benurapriyanidirisinghe/VOLT/src/volt_description/urdf/stl/mainbody.stl

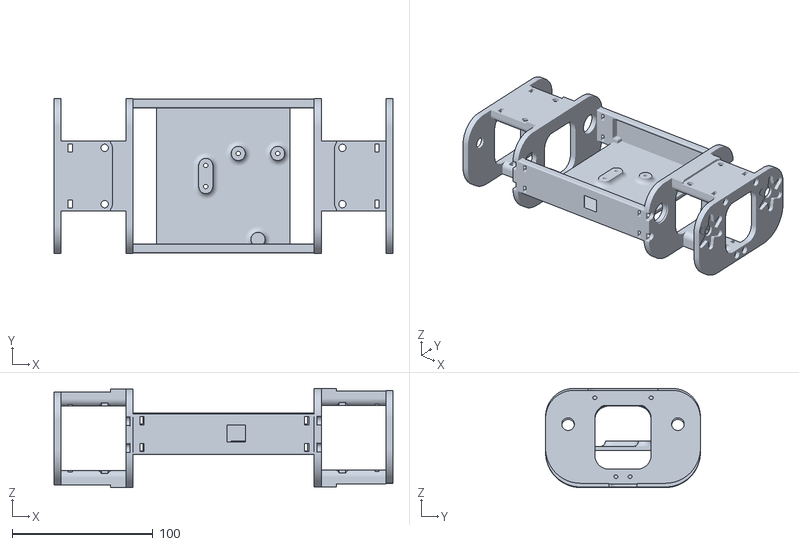
[picture p1: CAD file, 2026-07-06]
src/volt_description/urdf/stl/mainbody.stl
240.7 x 110.0 x 70.4
