benurapriyanidirisinghe/VOLT/src/volt_description/urdf/stl/rplidar_main.stl

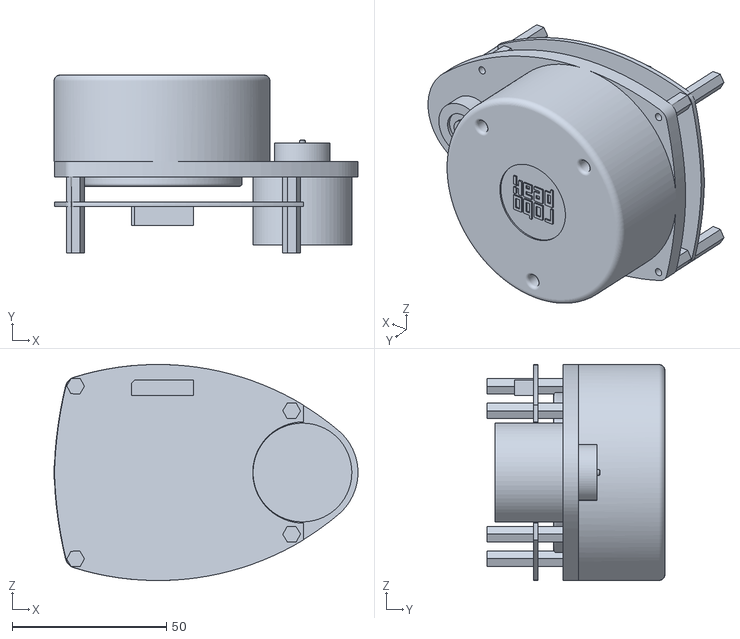
[picture p2: CAD file, 2026-07-06]
src/volt_description/urdf/stl/rplidar_main.stl
98.5 x 57.7 x 70.0
