benurapriyanidirisinghe/VOLT/src/volt_description/urdf/stl/rarm.stl

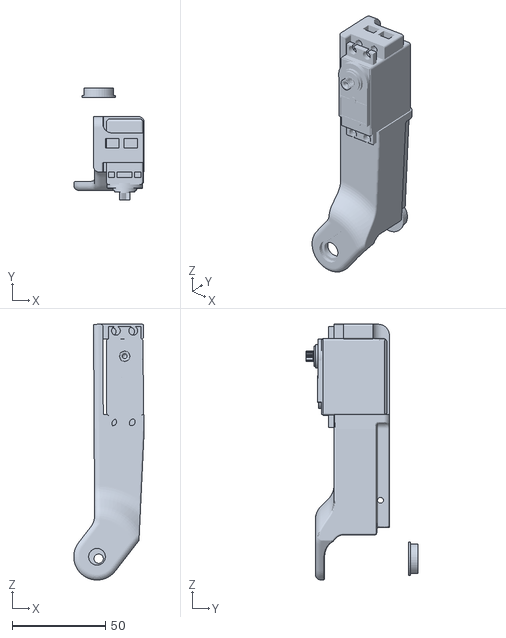
[picture p3: CAD file, 2026-07-06]
src/volt_description/urdf/stl/rarm.stl
37.9 x 60.2 x 137.5
