benurapriyanidirisinghe/VOLT/src/volt_description/urdf/stl/rarm_cover.stl

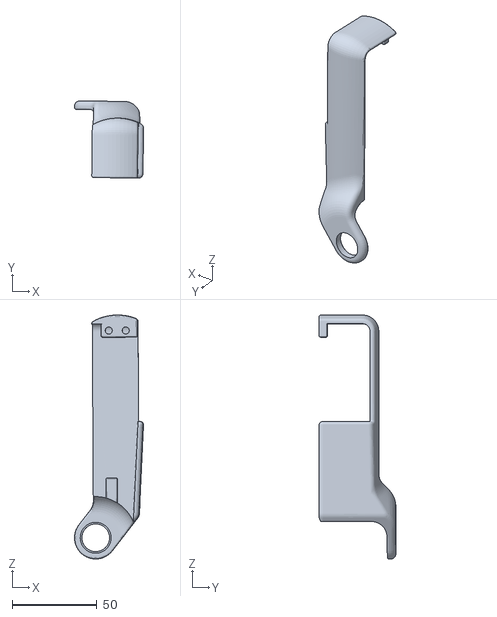
[picture p4: CAD file, 2026-07-06]
src/volt_description/urdf/stl/rarm_cover.stl
40.7 x 45.4 x 143.6
