benurapriyanidirisinghe/VOLT/src/volt_description/urdf/stl/foot.stl

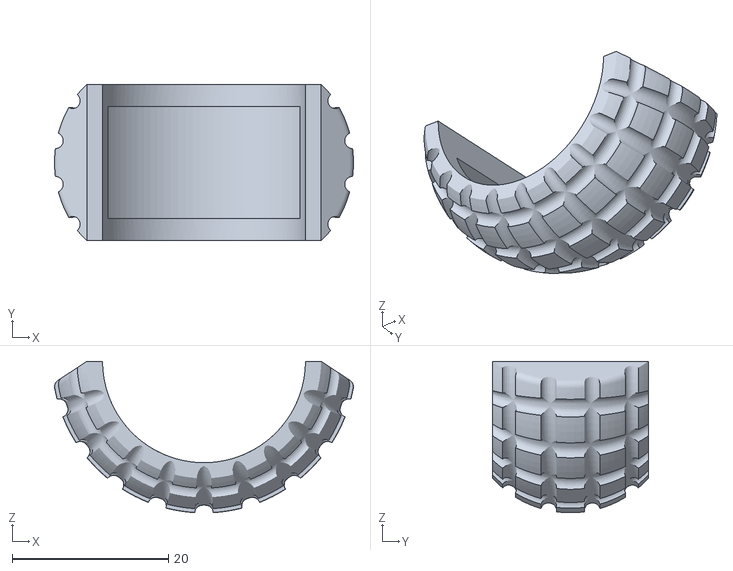
[picture p5: CAD file, 2026-07-06]
src/volt_description/urdf/stl/foot.stl
38.3 x 20.0 x 19.4
