benurapriyanidirisinghe/VOLT/src/volt_description/urdf/stl/backpart.stl

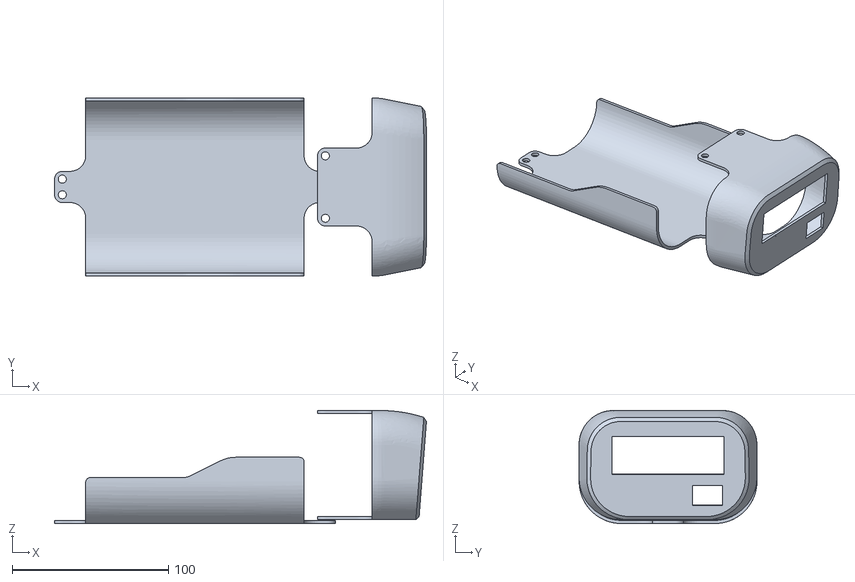
[picture p6: CAD file, 2026-07-06]
src/volt_description/urdf/stl/backpart.stl
238.4 x 114.1 x 72.5
