benurapriyanidirisinghe/VOLT/src/volt_description/urdf/stl/rshoulder.stl

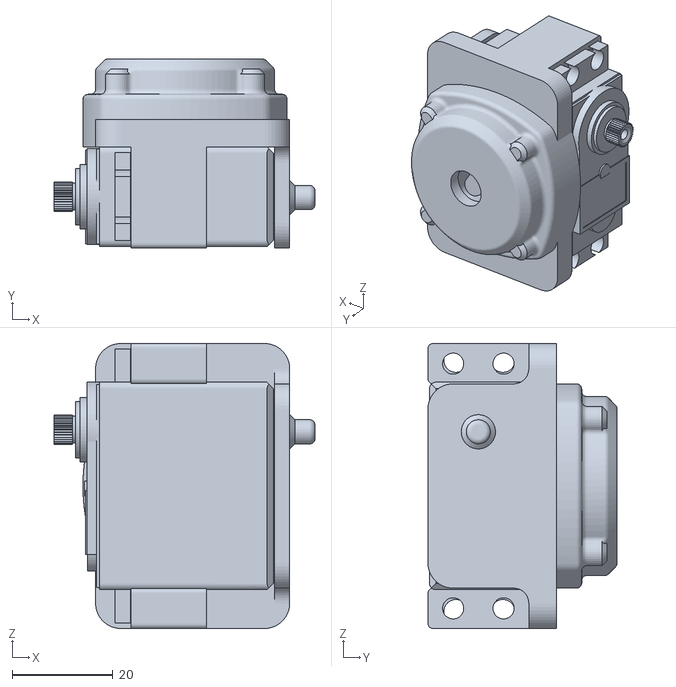
[picture p7: CAD file, 2026-07-06]
src/volt_description/urdf/stl/rshoulder.stl
51.7 x 37.5 x 56.5
