benurapriyanidirisinghe/VOLT/src/volt_description/urdf/stl/lfoot.stl

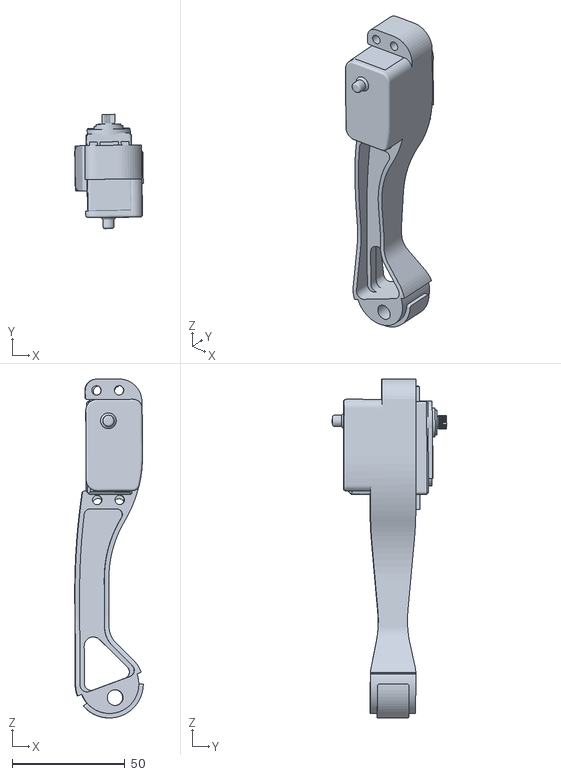
[picture p8: CAD file, 2026-07-06]
src/volt_description/urdf/stl/lfoot.stl
30.4 x 50.7 x 150.0
