benurapriyanidirisinghe/VOLT/src/volt_description/urdf/stl/frontpart.stl

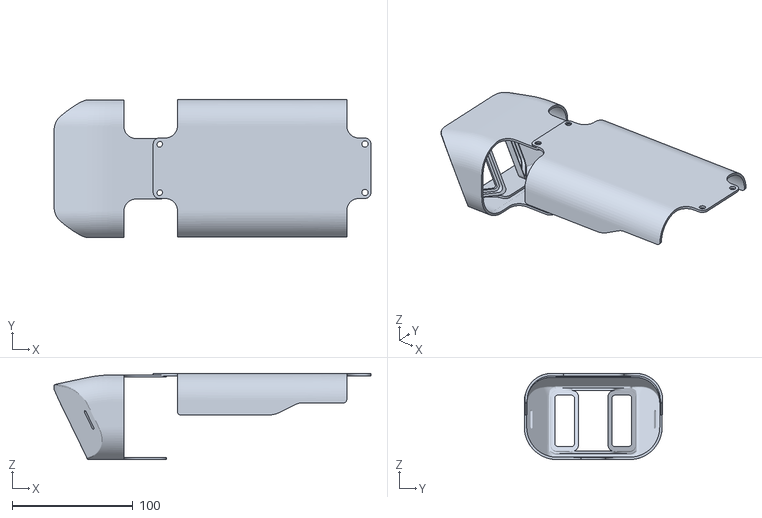
[picture p9: CAD file, 2026-07-06]
src/volt_description/urdf/stl/frontpart.stl
262.0 x 114.5 x 71.2
