benurapriyanidirisinghe/VOLT/(list of files, cad)

Other CAD files:
src/volt_description/urdf/stl/larm_cover.stl
src/volt_description/urdf/stl/rfoot.stl
src/volt_description/urdf/stl/larm.stl
src/volt_description/urdf/stl/lshoulder.stl
