benurapriyanidirisinghe/VOLT/src/volt_description/urdf/volt.urdf.xacro

<?xml version="1.0"?>
<robot xmlns:xacro="http://www.ros.org/wiki/xacro" name="spot_micro_rviz">

<xacro:include filename="$(find volt_description)/urdf/ros2_control.xacro"/>
<xacro:include filename="$(find volt_description)/urdf/gazebo.xacro"/>

<xacro:arg name="sim_backend" default="gz"/>
<xacro:arg name="actuator_profile" default="simulation"/>

  <material name="yellow">
    <color rgba="0.92 0.83 0.0 1"/>
  </material>
  <material name="black">
    <color rgba="0.1 0.1 0.1 1"/>
  </material>
  <material name="grey">
    <color rgba="0.6 0.6 0.6 1"/>
  </material>

  <!-- Params -->

  <!-- Keep the proven simulation profile as default.  The opt-in td8130mg
       profile models the physical servo under load: velocity capped at the
       firmware's 240 deg/s slew ceiling (4.1888 rad/s; the servo free speed
       is ~375 deg/s so firmware is the binding limit), effort capped at a
       derated 2.8 N.m stall torque (TD-8130MG ~30 kg.cm at 6 V).  With the
       stiffer tracking gain in ros2_control.xacro the effort clamp - not an
       artificially soft gain - becomes what slows a loaded joint, so Gazebo
       reproduces load-dependent tracking lag.  ROS/IK joint limits and
       physical calibration are unchanged. -->
  <xacro:property name="hardware_actuators" value="${'$(arg actuator_profile)' == 'td8130mg'}"/>
  <xacro:property name="shoulder_velocity" value="${4.1888 if hardware_actuators else 2.0}"/>
  <xacro:property name="leg_velocity" value="${4.1888 if hardware_actuators else 3.0}"/>
  <xacro:property name="foot_velocity" value="${4.1888 if hardware_actuators else 4.5}"/>
  <xacro:property name="joint_effort" value="${2.8 if hardware_actuators else 20.0}"/>
  <xacro:property name="joint_damping" value="${0.35 if hardware_actuators else 0.6}"/>
  <xacro:property name="joint_friction" value="${0.10 if hardware_actuators else 0.1}"/>

  <xacro:property name="body_length" value="0.140" />
  <xacro:property name="body_width" value="0.110" />
  <xacro:property name="body_height" value="0.070" />

  <xacro:property name="lidar_length" value="0.0985" />
  <xacro:property name="lidar_width" value="0.0577" />
  <xacro:property name="lidar_height" value="0.070" />


  <xacro:property name="front_length" value="0.058" />
  <xacro:property name="rear_length" value="0.040" />

  <xacro:property name="shoulder_length" value="0.044" />
  <xacro:property name="shoulder_width" value="0.038" />

  <xacro:property name="leg_length" value="0.1075" />
  <xacro:property name="foot_length" value="0.130" />

  <xacro:property name="toe_radius" value="0.020" />
  <!--  <xacro:property name="toe_radius" value="0.014" /> -->
  <xacro:property name="toe_width" value="0.020" />
  <xacro:property name="shift" value="0.055" />
  <xacro:property name="shiftx" value="0.093" />
  <xacro:property name="shifty" value="0.039" />

  <!-- Macros -->

  <xacro:macro name="gen_shoulder" params="name left">
    <link name="${name}">
      <visual>
        <xacro:if value="${left}">
        <geometry>
          <mesh filename="package://volt_description/urdf/stl/lshoulder.stl" scale="0.001 0.001 0.001"/>
        </geometry>
        <origin rpy="0 0 3.14159" xyz="0.135 0.015 -0.01"/>
        </xacro:if>
        <xacro:unless value="${left}">
        <geometry>
          <mesh filename="package://volt_description/urdf/stl/rshoulder.stl" scale="0.001 0.001 0.001"/>
        </geometry>
        <origin rpy="0 0 3.14159" xyz="0.135 0.095 -0.01"/>
        </xacro:unless>
        <material name="black"/>
      </visual>
      <collision>
        <geometry>
          <box size="${shoulder_length} ${shoulder_width} ${body_height}"/>
        </geometry>
        <origin rpy="0 0 0" xyz="0 0 0"/>
      </collision>
      <inertial>
        <mass value="0.10"/>
        <inertia ixx="0.0002" ixy="0" ixz="0" iyy="0.0002" iyz="0" izz="0.0002" />
      </inertial>
    </link>
  </xacro:macro>

  <xacro:macro name="gen_shoulder_joint" params="pos shiftx shifty">
    <joint name="${pos}_shoulder" type="revolute">
      <parent link="base_link"/>
      <child link="${pos}_shoulder_link"/>
      <axis xyz="1 0 0"/>
      <origin rpy="0 0 0" xyz="${shiftx} ${shifty} 0"/>
      <limit effort="${joint_effort}" lower="-0.548" upper="0.548" velocity="${shoulder_velocity}"/>
      <dynamics damping="${joint_damping}" friction="${joint_friction}"/>
    </joint>
  </xacro:macro>

  <xacro:macro name="gen_leg" params="name left">
    <link name="${name}_cover">
      <visual>
        <xacro:if value="${left}">
        <geometry>
          <mesh filename="package://volt_description/urdf/stl/larm_cover.stl" scale="0.001 0.001 0.001"/>
        </geometry>
        <origin rpy="0 -0.139 3.14159" xyz="0.130 -0.040 -0.025"/>
        </xacro:if>
        <xacro:unless value="${left}">
        <geometry>
          <mesh filename="package://volt_description/urdf/stl/rarm_cover.stl" scale="0.001 0.001 0.001"/>
        </geometry>
        <origin rpy="0 -0.139 3.14159" xyz="0.130 0.15 -0.025"/>
        </xacro:unless>
        <material name="grey"/>
      </visual>
    </link>
    <link name="${name}">
      <visual>
        <xacro:if value="${left}">
        <geometry>
          <mesh filename="package://volt_description/urdf/stl/larm.stl" scale="0.001 0.001 0.001"/>
        </geometry>
        <origin rpy="0 -0.139 3.14159" xyz="0.130 -0.040 -0.025"/>
        </xacro:if>
        <xacro:unless value="${left}">
        <geometry>
          <mesh filename="package://volt_description/urdf/stl/rarm.stl" scale="0.001 0.001 0.001"/>
        </geometry>
        <origin rpy="0 -0.139 3.14159" xyz="0.130 0.15 -0.025"/>
        </xacro:unless>
        <material name="black"/>
<!--        <geometry>
          <box size="0.028 0.036 ${leg_length}"/>
        </geometry>
        <origin rpy="0.0 0.0 0.0" xyz="0.0 0.0 -0.050"/>
        <material name="yellow"/>-->
      </visual>
      <collision>
        <origin rpy="0.0 0.0 0.0" xyz="0.0 0.0 -0.050"/>
        <geometry>
          <box size="0.028 0.036 ${leg_length}"/>
        </geometry>
      </collision>
      <inertial>
        <mass value="0.15"/>
        <inertia ixx="0.0003" ixy="0" ixz="0" iyy="0.0003" iyz="0" izz="0.0003" />
      </inertial>
    </link>
  </xacro:macro>

  <xacro:macro name="gen_leg_joint" params="pos shift">
    <joint name="${pos}_leg" type="revolute">
      <parent link="${pos}_shoulder_link"/>
      <child link="${pos}_leg_link"/>
      <axis xyz="0 1 0"/>
      <origin rpy="0 0 0" xyz="0 ${shift} 0"/>
      <limit effort="${joint_effort}" lower="-2.666" upper="1.548" velocity="${leg_velocity}"/>
      <dynamics damping="${joint_damping}" friction="${joint_friction}"/>
    </joint>

    <joint name="${pos}_leg_cover_joint" type="fixed">
    <parent link="${pos}_leg_link"/>
    <child link="${pos}_leg_link_cover"/>
        <origin xyz="0 0 0"/>
  </joint>  
  </xacro:macro>

  <xacro:macro name="gen_foot" params="name left">
    <link name="${name}">
      <visual>
        <xacro:if value="${left}">
        <geometry>
          <mesh filename="package://volt_description/urdf/stl/lfoot.stl" scale="0.001 0.001 0.001"/>
        </geometry>
        <origin rpy="0 0 3.14159" xyz="0.120 -0.04 0.1"/>
        </xacro:if>
        <xacro:unless value="${left}">
        <geometry>
          <mesh filename="package://volt_description/urdf/stl/rfoot.stl" scale="0.001 0.001 0.001"/>
        </geometry>
        <origin rpy="0 0 3.14159" xyz="0.120 0.15 0.1"/>
        </xacro:unless>
        <material name="black"/>
      </visual>
      <collision>
        <geometry>
          <box size="0.026 0.020 ${foot_length}"/>
        </geometry>
        <origin rpy="0.0 0.0 0.0" xyz="0.0 0.0 -0.050"/>
      </collision>
      <inertial>
        <mass value="0.1"/>
        <inertia ixx="0.0003" ixy="0" ixz="0" iyy="0.0003" iyz="0" izz="0.0003" />
      </inertial>
    </link>
  </xacro:macro>

  <xacro:macro name="gen_foot_joint" params="pos">
    <joint name="${pos}_foot" type="revolute">
      <parent link="${pos}_leg_link"/>
      <child link="${pos}_foot_link"/>
      <axis xyz="0 1 0"/>
      <origin rpy="0 0 0" xyz="0 0 -${leg_length}"/>
      <limit effort="${joint_effort}" lower="-2.6" upper="0.1" velocity="${foot_velocity}"/>
      <dynamics damping="${joint_damping}" friction="${joint_friction}"/>
    </joint>
  </xacro:macro>

  <xacro:macro name="gen_toe" params="name">
    <link name="${name}">
      <visual>
        <geometry>
        <mesh filename="package://volt_description/urdf/stl/foot.stl" scale="0.001 0.001 0.001"/>
        </geometry>
        <origin rpy="0 -0.40010 3.14159" xyz="0.00 0.01 0.015"/>
        <material name="grey"/>
      </visual>
      <collision>
        <geometry>
          <sphere radius="${toe_radius}" />
        </geometry>
        <origin rpy="0 0 0" xyz="0 0 ${toe_radius}"/>
        <contact_coefficients mu="1.1" />
      </collision>
      <inertial>
        <mass value="0.05"/>
        <inertia ixx="0.00003" ixy="0" ixz="0" iyy="0.00003" iyz="0" izz="0.00003" />
      </inertial>
    </link>
  </xacro:macro>

 <xacro:macro name="gen_toe_joint" params="pos">
    <joint name="${pos}_toe" type="fixed">
      <parent link="${pos}_foot_link"/>
      <child link="${pos}_toe_link"/>
      <origin xyz="0 0 -${foot_length}"/>
    </joint>
  </xacro:macro>

  <xacro:macro name="gen_full_leg_joint" params="pos shiftx shifty shift left">
    <xacro:gen_shoulder name="${pos}_shoulder_link" left="${left}"/>
    <xacro:gen_leg name="${pos}_leg_link" left="${left}"/>
    <xacro:gen_foot name="${pos}_foot_link" left="${left}"/>
    <xacro:gen_toe name="${pos}_toe_link"/>

    <xacro:gen_shoulder_joint pos="${pos}" shiftx="${shiftx}" shifty="${shifty}"/>
    <xacro:gen_leg_joint pos="${pos}" shift="${shift}"/>
    <xacro:gen_foot_joint pos="${pos}"/>
    <xacro:gen_toe_joint pos="${pos}"/>
  </xacro:macro>

  <!-- Robot Body -->

  <link name="base_link">
    <visual>
      <geometry>
        <mesh filename="package://volt_description/urdf/stl/mainbody.stl" scale="0.001 0.001 0.001"/>
      </geometry>
      <material name="black"/> 
      <origin rpy="0 0 0" xyz="-0.042 -0.055 -0.010"/>
    </visual>
    <collision>
      <geometry>
        <box size="${body_length} ${body_width} ${body_height}"/>
      </geometry>
      <origin rpy="0 0 0" xyz="0 0 0"/>
    </collision>
    <inertial>
      <mass value="2.80"/>
      <inertia ixx="0.03" ixy="0" ixz="0" iyy="0.04" iyz="0" izz="0.05" />
    </inertial>
  </link>

  <!-- Lidar Backpack -->

   <link name="lidar_link">
    <visual>
      <geometry>
        <mesh filename="package://volt_description/urdf/stl/rplidar_main.stl" scale="0.001 0.001 0.001"/>
      </geometry>
      <material name="black"/> 
      <origin rpy="1.57075 0 0" xyz="${-lidar_length/2+0.015} ${lidar_width/2+0.007} 0"/>
    </visual>
    <collision>
      <geometry>
        <box size="${lidar_length} ${lidar_width} ${lidar_height}"/>
      </geometry>
      <origin rpy="0 0 0" xyz="0 0 0"/>
    </collision>
    <inertial>
      <mass value="0.50"/>
      <inertia ixx="0.001" ixy="0" ixz="0" iyy="0.001" iyz="0" izz="0.001" />
    </inertial>
  </link>
  <joint name="base_lidar" type="fixed">
    <parent link="base_link"/>
    <child link="lidar_link"/>
        <origin xyz="0 0 ${body_height/2}"/>
  </joint>  

  <link name="rear_link">
    <visual>
      <geometry>
        <mesh filename="package://volt_description/urdf/stl/backpart.stl" scale="0.001 0.001 0.001"/>
      </geometry>
      <origin rpy="0 0 3.14159" xyz="-0.032 -0 -0.035"/>
      <material name="grey"/>
    </visual>
    <collision>
      <geometry>
        <box size="${rear_length} ${body_width} ${body_height}"/>
      </geometry>
      <origin rpy="0 0 0" xyz="0.135 0 0"/>
    </collision>
    <inertial>
      <mass value="0.20"/>
      <inertia ixx="0.002" ixy="0" ixz="0" iyy="0.002" iyz="0" izz="0.002" />
    </inertial>
  </link>
  <joint name="base_rear" type="fixed">
    <parent link="base_link"/>
    <child link="rear_link"/>
  </joint>

  <link name="front_link">
    <visual>
      <geometry>
        <mesh filename="package://volt_description/urdf/stl/frontpart.stl" scale="0.001 0.001 0.001"/>
      </geometry>
      <origin rpy="0 0 3.14159" xyz="0.040 0.055 -0.010"/>
      <material name="grey"/>
    </visual>
    <collision>
      <geometry>
        <box size="${front_length} ${body_width} ${body_height}"/>
      </geometry>
      <origin rpy="0 0 0" xyz="-0.145 0 0"/>
    </collision>
    <inertial>
      <mass value="0.20"/>
      <inertia ixx="0.002" ixy="0" ixz="0" iyy="0.002" iyz="0" izz="0.002" />
    </inertial>
  </link>
  <joint name="base_front" type="fixed">
    <parent link="base_link"/>
    <child link="front_link"/>
  </joint>

  <!-- create Legs -->

  <xacro:gen_full_leg_joint pos="front_left" shiftx="${shiftx}" shifty="${shifty}" shift="${shift}" left="true"/>
  <xacro:gen_full_leg_joint pos="front_right" shiftx="${shiftx}" shifty="-${shifty}" shift="-${shift}" left="false"/>
  <xacro:gen_full_leg_joint pos="rear_left" shiftx="-${shiftx}" shifty="${shifty}" shift="${shift}" left="true"/>
  <xacro:gen_full_leg_joint pos="rear_right" shiftx="-${shiftx}" shifty="-${shifty}" shift="-${shift}" left="false"/>
  <xacro:volt_ros2_control sim_backend="$(arg sim_backend)"/>
</robot>
