benurapriyanidirisinghe/VOLT/src/volt_description/config/real_robot_profiles.yaml

version: 1

# Canonical SI units except fields explicitly suffixed with _deg.  These are
# trajectory/conditioning values only; servo calibration remains in
# servo_calibration.yaml.  Every profile's gait overlay must re-pass the
# gait engine's servo-budget sweep when applied, so a profile cannot demand
# joint speeds the TD-8130MG cannot deliver under load.
profiles:
  SIMULATION:
    gait: trot
    cycle_duration: 1.10
    stride_length: 0.070
    lateral_stride_width: 0.020
    step_height: 0.024
    duty_factor: 0.58
    body_height: 0.200
    body_x: 0.0
    body_y: 0.0
    body_roll_deg: 0.0
    body_pitch_deg: 0.0
    body_yaw_deg: 0.0
    max_joint_velocity_deg_s: 190.0
    max_joint_acceleration_deg_s2: 6000.0
    smoothing_amount: 0.0
    touchdown_softness: 0.18
    stance_width: 0.104
    command_acceleration: 0.08
    velocity_filter_alpha: 0.30

  # First loaded-floor profile: lateral-sequence amble, one leg at a time,
  # three feet always planted, small stride, bounded servo dynamics.
  REAL_DIAGNOSTIC:
    gait: amble
    cycle_duration: 2.40
    stride_length: 0.030
    lateral_stride_width: 0.010
    step_height: 0.022
    duty_factor: 0.80
    # DO NOT raise this without checking the resulting SERVO angles against the
    # leg's mechanical range, not just the software limits.
    #
    # 0.210 was tried here because a straighter leg has a shorter knee moment
    # arm, dropping the front-knee load from 1.855 N.m (105% of usable stall)
    # to 1.317 N.m (75%). The IK accepted it and every software limit passed --
    # but it drove the knee servos about 30 deg past any angle the robot had
    # ever run at: ch5 went from 92.8..112.8 to 116.2..143.2 against a stand
    # pose of 118.05. The front-right foot hit its mechanical stop and jammed.
    #
    # servo_calibration.yaml's [30,180] for ch5/ch8 is the servo's nominal
    # travel, NOT the linkage's usable range, so it did not catch this. At
    # 0.200 the knees command 99.9..120.0, which is the band the robot has
    # demonstrably operated in.
    body_height: 0.200
    body_x: 0.0
    body_y: 0.0
    body_roll_deg: 0.0
    body_pitch_deg: 0.0
    body_yaw_deg: 0.0
    # Raised from 100 / 2400, which silently truncated the commanded gait:
    # the amble peaks at 139 deg/s and the trot at 176 deg/s, so the old
    # clamps discarded motion on 4.7% and 10.7% of joint-samples per cycle.
    # 190 / 6000 matches the SIMULATION profile and stays under the firmware
    # slew ceiling of 240 deg/s, so nothing is asked to exceed its tuning.
    max_joint_velocity_deg_s: 190.0
    max_joint_acceleration_deg_s2: 6000.0
    smoothing_amount: 0.15
    touchdown_softness: 0.30
    stance_width: 0.104
    command_acceleration: 0.06
    velocity_filter_alpha: 0.25

  REAL_SAFE:
    gait: trot
    cycle_duration: 1.20
    stride_length: 0.045
    lateral_stride_width: 0.008
    step_height: 0.024
    duty_factor: 0.62
    body_height: 0.195
    body_x: -0.004
    body_y: 0.0
    body_roll_deg: 0.0
    body_pitch_deg: 1.0
    body_yaw_deg: 0.0
    max_joint_velocity_deg_s: 150.0
    max_joint_acceleration_deg_s2: 3600.0
    smoothing_amount: 0.12
    touchdown_softness: 0.28
    stance_width: 0.104
    command_acceleration: 0.08
    velocity_filter_alpha: 0.30

  REAL_NORMAL:
    gait: trot
    cycle_duration: 1.05
    stride_length: 0.055
    lateral_stride_width: 0.012
    step_height: 0.024
    duty_factor: 0.58
    body_height: 0.195
    body_x: -0.003
    body_y: 0.0
    body_roll_deg: 0.0
    body_pitch_deg: 1.0
    body_yaw_deg: 0.0
    max_joint_velocity_deg_s: 175.0
    max_joint_acceleration_deg_s2: 4800.0
    smoothing_amount: 0.10
    touchdown_softness: 0.24
    stance_width: 0.104
    command_acceleration: 0.08
    velocity_filter_alpha: 0.30
