benurapriyanidirisinghe/VOLT/src/volt_description/scripts/volt_gait_controller.py

#!/usr/bin/env python3

"""VOLT gait engine: two servo-budgeted gaits with world-locked stance.

Ground-up rebuild.  The previous engine carried nine gaits across four code
paths; walking quality on the real robot was limited not by the trajectory
shapes but by physics that none of those paths modeled: a TD-8130MG under
load does not track an arbitrary command.  This engine keeps exactly two
gaits and builds the servo's speed-torque reality into the *configuration
contract* instead of hoping the firmware slew limiter cleans up after an
infeasible plan.

Gaits
-----
``trot``   Two-beat diagonal gait (FL+RR / FR+RL half a cycle apart) with a
           duty factor above 0.5, so short four-foot support windows exist
           for load transfer between diagonal pairs.
``amble``  Four-beat lateral-sequence walk (RL, FL, RR, FR each a quarter
           cycle apart) with a high duty factor -- three feet are always
           planted -- plus a lateral body sway that leans the body away
           from whichever side is swinging.

Servo budget
------------
The physical insight the old engine missed: the *swing* leg is unloaded (it
carries only its own inertia, so the servo runs near its ~375 deg/s free
speed), while the *stance* legs carry the body but rotate slowly.  The
budgets therefore differ per phase:

  stance joints (loaded):    <= 80 deg/s commanded
  swing joints (unloaded):   <= 190 deg/s commanded (firmware ceiling 240)

``validate_servo_budget`` numerically sweeps one full cycle at the gait's
maximum command through the real IK and rejects any configuration whose
commanded joint speeds break those budgets.  A gait config that loads is a
gait config the servos can execute; nothing downstream needs to clip.

World locking
-------------
During stance a foot holds a fixed *world* point while the integrated body
pose moves over it, so planted feet cannot skate.  Swing targets are frozen
world-frame touchdown points computed from the commanded twist when the
foot lifts; command changes never jerk an airborne foot.
"""

import math
from pathlib import Path

import yaml

from volt_kinematics import (
    LEG_ORDER,
    JOINT_NAMES,
    NOMINAL_FEET,
    clamp,
    feet_to_joint_positions_diagnostic,
    smootherstep,
)


# --------------------------------------------------------------------------
# Public constants
# --------------------------------------------------------------------------

TROT_PHASE_OFFSETS = {
    "front_left": 0.0,
    "rear_right": 0.0,
    "front_right": 0.5,
    "rear_left": 0.5,
}

# Lateral-sequence amble: each hind foot is followed by the fore foot on the
# SAME side.  Listed below in swing order, because the leg with the largest
# offset reaches the duty boundary first:  RR -> FR -> RL -> FL.
#
# The previous table had the offsets reversed within each side pair, so the
# fore foot led the hind and the robot walked a diagonal-sequence gait
# (hind followed by the OPPOSITE fore) despite the comment claiming lateral.
# validate_phase_structure() now fails at import if that recurs.
#
# The half-cycle grouping matters for the body sway in _body_motion(): both
# right feet swing during the first half cycle and both left feet during the
# second, which is what lets a plain sine of the cycle phase lean the body
# away from whichever side is currently swinging.
AMBLE_PHASE_OFFSETS = {
    "rear_right": 0.75,
    "front_right": 0.5,
    "rear_left": 0.25,
    "front_left": 0.0,
}

# Every historical gait name maps onto one of the two surviving gaits so
# saved profiles, old GUI messages, and muscle memory keep working.
GAIT_ALIASES = {
    "walk": "amble",
    "slow_crawl": "amble",
    "diagnostic_crawl": "amble",
    "spot_walk": "amble",
    "spotmicro_video_walk": "amble",
    "legacy_walk": "amble",
    "real_trot": "trot",
    "load_safe_trot": "trot",
    "real_safe_trot": "trot",
    "slow_trot": "trot",
    "normal_trot": "trot",
    "fast_trot": "trot",
}

# RUN is a trot pattern, not a new coordination: the same diagonal pairs, run
# faster and with a shorter stance.  A true run needs duty < 0.5 and a flight
# phase; on open-loop hobby servos with a documented saturation history that
# is approached in steps, not declared.  It ships at the fastest cadence the
# servo budget will accept.
RUN_PHASE_OFFSETS = dict(TROT_PHASE_OFFSETS)

GAIT_PHASE_OFFSETS = {
    "trot": TROT_PHASE_OFFSETS,
    "amble": AMBLE_PHASE_OFFSETS,
    "run": RUN_PHASE_OFFSETS,
}

# Config keys: every gait section must provide exactly these numeric fields.
GAIT_PARAMETER_NAMES = (
    "cycle_period",
    "duty_factor",
    "step_height",
    "max_x",
    "max_y",
    "max_yaw",
    "settle_time",
    "body_sway_y",
    "body_height_offset",
    "velocity_filter_alpha",
    "command_acceleration",
    "hardware_speed_scale",
    "joint_velocity_limit_deg_s",
    "joint_acceleration_limit_deg_s2",
    "stance_velocity_budget_deg_s",
    "swing_velocity_budget_deg_s",
    # Speed-scaled cadence. See resolved_cadence().
    "speed_scaled_cadence",
    "stride_target_m",
    "cadence_min_hz",
    "stride_floor_m",
    # Additive heading bias; see the yaw-trim note in validate_servo_budget.
    "yaw_trim_limit_rad_s",
    # Push the supporting diagonal up while the other pair swings.
    "stance_push_m",
)

def _phase_separation(first, second):
    """Circular distance between two phase offsets, in cycles (0 .. 0.5)."""
    diff = abs(float(first) - float(second)) % 1.0
    return min(diff, 1.0 - diff)


def _swing_order(offsets):
    """Legs in the order their swings begin.

    A leg's local phase is (global phase + its offset) and swing starts once
    that crosses the duty boundary, so the leg with the LARGEST offset
    reaches the boundary first.
    """
    return sorted(offsets, key=lambda leg: -offsets[leg])


def validate_phase_structure(name, offsets):
    """Assert a gait's phase table really encodes the coordination it claims.

    A permuted phase table is not malformed -- it is four valid numbers in
    the wrong places -- so nothing downstream can catch it, and the failure
    mode is silent: the robot walks, just in the wrong gait. (Measured on
    hardware: a trot whose legs are exchanged at one end becomes a pace, and
    every length and finiteness check on the command path still passes.)
    These checks make that specific class of regression fail at import.
    """
    if set(offsets) != set(LEG_ORDER):
        raise ValueError(
            "%s phase table must cover exactly %s" % (name, list(LEG_ORDER))
        )

    if name in ("trot", "run"):
        # Two-beat: diagonal partners strike together, and the two diagonal
        # pairs are half a cycle apart (which also makes each ipsilateral
        # pair half a cycle apart -- the property that distinguishes a trot
        # from a pace).
        for a, b in (("front_left", "rear_right"), ("front_right", "rear_left")):
            gap = _phase_separation(offsets[a], offsets[b])
            if gap > 0.02:
                raise ValueError(
                    "%s: diagonal pair %s/%s is %.3f cycles apart, expected 0 "
                    "(a trot strikes diagonal feet together)"
                    % (name, a, b, gap)
                )
        for a, b in (("front_left", "rear_left"), ("front_right", "rear_right")):
            gap = _phase_separation(offsets[a], offsets[b])
            if abs(gap - 0.5) > 0.02:
                raise ValueError(
                    "%s: ipsilateral pair %s/%s is %.3f cycles apart, expected "
                    "0.5 -- same-side legs moving together is a PACE, not a "
                    "two-beat diagonal gait"
                    % (name, a, b, gap)
                )
        return True

    if name == "amble":
        # Four-beat: one foot at a time, evenly spaced, and in lateral
        # sequence -- each hind foot followed by the fore foot on the SAME
        # side. The alternative (hind followed by the opposite fore) is a
        # diagonal-sequence walk, which is a different gait with different
        # support polygons, so it must not be reachable by accident.
        order = _swing_order(offsets)
        spacing = sorted(offsets.values())
        for index in range(1, len(spacing)):
            step = spacing[index] - spacing[index - 1]
            if abs(step - 0.25) > 0.02:
                raise ValueError(
                    "%s: offsets %s are not evenly spaced a quarter cycle "
                    "apart, so the four beats are not equally timed"
                    % (name, spacing)
                )
        for index, leg in enumerate(order):
            following = order[(index + 1) % len(order)]
            if leg.startswith("rear_"):
                expected = "front_" + leg.split("_", 1)[1]
                if following != expected:
                    raise ValueError(
                        "%s: swing order %s is not a lateral sequence -- %s is "
                        "followed by %s, but a lateral-sequence walk follows a "
                        "hind foot with the fore foot on the same side (%s)"
                        % (name, order, leg, following, expected)
                    )
        return True

    raise ValueError("no phase-structure contract defined for gait %r" % name)


_MOTION_LINEAR_DEADBAND = 0.002   # m/s
_MOTION_YAW_DEADBAND = 0.010      # rad/s

NOMINAL_FEET_Z = next(iter(NOMINAL_FEET.values()))[2]

# The servo-budget sweep validates against the lowest standing height any
# shipped real profile uses; a lower body means more knee flexion and higher
# joint speeds for the same foot motion, so this is the conservative case.
_BUDGET_SWEEP_HEIGHT = 0.195
# The sweep samples at the controller's real command period.  Acceleration
# at the C1 stance/swing boundaries is a per-tick velocity step, so its
# magnitude depends on the sampling rate; validating at a finer dt than the
# controller uses would reject boundary impulses the 100 Hz command stream
# never actually contains.
_BUDGET_SWEEP_DT = 0.010


def smoothstep(value):
    """Cubic ease with zero end velocity.

    Chosen over smootherstep for swing transfer deliberately: its peak
    slope is 1.5 versus 1.875, which lowers the commanded peak joint speed
    of the unloaded swing leg by ~20% for the same step and swing time.
    The acceleration discontinuity at the ends is absorbed by the firmware's
    50 Hz interpolation and the servo's own lag.
    """
    value = clamp(value, 0.0, 1.0)
    return value * value * (3.0 - 2.0 * value)


def resolved_cadence(config, velocity):
    """Cadence in Hz for a commanded twist: FREQUENCY carries the speed.

    The old engine ran a fixed cadence and expressed the whole speed command
    as stride length, so a half-speed command took the same number of steps
    at half the size.  On this open-loop robot that is the difference
    between walking and not: a 29.6 mm stride is recorded in
    gait_controller.yaml as having "run on the spot" because stance slip and
    ~18 mm of servo droop consume a step that small, and the default 20%
    slider resolved to a 20.8 mm trot stride -- below that floor.  The
    motors load up, the legs cycle, and the robot does not travel.

    So hold the stride and move the cadence:

        f = clamp(|v| * duty / stride_target, cadence_min_hz, 1/cycle_period)

    At the gait's own maximum command this returns exactly 1/cycle_period,
    which is the operating point validate_servo_budget sweeps -- so the
    servo budget still bounds the fastest case.  Below it the cadence drops
    and the stride stays at stride_target until cadence_min_hz is reached;
    under that the stride shrinks again, which is what stride_floor_m and
    the GUI's slider floor exist to keep the operator out of.

    Slower is also safer here: stance joint rate depends on |v| alone, and
    swing rate scales with cadence, so every point below the maximum sits
    strictly inside the budget the maximum already passed.
    """
    if not config.get("speed_scaled_cadence", False):
        return 1.0 / config["cycle_period"]
    speed = fastest_foot_speed(velocity)
    cadence_max = 1.0 / config["cycle_period"]
    target = config.get("stride_target_m", 0.0)
    if target <= 0.0:
        return cadence_max
    return clamp(
        speed * config["duty_factor"] / target,
        config["cadence_min_hz"],
        cadence_max,
    )


def fastest_foot_speed(velocity):
    """Stance speed of the fastest foot for a twist (m/s).

    NOT the body's linear speed.  A stance foot moves at
    ``(vx - wz*y, vy + wz*x)`` in the body frame, so under yaw the outer
    feet travel considerably faster than the body: at the mixed command the
    budget sweep uses, a front foot runs 0.044 m/s against a body speed of
    0.032.  The cadence law has to size the cycle by whichever foot has the
    furthest to go, or that foot overruns stride_target and walks itself out
    of the reachable workspace -- which is exactly what the full-cycle IK
    test caught when this used hypot(vx, vy).
    """
    vx, vy, wz = (float(value) for value in velocity)
    return max(
        math.hypot(vx - wz * NOMINAL_FEET[leg][1], vy + wz * NOMINAL_FEET[leg][0])
        for leg in LEG_ORDER
    )


def resolved_stride(config, velocity):
    """Stance excursion (m) of the fastest foot under the cadence law."""
    return fastest_foot_speed(velocity) * config["duty_factor"] / max(
        resolved_cadence(config, velocity), 1e-6
    )


def minimum_speed_for_stride(config, stride):
    """Lowest |v| whose resolved stride still reaches ``stride`` (m/s).

    Below cadence_min_hz the cadence cannot drop any further, so the stride
    falls with the command; this is the speed where that starts to bite.
    """
    if stride <= 0.0 or not config.get("speed_scaled_cadence", False):
        return 0.0
    return stride * config["cadence_min_hz"] / max(config["duty_factor"], 1e-6)


def peak_stance_excursion(config, velocity):
    """Worst-case stance excursion including the cadence_min_hz floor."""
    return fastest_foot_speed(velocity) * config["duty_factor"] / max(
        config["cadence_min_hz"], 1e-6
    )


def swing_phase_progress(config, phase):
    """Progress through the current swing, 0..1, or None if all feet planted."""
    duty = config["duty_factor"]
    offsets = GAIT_PHASE_OFFSETS[config["type"]]
    best = None
    for leg in LEG_ORDER:
        local = (phase + offsets[leg]) % 1.0
        if local < duty:
            continue
        progress = (local - duty) / max(1.0 - duty, 1e-6)
        if best is None or progress > best:
            best = progress
    return best


def stance_push_offset(config, phase):
    """Body-height rise (m) while a diagonal is airborne.

    The supporting pair carries the whole 52 N alone during a trot and
    visibly sags -- the operator's description was that the robot "stands on
    2 feet and bends", and the swinging feet then drag because the body has
    dropped out from under them by about as much as they were told to lift.

    Raising step_height steps OVER that; this pushes BACK against it. The
    supporting legs are commanded to extend exactly while the other pair is
    airborne, so the body is held up when it would otherwise be sinking, and
    the feet clear by the push as well as the lift. It returns to zero at
    the four-foot overlap, where the load is shared and the sag is smallest,
    so there is no step at the handoff.

    sin^2 for the same reason swing_lift uses it: zero slope at both ends,
    so the body is never asked to change height discontinuously.
    """
    push = config.get("stance_push_m", 0.0)
    if push <= 0.0:
        return 0.0
    progress = swing_phase_progress(config, phase)
    if progress is None:
        return 0.0
    return push * math.sin(math.pi * clamp(progress, 0.0, 1.0)) ** 2


def swing_lift(progress, height):
    """Vertical swing profile: zero velocity at liftoff and touchdown."""
    return height * math.sin(math.pi * clamp(progress, 0.0, 1.0)) ** 2


def swing_transfer(progress, duty):
    """Body-frame horizontal swing profile, as the live engine flies it.

    VoltGaitController.step interpolates the swing foot in the WORLD frame
    with smoothstep, while the body advances underneath it.  Expressed
    body-relative that is NOT smoothstep.  With s = (1 - duty) / duty:

        offset(p) / excursion = (1 + s) * smoothstep(p) - s * p - 0.5

    a cubic whose end slopes are -s rather than zero -- i.e. the swing foot
    leaves and arrives moving backwards at exactly the stance foot's speed.
    That is the right shape (it is why the foot lands without scuffing), but
    it is faster in the middle than smoothstep: peak slope 1.5 + 0.5 * s
    against smoothstep's 1.5.

    This is derived here because validate_servo_budget is the servo guard,
    and a guard that sweeps a trajectory the robot never runs is not a
    guard.  Sweeping plain smoothstep understated RUN's peak commanded
    swing rate as 173 deg/s when the live engine commands 190 -- the whole
    budget, reported as 17 deg/s of headroom.
    """
    s = (1.0 - duty) / max(duty, 1e-6)
    p = clamp(progress, 0.0, 1.0)
    return (1.0 + s) * smoothstep(p) - s * p - 0.5


# --------------------------------------------------------------------------
# Velocity helpers (public: consumed by the motion controller)
# --------------------------------------------------------------------------

def limit_velocity_command(velocity, limits):
    """Clamp a twist to per-axis limits, then cap the combined magnitude.

    The combined (L1 in normalized axes) cap matters for the servo budget:
    the budget sweep validates single-axis maxima plus a mixed case, and
    this cap guarantees a joystick pushing every axis at once cannot demand
    more total foot motion than the validated mixed case.
    """
    max_x, max_y, max_yaw = limits
    vx = clamp(float(velocity[0]), -max_x, max_x) if max_x > 0.0 else 0.0
    vy = clamp(float(velocity[1]), -max_y, max_y) if max_y > 0.0 else 0.0
    wz = clamp(float(velocity[2]), -max_yaw, max_yaw) if max_yaw > 0.0 else 0.0
    total = 0.0
    if max_x > 0.0:
        total += abs(vx) / max_x
    if max_y > 0.0:
        total += abs(vy) / max_y
    if max_yaw > 0.0:
        total += abs(wz) / max_yaw
    if total > 1.0:
        vx /= total
        vy /= total
        wz /= total
    return (vx, vy, wz)


def normalized_velocity_activity(velocity, limits):
    """Return 0..1: how much of the gait's command envelope is in use."""
    max_x, max_y, max_yaw = limits
    activity = 0.0
    if max_x > 0.0:
        activity = max(activity, abs(float(velocity[0])) / max_x)
    if max_y > 0.0:
        activity = max(activity, abs(float(velocity[1])) / max_y)
    if max_yaw > 0.0:
        activity = max(activity, abs(float(velocity[2])) / max_yaw)
    return clamp(activity, 0.0, 1.0)


def velocity_is_active(velocity):
    return (
        math.hypot(float(velocity[0]), float(velocity[1]))
        > _MOTION_LINEAR_DEADBAND
        or abs(float(velocity[2])) > _MOTION_YAW_DEADBAND
    )


# --------------------------------------------------------------------------
# Configuration loading and validation
# --------------------------------------------------------------------------

def canonical_gait_name(name):
    """Resolve aliases; raise for names that resolve to nothing."""
    text = str(name or "").strip().lower()
    text = GAIT_ALIASES.get(text, text)
    if text not in GAIT_PHASE_OFFSETS:
        raise ValueError("Unknown gait: %s" % name)
    return text


def default_gait_config_path():
    return str(Path(__file__).resolve().parent.parent / "config" / "gait_controller.yaml")


def _require_number(section, key, value):
    if isinstance(value, bool) or not isinstance(value, (int, float)):
        raise ValueError("%s.%s must be a number" % (section, key))
    value = float(value)
    if not math.isfinite(value):
        raise ValueError("%s.%s must be finite" % (section, key))
    return value


def _validate_gait_config(name, raw):
    """Structural validation of one gait section; returns a clean dict."""
    if not isinstance(raw, dict):
        raise ValueError("gait %s must be a mapping" % name)
    config = {"type": name}
    declared_type = str(raw.get("type", name)).strip().lower()
    if declared_type != name:
        raise ValueError("gait %s declares type %s" % (name, declared_type))
    missing = [key for key in GAIT_PARAMETER_NAMES if key not in raw]
    if missing:
        raise ValueError("gait %s is missing: %s" % (name, ", ".join(missing)))
    unknown = [
        key for key in raw
        if key not in GAIT_PARAMETER_NAMES and key != "type"
    ]
    if unknown:
        raise ValueError("gait %s has unknown keys: %s" % (name, ", ".join(unknown)))
    for key in GAIT_PARAMETER_NAMES:
        if key == "speed_scaled_cadence":
            if not isinstance(raw[key], bool):
                raise ValueError("%s.%s must be true or false" % (name, key))
            config[key] = raw[key]
            continue
        config[key] = _require_number(name, key, raw[key])

    if not 0.4 <= config["cycle_period"] <= 4.0:
        raise ValueError("%s cycle_period must be in [0.4, 4.0] s" % name)
    # RUN reaches below a trot's floor on purpose: duty under 0.5 is what
    # distinguishes a run from a trot, and the ladder is meant to walk down
    # toward it. It is bounded above by the trot's floor so a "run" cannot be
    # configured into an ordinary trot by accident, and floored at 0.42
    # because a flight phase on open-loop servos is not a stable place to
    # arrive at blind.
    duty_bounds = {
        "trot": (0.52, 0.68),
        "run": (0.42, 0.56),
        "amble": (0.70, 0.86),
    }
    duty_low, duty_high = duty_bounds.get(name, (0.70, 0.86))
    if not duty_low <= config["duty_factor"] <= duty_high:
        raise ValueError(
            "%s duty_factor must be in [%.2f, %.2f]" % (name, duty_low, duty_high)
        )
    if not 0.012 <= config["step_height"] <= 0.040:
        raise ValueError("%s step_height must be in [0.012, 0.040] m" % name)
    for key in ("max_x", "max_y", "max_yaw"):
        if config[key] <= 0.0:
            raise ValueError("%s %s must be positive" % (name, key))
    if config["max_x"] > 0.25 or config["max_y"] > 0.12 or config["max_yaw"] > 1.2:
        raise ValueError("%s command limits exceed sane bounds" % name)
    if not 0.2 <= config["settle_time"] <= 2.0:
        raise ValueError("%s settle_time must be in [0.2, 2.0] s" % name)
    if not 0.0 <= config["body_sway_y"] <= 0.03:
        raise ValueError("%s body_sway_y must be in [0, 0.03] m" % name)
    if not -0.03 <= config["body_height_offset"] <= 0.0:
        raise ValueError("%s body_height_offset must be in [-0.03, 0] m" % name)
    if not 0.05 <= config["velocity_filter_alpha"] <= 1.0:
        raise ValueError("%s velocity_filter_alpha must be in (0.05, 1]" % name)
    if not 0.02 <= config["command_acceleration"] <= 2.0:
        raise ValueError("%s command_acceleration must be in [0.02, 2.0]" % name)
    if not 0.2 <= config["hardware_speed_scale"] <= 1.0:
        raise ValueError("%s hardware_speed_scale must be in [0.2, 1]" % name)
    if not 30.0 <= config["joint_velocity_limit_deg_s"] <= 240.0:
        raise ValueError("%s joint_velocity_limit_deg_s must be in [30, 240]" % name)
    # An unloaded TD-8130MG reverses direction in ~40 ms, an effective
    # acceleration capability well above 15000 deg/s^2; the ceiling here is
    # a commanded-trajectory sanity bound, not a servo spec.
    if not 600.0 <= config["joint_acceleration_limit_deg_s2"] <= 12000.0:
        raise ValueError(
            "%s joint_acceleration_limit_deg_s2 must be in [600, 12000]" % name
        )
    if not 20.0 <= config["stance_velocity_budget_deg_s"] <= 120.0:
        raise ValueError("%s stance budget must be in [20, 120] deg/s" % name)
    if not 60.0 <= config["swing_velocity_budget_deg_s"] <= 240.0:
        raise ValueError("%s swing budget must be in [60, 240] deg/s" % name)
    if config["swing_velocity_budget_deg_s"] > config["joint_velocity_limit_deg_s"]:
        raise ValueError(
            "%s swing budget exceeds its own joint_velocity_limit_deg_s" % name
        )
    config["speed_scaled_cadence"] = bool(config["speed_scaled_cadence"])
    cadence_max = 1.0 / config["cycle_period"]
    if not 0.05 <= config["cadence_min_hz"] <= cadence_max + 1e-9:
        raise ValueError(
            "%s cadence_min_hz must be in [0.05, %.3f] (1/cycle_period)"
            % (name, cadence_max)
        )
    shipped_stride = (
        config["max_x"] * config["hardware_speed_scale"]
        * config["duty_factor"] * config["cycle_period"]
    )
    if not 0.010 <= config["stride_target_m"] <= 0.200:
        raise ValueError("%s stride_target_m must be in [0.010, 0.200] m" % name)
    if abs(config["stride_target_m"] - shipped_stride) > 1e-4:
        # The cadence law is f = v*duty/stride_target, so at the gait's own
        # maximum command it must resolve to exactly 1/cycle_period -- the
        # point validate_servo_budget sweeps.  A stride_target that does not
        # match would let the top of the slider run a cadence the budget
        # never checked.
        raise ValueError(
            "%s stride_target_m %.4f must equal max_x*hardware_speed_scale*"
            "duty_factor*cycle_period = %.4f"
            % (name, config["stride_target_m"], shipped_stride)
        )
    if not 0.0 <= config["stride_floor_m"] <= config["stride_target_m"]:
        raise ValueError(
            "%s stride_floor_m must be in [0, stride_target_m]" % name
        )
    if not 0.0 <= config["yaw_trim_limit_rad_s"] <= 0.30:
        raise ValueError(
            "%s yaw_trim_limit_rad_s must be in [0, 0.30] rad/s" % name
        )
    # 0.010 is a hard ceiling because past ~0.012 the front knees leave the
    # firmware travel guards: ch5 reaches 130.4 against a 130.0 limit and
    # ch2 falls to 42.7 against 50.0. That is the direction that jammed a
    # leg once already.
    if not 0.0 <= config["stance_push_m"] <= 0.010:
        raise ValueError("%s stance_push_m must be in [0, 0.010] m" % name)

    # The stance excursion the maximum command produces must stay inside the
    # foot workspace with margin (the IK sweep re-checks this exactly).
    stance_time = config["duty_factor"] * config["cycle_period"]
    if 0.5 * config["max_x"] * stance_time > 0.085:
        raise ValueError("%s max_x stride exceeds the foot workspace" % name)
    return config


def _sweep_offsets(config, phase, velocity, leg):
    """Idealized planar foot offset used only by the budget sweep.

    The runtime engine world-locks stance feet; for validation the
    equivalent body-frame motion is a linear stance sweep plus the exact
    swing profile, evaluated at constant commanded twist.
    """
    duty = config["duty_factor"]
    period = config["cycle_period"]
    vx, vy, wz = velocity
    nominal = NOMINAL_FEET[leg]
    stance_vx = vx - wz * nominal[1]
    stance_vy = vy + wz * nominal[0]
    excursion_x = stance_vx * duty * period
    excursion_y = stance_vy * duty * period
    local = (phase + GAIT_PHASE_OFFSETS[config["type"]][leg]) % 1.0
    if local < duty:
        fraction = 0.5 - local / duty
        return excursion_x * fraction, excursion_y * fraction, 0.0, True
    progress = (local - duty) / (1.0 - duty)
    fraction = swing_transfer(progress, duty)
    return (
        excursion_x * fraction,
        excursion_y * fraction,
        swing_lift(progress, config["step_height"]),
        False,
    )


def validate_servo_budget(config, speed_scale=1.0):
    """Reject a gait whose maximum command breaks the servo budgets.

    Sweeps a full cycle through the real IK at the gait's maximum forward,
    maximum lateral, maximum yaw, and the L1-capped mixed command, at the
    lowest shipped standing height.  Raises ValueError with the offending
    command and joint if any sample exceeds the stance or swing budget, or
    leaves the foot workspace.
    """
    stance_budget = config["stance_velocity_budget_deg_s"]
    swing_budget = config["swing_velocity_budget_deg_s"]
    limits = (
        config["max_x"] * speed_scale,
        config["max_y"] * speed_scale,
        config["max_yaw"] * speed_scale,
    )
    mixed = limit_velocity_command(
        (limits[0], limits[1], limits[2]), limits
    )
    # Yaw trim is added AFTER the combined-axis cap (so it never steals
    # forward speed), which means the worst case for the servos is the
    # gait's maximum forward command with the full trim on top -- a case
    # the L1 cap would otherwise have rescaled away.  Sweep it explicitly.
    trim = float(config.get("yaw_trim_limit_rad_s", 0.0))
    commands = (
        (limits[0], 0.0, 0.0),
        (0.0, limits[1], 0.0),
        (0.0, 0.0, limits[2]),
        mixed,
        (limits[0], 0.0, trim),
        (limits[0], 0.0, -trim),
    )
    period = config["cycle_period"]
    dt = _BUDGET_SWEEP_DT
    samples = max(int(period / dt), 40)
    acceleration_budget = config["joint_acceleration_limit_deg_s2"]
    for command in commands:
        previous = None
        previous_stance = None
        previous_speeds = None
        for index in range(samples + 1):
            phase = (index * dt) / period
            feet = {}
            stance_flags = {}
            for leg in LEG_ORDER:
                dx, dy, dz, stance = _sweep_offsets(config, phase, command, leg)
                nominal = NOMINAL_FEET[leg]
                feet[leg] = (nominal[0] + dx, nominal[1] + dy, nominal[2] + dz)
                stance_flags[leg] = stance
            positions, diagnostics = feet_to_joint_positions_diagnostic(
                feet,
                height=_BUDGET_SWEEP_HEIGHT + stance_push_offset(config, phase),
            )
            if diagnostics["projected_targets"]:
                raise ValueError(
                    "%s command %s leaves the workspace: %s"
                    % (config["type"], command, diagnostics["projected_targets"])
                )
            if previous is not None:
                speeds = [
                    (positions[j] - previous[j]) / dt * 180.0 / math.pi
                    for j in range(12)
                ]
                for joint_index in range(12):
                    speed = abs(speeds[joint_index])
                    leg = "_".join(JOINT_NAMES[joint_index].split("_")[:2])
                    in_stance = stance_flags[leg] and previous_stance[leg]
                    budget = stance_budget if in_stance else swing_budget
                    if speed > budget:
                        raise ValueError(
                            "%s command %s demands %.0f deg/s on %s during "
                            "%s (budget %.0f); slow the gait or shrink the "
                            "command limits"
                            % (
                                config["type"], command, speed,
                                JOINT_NAMES[joint_index],
                                "stance" if in_stance else "swing",
                                budget,
                            )
                        )
                if previous_speeds is not None:
                    for joint_index in range(12):
                        acceleration = abs(
                            speeds[joint_index]
                            - previous_speeds[joint_index]
                        ) / dt
                        if acceleration > acceleration_budget:
                            raise ValueError(
                                "%s command %s demands %.0f deg/s^2 on %s "
                                "(budget %.0f); the acceleration limiter "
                                "would distort the trajectory"
                                % (
                                    config["type"], command, acceleration,
                                    JOINT_NAMES[joint_index],
                                    acceleration_budget,
                                )
                            )
                previous_speeds = speeds
            previous = positions
            previous_stance = stance_flags
    return True


def load_gait_configs(path=None):
    """Load and validate every gait section from the controller YAML."""
    config_path = Path(path or default_gait_config_path())
    with open(config_path, "r", encoding="utf-8") as handle:
        document = yaml.safe_load(handle) or {}
    try:
        parameters = document["volt_motion_controller"]["ros__parameters"]
    except (KeyError, TypeError):
        raise ValueError("gait config missing volt_motion_controller section")
    gaits = parameters.get("gaits")
    if not isinstance(gaits, dict):
        raise ValueError("gait config missing a gaits mapping")
    configs = {}
    # Every gait the engine knows a phase table for must be present: a config
    # that silently omits one would leave the GUI offering a gait the engine
    # cannot select.
    for name in sorted(GAIT_PHASE_OFFSETS):
        if name not in gaits:
            raise ValueError("gait config missing the %s gait" % name)
        config = _validate_gait_config(name, gaits[name])
        validate_servo_budget(config)
        # The hardware envelope is a scaled-down subset of the validated
        # simulation envelope, so it cannot fail if the full one passed;
        # validating it anyway keeps the contract explicit.
        validate_servo_budget(config, speed_scale=config["hardware_speed_scale"])
        configs[name] = config
    return configs


def apply_real_tuning_to_configs(configs, tuning):
    """Overlay a validated real-robot profile onto its target gait.

    The profile names its gait; its cadence/stride fields replace that
    gait's parameters and the result must re-pass the servo budget, so a
    profile cannot smuggle in an infeasible gait.
    """
    if not isinstance(tuning, dict):
        raise ValueError("real tuning must be a mapping")
    updated = {name: dict(config) for name, config in configs.items()}
    name = canonical_gait_name(tuning.get("gait", "trot"))
    config = updated[name]
    cycle = float(tuning.get("cycle_duration", config["cycle_period"]))
    duty = float(tuning.get("duty_factor", config["duty_factor"]))
    stride = float(tuning.get("stride_length", 0.0))
    lateral = float(tuning.get("lateral_stride_width", 0.0))
    config["cycle_period"] = cycle
    config["duty_factor"] = duty
    config["step_height"] = float(tuning.get("step_height", config["step_height"]))
    stance_time = duty * cycle
    if stride > 0.0 and stance_time > 0.0:
        config["max_x"] = stride / stance_time
    if lateral > 0.0 and stance_time > 0.0:
        config["max_y"] = lateral / stance_time
    # The profile just rewrote cadence/duty/max_x, so the cadence law's
    # derived values must follow or the loader will reject the result:
    # stride_target_m has to stay equal to the full-command stride, and
    # cadence_min_hz cannot exceed the new 1/cycle_period.
    config["stride_target_m"] = (
        config["max_x"] * config["hardware_speed_scale"]
        * config["duty_factor"] * config["cycle_period"]
    )
    config["cadence_min_hz"] = min(
        config["cadence_min_hz"], 1.0 / config["cycle_period"]
    )
    config["stride_floor_m"] = min(
        config["stride_floor_m"], config["stride_target_m"]
    )
    if "command_acceleration" in tuning:
        config["command_acceleration"] = float(tuning["command_acceleration"])
    if "velocity_filter_alpha" in tuning:
        config["velocity_filter_alpha"] = float(tuning["velocity_filter_alpha"])
    config = _validate_gait_config(name, {
        key: config[key] for key in GAIT_PARAMETER_NAMES
    } | {"type": name})
    validate_servo_budget(config)
    updated[name] = config
    return updated


def _builtin_gaits():
    """The shipped defaults; the YAML holds the same values.

    Numbers come from the numeric design sweep against the TD-8130MG
    budgets (stance 80 / swing 190 deg/s at 0.195 m standing height):
    trot T=1.1 duty=0.58 tops out at 182 deg/s swing when turning at full
    command; amble T=2.0 duty=0.76 tops out at 187 deg/s.
    """
    return {
        "trot": _validate_gait_config("trot", {
            "type": "trot",
            # T=0.9/duty=0.62 was tuned in the loaded-servo Ignition model:
            # the shorter cycle leaves less time to fall onto each diagonal
            # and the higher duty doubles the four-foot load-transfer window.
            # With the slow command ramp below, three consecutive runs gave
            # 1.12-1.21 m per 15 s at 0.10 m/s with roll p95 <= 2.6 deg.
            "cycle_period": 0.9,
            "duty_factor": 0.62,
            "step_height": 0.020,
            "max_x": 0.10,
            "max_y": 0.05,
            "max_yaw": 0.50,
            "settle_time": 0.6,
            "body_sway_y": 0.0,
            "body_height_offset": 0.0,
            "velocity_filter_alpha": 0.30,
            # The dynamic trot is bistable on marginal servo torque: ramping
            # to full stride over ~2 cycles reliably enters the clean limit
            # cycle, where a fast ramp sometimes locked in a 10-deg rocking
            # mode with most of the stride lost to slip.
            "command_acceleration": 0.08,
            "hardware_speed_scale": 0.80,
            "joint_velocity_limit_deg_s": 190.0,
            "joint_acceleration_limit_deg_s2": 6500.0,
            "stance_velocity_budget_deg_s": 80.0,
            "swing_velocity_budget_deg_s": 190.0,
            "speed_scaled_cadence": False,
            "stride_target_m": 0.04464,
            "cadence_min_hz": 0.30,
            "stride_floor_m": 0.0,
            "yaw_trim_limit_rad_s": 0.15,
            "stance_push_m": 0.008,
        }),
        # RUN: 0.80 Hz, the peak of the stride/cadence frontier. Faster
        # cadence shrinks the stride (the foot must cover it inside a shorter
        # stance), so 1.30 Hz would give 52 mm steps against the trot's 83.
        "run": _validate_gait_config("run", {
            "type": "run",
            "cycle_period": 1.25,
            "duty_factor": 0.48,
            "step_height": 0.030,
            "max_x": 0.172,
            "max_y": 0.05,
            "max_yaw": 0.50,
            "settle_time": 0.6,
            "body_sway_y": 0.0,
            "body_height_offset": 0.0,
            "velocity_filter_alpha": 0.22,
            "command_acceleration": 0.07,
            "hardware_speed_scale": 0.80,
            "joint_velocity_limit_deg_s": 190.0,
            "joint_acceleration_limit_deg_s2": 6500.0,
            "stance_velocity_budget_deg_s": 80.0,
            "swing_velocity_budget_deg_s": 190.0,
            "speed_scaled_cadence": True,
            "stride_target_m": 0.08256,
            "cadence_min_hz": 0.40,
            "stride_floor_m": 0.050,
            "yaw_trim_limit_rad_s": 0.0,
            "stance_push_m": 0.0,
        }),
        "amble": _validate_gait_config("amble", {
            "type": "amble",
            "cycle_period": 2.0,
            "duty_factor": 0.76,
            "step_height": 0.020,
            "max_x": 0.05,
            "max_y": 0.03,
            "max_yaw": 0.30,
            "settle_time": 0.8,
            # 0.012 m of sway produced a consistent ~1 deg/s heading drift
            # in simulation (sway/swing-order asymmetry); 0.009 keeps the
            # stability lean while centering the drift around zero.
            "body_sway_y": 0.009,
            "body_height_offset": 0.0,
            "velocity_filter_alpha": 0.25,
            "command_acceleration": 0.06,
            "hardware_speed_scale": 0.85,
            "joint_velocity_limit_deg_s": 190.0,
            "joint_acceleration_limit_deg_s2": 6500.0,
            "stance_velocity_budget_deg_s": 80.0,
            "swing_velocity_budget_deg_s": 190.0,
            "speed_scaled_cadence": False,
            "stride_target_m": 0.0646,
            "cadence_min_hz": 0.30,
            "stride_floor_m": 0.0,
            "yaw_trim_limit_rad_s": 0.15,
            "stance_push_m": 0.0,
        }),
    }


# Enforce each gait's coordination contract at import: a permuted phase table
# is four valid numbers in the wrong places, so nothing downstream can catch
# it and the robot simply walks the wrong gait.
for _gait_name, _gait_offsets in GAIT_PHASE_OFFSETS.items():
    validate_phase_structure(_gait_name, _gait_offsets)


try:
    GAITS = load_gait_configs()
except (OSError, ValueError):
    # Source checkouts without an installed config still need the module
    # importable (GUI unit tests, tooling); the builtin values are the
    # same numbers the shipped YAML carries.
    GAITS = _builtin_gaits()


# --------------------------------------------------------------------------
# The engine
# --------------------------------------------------------------------------

def copy_feet(feet):
    return {leg: tuple(float(v) for v in feet[leg]) for leg in LEG_ORDER}


class VoltGaitController:
    """World-locked two-gait engine.

    The public surface is intentionally the same one the motion controller,
    emote/pose keep-code, and tests already speak: ``step``, ``set_gait``,
    ``reset``, ``set_current_feet``, ``hold_current_feet``, ``request_stop``,
    ``nominal_feet``, ``set_support_feedback``, ``set_real_tuning``,
    ``debug_snapshot``, ``cycle_phase``, ``velocity_activity``, ``active``.
    """

    def __init__(self, gait_configs=None, hardware_mode=False):
        self.gaits = {
            name: dict(config)
            for name, config in (gait_configs or GAITS).items()
        }
        self.hardware_mode = bool(hardware_mode)
        self.gait_name = "amble"
        self.real_tuning = {}
        self.support_feedback = {}
        self.warning = ""
        self.reset(0.0)

    # -- configuration ----------------------------------------------------

    @property
    def config(self):
        return self.gaits[self.gait_name]

    def speed_scale(self):
        if self.hardware_mode:
            return float(self.config["hardware_speed_scale"])
        return 1.0

    def command_limits(self):
        scale = self.speed_scale()
        config = self.config
        return (
            config["max_x"] * scale,
            config["max_y"] * scale,
            config["max_yaw"] * scale,
        )

    def nominal_foot(self, leg_name):
        return tuple(NOMINAL_FEET[leg_name])

    def nominal_feet(self):
        return {leg: self.nominal_foot(leg) for leg in LEG_ORDER}

    def set_gait(self, gait_name, now):
        name = canonical_gait_name(gait_name)
        if name == self.gait_name:
            return
        if self.active:
            raise ValueError("cannot switch gaits while the gait is active")
        self.gait_name = name
        self.reset(now)

    def set_real_tuning(self, tuning):
        self.gaits = apply_real_tuning_to_configs(self.gaits, tuning)
        self.real_tuning = dict(tuning)
        return dict(self.real_tuning)

    def set_support_feedback(self, feedback=None):
        if feedback is None:
            self.support_feedback = {}
            return
        if not isinstance(feedback, dict):
            raise ValueError("support feedback must be a mapping")
        self.support_feedback = dict(feedback)

    # -- state ------------------------------------------------------------

    def reset(self, now=None):
        self.active = False
        self.settling = False
        self.stop_requested = False
        self.forced_stop = False
        self.phase = 0.0
        self.cadence_hz = 1.0 / self.config["cycle_period"]
        self.feet = copy_feet(NOMINAL_FEET)
        self.world_feet = copy_feet(NOMINAL_FEET)
        self.body_x_world = 0.0
        self.body_y_world = 0.0
        self.body_yaw_world = 0.0
        self.swing_origins = {}
        self.swing_targets = {}
        self.was_swinging = {leg: False for leg in LEG_ORDER}
        self.settle_started = 0.0
        self.settle_origin = None
        self.last_velocity = (0.0, 0.0, 0.0)
        self.warning = ""
        self.debug_state = {
            "phase": 0.0,
            "phase_name": "stopped",
            "phase_progress": 0.0,
            "step_state": "STOPPED",
            "swing_legs": [],
            "stance_legs": list(LEG_ORDER),
            "per_leg_phase": {leg: 0.0 for leg in LEG_ORDER},
            "cycle_period": self.config["cycle_period"],
            "warning": "",
            "body_world": {"x": 0.0, "y": 0.0, "yaw": 0.0},
            "planned_velocity": [0.0, 0.0, 0.0],
            "cadence_hz": 1.0 / self.config["cycle_period"],
            "configured_cycle_period": self.config["cycle_period"],
            "resolved_stride_m": 0.0,
            "duty_factor": self.config["duty_factor"],
            "step_height": self.config["step_height"],
        }

    def set_current_feet(self, feet):
        cleaned = {}
        for leg in LEG_ORDER:
            if leg not in feet:
                raise ValueError("feet mapping is missing %s" % leg)
            point = feet[leg]
            values = tuple(float(v) for v in point)
            if len(values) != 3 or not all(math.isfinite(v) for v in values):
                raise ValueError("foot %s must be three finite floats" % leg)
            cleaned[leg] = values
        self.feet = cleaned
        self.sync_world_feet_from_body()

    def hold_current_feet(self, feet, now=None):
        """Ownership-loss hold: adopt the pose, drop every request."""
        self.set_current_feet(feet)
        self.active = False
        self.settling = False
        self.stop_requested = False
        self.forced_stop = False
        self.swing_origins = {}
        self.swing_targets = {}
        self.was_swinging = {leg: False for leg in LEG_ORDER}
        self.debug_state["phase_name"] = "ownership_hold"
        self.debug_state["step_state"] = "OWNERSHIP_HOLD"

    def request_stop(self):
        if self.active:
            self.stop_requested = True
            self.forced_stop = True

    def release_forced_stop(self):
        """Release the safety latch once a true neutral command was seen.

        The latch itself is cleared inside step() when an idle engine
        receives a neutral command, but the motion controller only calls
        step() while motion is requested -- an idle engine never sees the
        neutral.  The controller therefore reports the observed neutral
        through this method; a held joystick still cannot restart a stop
        because the controller only calls this when the command stream is
        genuinely neutral.
        """
        # Clearing the latch does NOT depend on the engine already being
        # idle.  It used to, and that was a trap: the engine stays active
        # for the rest of the swing plus settle_time after a release (up to
        # ~2.5 s on RUN), so an operator who let go and pushed again inside
        # that window left forced_stop latched forever -- the readout sat at
        # "Phase 0 - STOPPED 0%" against a held stick until they released a
        # second time and waited.  Measured trap windows before this fix:
        # trot 0.05..0.95 s, run 0.05..2.45 s after release.
        #
        # The safety property is unchanged, because it never lived here: the
        # caller only invokes this when the RAW command stream is genuinely
        # neutral, so a held joystick still cannot clear a stop.  STOP keeps
        # its separate AWAIT_NEUTRAL -> AWAIT_MOTION handshake in the motion
        # controller, which this does not touch.
        self.forced_stop = False
        if not self.active:
            self.stop_requested = False

    # -- world frame ------------------------------------------------------

    def predict_body_pose(self, velocity, dt):
        """Exact constant-twist arc from the current world pose."""
        vx, vy, wz = (float(v) for v in velocity)
        yaw = self.body_yaw_world
        if abs(wz) < 1e-9:
            dx = (vx * math.cos(yaw) - vy * math.sin(yaw)) * dt
            dy = (vx * math.sin(yaw) + vy * math.cos(yaw)) * dt
            return self.body_x_world + dx, self.body_y_world + dy, yaw
        theta = wz * dt
        local_x = (vx * math.sin(theta) + vy * (math.cos(theta) - 1.0)) / wz
        local_y = (vx * (1.0 - math.cos(theta)) + vy * math.sin(theta)) / wz
        dx = local_x * math.cos(yaw) - local_y * math.sin(yaw)
        dy = local_x * math.sin(yaw) + local_y * math.cos(yaw)
        return self.body_x_world + dx, self.body_y_world + dy, yaw + theta

    def integrate_body_pose(self, velocity, dt):
        self.body_x_world, self.body_y_world, self.body_yaw_world = (
            self.predict_body_pose(velocity, dt)
        )

    def body_to_world(self, point, body_x=None, body_y=None, body_yaw=None):
        x = self.body_x_world if body_x is None else body_x
        y = self.body_y_world if body_y is None else body_y
        yaw = self.body_yaw_world if body_yaw is None else body_yaw
        px, py, pz = point
        return (
            x + px * math.cos(yaw) - py * math.sin(yaw),
            y + px * math.sin(yaw) + py * math.cos(yaw),
            pz,
        )

    def world_to_body(self, point):
        px = point[0] - self.body_x_world
        py = point[1] - self.body_y_world
        yaw = self.body_yaw_world
        return (
            px * math.cos(yaw) + py * math.sin(yaw),
            -px * math.sin(yaw) + py * math.cos(yaw),
            point[2],
        )

    def sync_world_feet_from_body(self):
        self.world_feet = {
            leg: self.body_to_world(self.feet[leg]) for leg in LEG_ORDER
        }

    # -- introspection ----------------------------------------------------

    def cycle_phase(self, now):
        return self.phase % 1.0

    def velocity_activity(self, velocity, step_in_place=False):
        if step_in_place:
            return max(
                0.35,
                normalized_velocity_activity(velocity, self.command_limits()),
            )
        return normalized_velocity_activity(velocity, self.command_limits())

    def debug_snapshot(self):
        return dict(self.debug_state)

    # -- per-leg phase helpers ---------------------------------------------

    def _leg_local_phase(self, leg):
        offsets = GAIT_PHASE_OFFSETS[self.gait_name]
        return (self.phase + offsets[leg]) % 1.0

    def _leg_in_stance(self, leg):
        return self._leg_local_phase(leg) < self.config["duty_factor"]

    def _swing_progress(self, leg):
        duty = self.config["duty_factor"]
        local = self._leg_local_phase(leg)
        if local < duty:
            return None
        return (local - duty) / (1.0 - duty)

    # -- touchdown planning -------------------------------------------------

    def _touchdown_world(self, leg, velocity):
        """Frozen world-frame touchdown for the swing that starts now."""
        config = self.config
        # The live cadence, not the configured one: with speed-scaled cadence
        # the cycle stretches at low command, and a touchdown planned from
        # the configured period would land short by the same ratio.
        period = 1.0 / max(
            getattr(self, "cadence_hz", 0.0) or resolved_cadence(config, velocity),
            1e-6,
        )
        stance_time = config["duty_factor"] * period
        swing_time = (1.0 - config["duty_factor"]) * period
        vx, vy, wz = velocity
        nominal = NOMINAL_FEET[leg]
        # Foot velocity relative to the body during stance for this twist.
        stance_vx = vx - wz * nominal[1]
        stance_vy = vy + wz * nominal[0]
        lead_x = clamp(0.5 * stance_vx * stance_time, -0.085, 0.085)
        lead_y = clamp(0.5 * stance_vy * stance_time, -0.060, 0.060)
        target_body = (nominal[0] + lead_x, nominal[1] + lead_y, nominal[2])
        body_x, body_y, body_yaw = self.predict_body_pose(velocity, swing_time)
        return self.body_to_world(target_body, body_x, body_y, body_yaw)

    # -- the tick -----------------------------------------------------------

    def step(self, now, dt, velocity, step_in_place=False, body_offset=(0.0, 0.0)):
        """Advance one control tick.

        Returns ``(feet, body_motion, active)`` where ``feet`` is a fresh
        body-frame mapping over ``LEG_ORDER``, ``body_motion`` is a dict
        with ``x``/``y`` (gait body sway), ``height``/``roll``/``pitch``
        offsets, and ``body_x_override``/``body_y_override`` (the operator
        offset passed straight through), and ``active`` reports whether
        the engine still owns the feet.
        """
        dt = clamp(float(dt), 0.0, 0.2)
        velocity = tuple(float(v) for v in velocity)
        commanded = velocity_is_active(velocity) or bool(step_in_place)

        if not self.active:
            if not commanded:
                # A neutral command releases a forced stop; only then may a
                # fresh command re-activate the gait.
                self.forced_stop = False
                self._update_debug(velocity, stopped=True)
                return copy_feet(self.feet), self._body_motion(), False
            if self.forced_stop:
                # request_stop() latches: a command that was never released
                # to neutral cannot restart motion (safety stops stay stopped
                # against a held joystick).
                self._update_debug(velocity, stopped=True)
                return copy_feet(self.feet), self._body_motion(), False
            # Activate: adopt the current pose as the world frame origin.
            self.active = True
            self.settling = False
            self.stop_requested = False
            self.forced_stop = False
            self.phase = 0.0
            self.body_x_world = 0.0
            self.body_y_world = 0.0
            self.body_yaw_world = 0.0
            self.sync_world_feet_from_body()
            self.was_swinging = {leg: False for leg in LEG_ORDER}
            self.swing_origins = {}
            self.swing_targets = {}

        if self.settling:
            return self._settle_step(now, dt)

        if not commanded and not self.stop_requested:
            self.stop_requested = True
        elif commanded and self.stop_requested and not self.forced_stop:
            self.stop_requested = False

        self.last_velocity = velocity
        self.integrate_body_pose(velocity, dt)
        # FREQUENCY carries the speed command; stride length is held near
        # stride_target_m. See resolved_cadence().
        self.cadence_hz = resolved_cadence(self.config, velocity)
        self.phase += dt * self.cadence_hz

        feet = {}
        any_airborne = False
        for leg in LEG_ORDER:
            progress = self._swing_progress(leg)
            if progress is None:
                # Stance: the world foothold does not move.
                self.was_swinging[leg] = False
                feet[leg] = self.world_to_body(self.world_feet[leg])
                continue
            if self.stop_requested and not self.was_swinging[leg]:
                # A stop never begins a new swing; keep the foot planted.
                feet[leg] = self.world_to_body(self.world_feet[leg])
                continue
            if not self.was_swinging[leg]:
                # Liftoff edge: freeze origin and touchdown in world frame.
                self.was_swinging[leg] = True
                self.swing_origins[leg] = self.world_feet[leg]
                self.swing_targets[leg] = self._touchdown_world(leg, velocity)
            origin = self.swing_origins[leg]
            target = self.swing_targets[leg]
            blend = smoothstep(progress)
            world = (
                origin[0] + (target[0] - origin[0]) * blend,
                origin[1] + (target[1] - origin[1]) * blend,
                NOMINAL_FEET_Z + swing_lift(
                    progress, self.config["step_height"]
                ),
            )
            if progress >= 1.0 - 1e-9:
                world = (target[0], target[1], NOMINAL_FEET_Z)
            self.world_feet[leg] = (world[0], world[1], NOMINAL_FEET_Z)
            body_point = self.world_to_body(
                (world[0], world[1], NOMINAL_FEET_Z)
            )
            feet[leg] = (body_point[0], body_point[1], world[2])
            any_airborne = True

        self.feet = {
            leg: (feet[leg][0], feet[leg][1], min(feet[leg][2], 0.0))
            for leg in LEG_ORDER
        }

        if self.stop_requested and not any_airborne:
            self.settling = True
            self.settle_started = now
            self.settle_origin = copy_feet(self.feet)

        self._update_debug(velocity)
        return copy_feet(self.feet), self._body_motion(), True

    def _settle_step(self, now, dt):
        """Blend every planted foot back to nominal, then go idle."""
        settle_time = max(self.config["settle_time"], 1e-3)
        progress = clamp((now - self.settle_started) / settle_time, 0.0, 1.0)
        blend = smootherstep(progress)
        feet = {}
        for leg in LEG_ORDER:
            origin = self.settle_origin[leg]
            nominal = NOMINAL_FEET[leg]
            feet[leg] = (
                origin[0] + (nominal[0] - origin[0]) * blend,
                origin[1] + (nominal[1] - origin[1]) * blend,
                origin[2] + (nominal[2] - origin[2]) * blend,
            )
        self.feet = feet
        self.debug_state["phase_name"] = "settle_to_nominal"
        self.debug_state["step_state"] = "SETTLING"
        self.debug_state["phase_progress"] = progress
        if progress >= 1.0:
            self.feet = copy_feet(NOMINAL_FEET)
            self.active = False
            self.settling = False
            self.stop_requested = False
            # forced_stop deliberately survives until a neutral command is
            # observed, so a held joystick cannot restart a safety stop.
            self.sync_world_feet_from_body()
            self._update_debug((0.0, 0.0, 0.0), stopped=True)
            return copy_feet(self.feet), self._body_motion(), False
        return copy_feet(self.feet), self._body_motion(), True

    # -- body motion ---------------------------------------------------------

    def _body_motion(self):
        config = self.config
        sway_y = 0.0
        if self.active and not self.settling and config["body_sway_y"] > 0.0:
            # Lean away from the swinging side.  With the lateral-sequence
            # amble offsets, right legs swing during the first half cycle
            # and left legs during the second, so a plain sine of the cycle
            # phase leans left first, then right.
            sway_y = config["body_sway_y"] * math.sin(
                2.0 * math.pi * (self.phase % 1.0)
            )
        # No body_x/y_override keys: the operator offset passes through
        # unchanged (the consumer's .get default), the gait only adds sway.
        height = config["body_height_offset"] if self.active else 0.0
        if self.active and not self.settling:
            # Positive = push the supporting pair taller. Only while a
            # diagonal is airborne; zero again at the four-foot overlap.
            height += stance_push_offset(config, self.phase % 1.0)
        return {
            "x": 0.0,
            "y": sway_y,
            "height": height,
            "roll": 0.0,
            "pitch": 0.0,
        }

    # -- debug ----------------------------------------------------------------

    def _update_debug(self, velocity, stopped=False):
        if stopped:
            swing_legs = []
            per_leg = {leg: 0.0 for leg in LEG_ORDER}
            phase_name = "stopped"
            step_state = "STOPPED"
            progress = 0.0
        else:
            swing_legs = [
                leg for leg in LEG_ORDER
                if self.was_swinging.get(leg)
                and self._swing_progress(leg) is not None
            ]
            per_leg = {leg: self._leg_local_phase(leg) for leg in LEG_ORDER}
            phase_name = "cycle"
            step_state = "CYCLE"
            progress = self.phase % 1.0
        self.debug_state = {
            "phase": self.phase % 1.0,
            "phase_name": phase_name,
            "phase_progress": progress,
            "step_state": step_state,
            "swing_legs": swing_legs,
            "stance_legs": [leg for leg in LEG_ORDER if leg not in swing_legs],
            "per_leg_phase": per_leg,
            # The LIVE values, not the configured ones: with speed-scaled
            # cadence these are what the robot is actually doing.
            "cycle_period": 1.0 / max(
                getattr(self, "cadence_hz", 0.0)
                or 1.0 / self.config["cycle_period"],
                1e-6,
            ),
            "configured_cycle_period": self.config["cycle_period"],
            "cadence_hz": getattr(
                self, "cadence_hz", 1.0 / self.config["cycle_period"]
            ),
            "resolved_stride_m": resolved_stride(self.config, velocity),
            "duty_factor": self.config["duty_factor"],
            "step_height": self.config["step_height"],
            "warning": self.warning,
            "body_world": {
                "x": self.body_x_world,
                "y": self.body_y_world,
                "yaw": self.body_yaw_world,
            },
            "planned_velocity": list(velocity),
        }
