benurapriyanidirisinghe/VOLT/src/volt_description/scripts/volt_control_gui.py

#!/usr/bin/env python3

import fcntl
import json
import math
import os
import signal
import socket
import sys
import time
import uuid

os.environ.setdefault("PYGAME_HIDE_SUPPORT_PROMPT", "1")

import rclpy
from geometry_msgs.msg import Twist
from PyQt5.QtCore import QEvent, QPointF, QRectF, Qt, QTimer, pyqtSignal
from PyQt5.QtGui import QBrush, QColor, QFont, QPainter, QPainterPath, QPen
from PyQt5.QtWidgets import (
    QApplication,
    QButtonGroup,
    QCheckBox,
    QColorDialog,
    QComboBox,
    QDoubleSpinBox,
    QFormLayout,
    QFrame,
    QGridLayout,
    QGroupBox,
    QHBoxLayout,
    QLabel,
    QMainWindow,
    QMessageBox,
    QInputDialog,
    QPushButton,
    QScrollArea,
    QSizePolicy,
    QSlider,
    QSpinBox,
    QTabWidget,
    QVBoxLayout,
    QWidget,
)
from rclpy.node import Node
from std_msgs.msg import ColorRGBA, Float64, String, UInt8, UInt32

from volt_gait_controller import GAITS, clamp
from volt_gamepad_bindings import (
    ACTION_CAPTIONS,
    MAX_AXES,
    BINDABLE_ACTIONS,
    BindingError,
    DEFAULT_BINDINGS,
    HAT_INPUTS,
    all_input_names,
    bindings_path,
    button_input,
    AXIS_FUNCTIONS,
    AXIS_FUNCTION_CAPTIONS,
    DEFAULT_AXIS_BINDINGS,
    all_axis_names,
    axis_caption,
    axis_input,
    input_caption,
    load_axis_bindings,
    load_bindings,
    reachable_stop_inputs,
    resolve_axis,
    validate_axis_bindings,
    resolve,
    save_bindings,
)
from volt_kinematics import JOINT_NAMES, LEG_ORDER
from volt_real_profiles import (
    NUMERIC_BOUNDS,
    RealProfileError,
    load_profiles,
    save_user_profile,
    validate_tuning,
)
from volt_arm_workflow import (
    ArmSnapshot,
    EFFECT_OWNER_HOLD,
    EFFECT_OWNER_MOTION,
    EFFECT_SERIAL_ARM,
    EFFECT_SERIAL_HOLD,
    EFFECT_SERIAL_STATUS,
    EFFECT_ZERO_STOP,
    GuidedArmWorkflow,
    STATE_ARMED,
)
from volt_serial_protocol import (
    CRITICAL_STACK_TOPICS,
    duplicate_stack_topics,
    motion_status_allows_arm,
)
from volt_face import (
    FaceAutomation,
    FaceConfigError,
    SUPPORTED_EFFECTS,
    default_face_settings,
    load_face_catalog,
    load_face_settings,
    save_face_settings,
    settings_for_preset,
    validate_face_settings,
)

try:
    import pygame
except ImportError:
    pygame = None


GAIT_LIMITS = {
    name: (config["max_x"], config["max_y"], config["max_yaw"])
    for name, config in GAITS.items()
}

# Ordered slowest to fastest: STOP walks DOWN this list rather than halting a
# fast gait mid-cycle.
GAIT_SEQUENCE = (
    "amble",
    "trot",
    "run",
)
GAIT_DISPLAY_NAMES = {
    "amble": "AMBLE",
    "trot": "TROT",
    "run": "RUN",
}
DEFAULT_GAIT = "amble"
DEFAULT_SPEED_PERCENT = 20
MOTION_STATUS_TIMEOUT = 3.0
ROUTER_STATUS_TIMEOUT = 1.0
SERIAL_STATUS_TIMEOUT = 1.0
NEUTRAL_RELEASE_TIME = 0.25
STEP_KEEPALIVE_PERIOD = 0.25
EMOTE_REQUEST_ACK_TIMEOUT = 2.0
EMOTE_ERROR_DISPLAY_TIME = 5.0
PUSHUP_TRAVEL_MIN_MM = 10.0
PUSHUP_TRAVEL_MAX_MM = 60.0
PUSHUP_TRAVEL_DEFAULT_MM = 60.0
PUSHUP_TRAVEL_BASE_MM = 20.0

DISPLAYED_CARTESIAN_EMOTES = (
    ("PUSH-UPS", "push_ups"),
    ("BODY ROLL", "body_roll"),
    ("NOD / YES", "nod"),
    ("WAVE LEFT", "wave_left"),
    ("WAVE RIGHT", "wave_right"),
    ("HEART ❤️", "heart"),
    ("BOW", "bow"),
    ("STRETCH", "stretch"),
    ("HAPPY DANCE", "happy_dance"),
    ("SHAKE / NO", "shake_no"),
)
EMOTE_POSE_ACTIONS = (
    ("SIT", "sit"),
    ("STAND UP", "stand"),
)


def gui_emote_request_options(
    name,
    repetitions,
    speed,
    amplitude,
    depth,
    pushup_travel_mm,
):
    """Build GUI emote options, keeping push-up travel independent."""
    requested_depth = float(depth)
    if str(name).strip().lower() == "push_ups":
        travel_mm = max(
            PUSHUP_TRAVEL_MIN_MM,
            min(PUSHUP_TRAVEL_MAX_MM, float(pushup_travel_mm)),
        )
        requested_depth = travel_mm / PUSHUP_TRAVEL_BASE_MM
    return {
        "repetitions": int(round(float(repetitions))),
        "speed": float(speed),
        "amplitude": float(amplitude),
        "depth": requested_depth,
    }


def emote_start_blocker(
    name,
    advertised,
    command_owner,
    status_fresh,
    controller_connected,
    motion_state,
    physical_busy=False,
    emote_busy=False,
    controls_locked=False,
    duplicate_stack=False,
    pose_action=False,
):
    """Return the operator-facing reason an emote button must be disabled."""
    name = str(name).strip().lower()
    advertised = {
        str(value).strip().lower() for value in (advertised or ())
    }
    if duplicate_stack:
        return "Unavailable while duplicate VOLT stacks are active."
    if controls_locked:
        return "Unavailable while guided ARM is verifying the robot."
    if not pose_action and name not in advertised:
        return "The motion controller did not advertise this emote."
    if str(command_owner).strip().upper() != "MOTION":
        return "Press ENABLE MOTION to grant ROS command ownership."
    if not status_fresh:
        return "Waiting for a fresh motion-controller status."
    if not controller_connected:
        return "The motion controller is not connected to the joint controller."
    if physical_busy:
        return "Stop the active hardware diagnostic first."
    if emote_busy:
        return "Stop or wait for the current emote first."
    state = str(motion_state).strip().lower()
    if pose_action:
        if state in ("standing_up", "sitting_down"):
            return "Wait for the current pose transition to finish."
        target_state = "standing" if name == "stand" else "sitting"
        if state == target_state:
            return "The robot is already %s." % target_state.upper()
    elif state != "standing":
        return "Cartesian emotes require a fresh controller STANDING state."
    return ""


def merge_reported_real_profiles(local_profiles, reported_profiles, protected=()):
    """Merge controller profiles without replacing user-saved overlays."""
    merged = {
        str(name).strip().upper(): dict(values)
        for name, values in (local_profiles or {}).items()
    }
    protected_names = {
        str(name).strip().upper() for name in protected
    }
    if not isinstance(reported_profiles, dict):
        return merged
    for raw_name, raw_values in reported_profiles.items():
        name = str(raw_name).strip().upper()
        if not name or name in protected_names:
            continue
        try:
            merged[name] = validate_tuning(
                raw_values,
                allow_simulation=True,
            )
        except (RealProfileError, TypeError, ValueError):
            continue
    return merged


BALANCE_SENSITIVE_EMOTES = {
    "wave_left",
    "wave_right",
    "heart",
    "happy_dance",
}

# Default mapping for common Fantech / Xbox-style controllers.
# Bindings now live in volt_gamepad_bindings.py and are operator-editable
# from the GAMEPAD tab. DEFAULT_BINDINGS there reproduces the map that used
# to be hard-coded here.

# Physical stick pairs, for DRAWING the sticks on the binding diagram. Which
# signal an axis drives is a binding now (volt_gamepad_bindings.AXIS_*); this
# is only the hardware convention that axes 0/1 are the left stick and 2/3
# the right, so the diagram can show real deflection.
PAD_STICK_AXES = ((0, 1), (2, 3))

# Short tokens for the stick callouts. The full captions ("Drive forward /
# back") overflow the label gutter and get clipped; the axis editor under
# the diagram carries the long form.
PAD_AXIS_TOKENS = {
    "drive_forward": "fwd",
    "drive_horizontal": "steer",
    "yaw_trim": "trim",
}
GAMEPAD_DEADZONE = 0.10
GAMEPAD_DEADZONE_RELEASE = 0.07


def parse_key_value_status(payload):
    """Parse the bridge/router key=value status while tolerating future JSON."""
    try:
        parsed = json.loads(payload)
    except (TypeError, ValueError):
        parsed = None
    if isinstance(parsed, dict):
        return {
            str(key): str(int(value)) if isinstance(value, bool) else str(value)
            for key, value in parsed.items()
        }
    fields = {}
    for part in str(payload).split():
        if "=" not in part:
            continue
        key, value = part.split("=", 1)
        fields[key] = value
    return fields


def arm_readiness_view(workflow, snapshot, duplicate_stack_active=False):
    """Build the persistent ARM-gate text from the authoritative workflow."""
    if duplicate_stack_active:
        return {
            "title": "ARM LOCKED — DUPLICATE VOLT STACK",
            "detail": (
                "• More than one critical VOLT status authority is active.\n"
                "• Stop the extra stack before attempting physical output."
            ),
            "color": "#fca5a5",
            "blockers": ("duplicate VOLT stack detected",),
        }

    if workflow.active:
        reason = str(workflow.reason or "Waiting for interlock status.")
        return {
            "title": "GUIDED ARM ACTIVE — OUTPUT STILL INHIBITED",
            "detail": "Current step: %s\nCANCEL ARM / HOLD remains available." % reason,
            "color": "#fbbf24",
            "blockers": (),
        }

    if snapshot.armed or workflow.state == STATE_ARMED:
        serial_fresh = workflow.serial_is_fresh(snapshot)
        if snapshot.armed and snapshot.streaming and serial_fresh:
            title = "SYSTEM ARMED — LIVE SERVO OUTPUT"
            detail = (
                "Firmware is armed and frames are streaming. Use HOLD SERVOS "
                "or DISARM ARDUINO before approaching the robot."
            )
            color = "#fb7185"
        elif not serial_fresh:
            title = "ARM STATE UNKNOWN — SERIAL STATUS STALE"
            detail = (
                "The last report was armed. Treat the robot as live; use HOLD "
                "or DISARM and restore bridge status."
            )
            color = "#fca5a5"
        else:
            title = "ARDUINO ARMED — STREAMING INHIBITED"
            detail = (
                "Firmware reports armed but the bridge is not streaming. Use "
                "HOLD or DISARM before troubleshooting."
            )
            color = "#fbbf24"
        return {
            "title": title,
            "detail": detail,
            "color": color,
            "blockers": (),
        }

    blockers = workflow.start_blocker_details(snapshot)
    if blockers:
        count = len(blockers)
        noun = "BLOCKER" if count == 1 else "BLOCKERS"
        return {
            "title": "ARM LOCKED — %d %s" % (count, noun),
            "detail": "Resolve every condition:\n%s" % "\n".join(
                "• %s" % blocker for blocker in blockers
            ),
            "color": "#fbbf24",
            "blockers": blockers,
        }

    return {
        "title": "ARM READY — ALL PRE-FLIGHT GATES PASSED",
        "detail": (
            "The button is enabled. Guided ARM will re-check every gate, STOP "
            "motion, confirm fresh ownership and frames, then request ARM once."
        ),
        "color": "#86efac",
        "blockers": (),
    }


def face_host_sync_view(fields):
    """Summarize the firmware loading/host-sync handshake for the Control tab."""
    fields = fields or {}

    def flag(name, fallback=None):
        if name not in fields:
            return fallback
        return fields.get(name) == "1"

    connected = flag("connected", False)
    ready = flag("ready", False)
    if not connected:
        return "OFFLINE — no Arduino link", "#94a3b8"
    if not ready:
        return "LOADING — firmware handshake", "#fbbf24"

    led_error = fields.get("led_error", "")
    if led_error not in ("", "-"):
        return "ERROR — %s" % led_error.replace("_", " "), "#fca5a5"

    host_sync_state = str(fields.get("host_sync_state", "")).strip().lower()
    host_sync_error = fields.get("host_sync_error", "")
    if host_sync_state == "error" or host_sync_error not in ("", "-"):
        detail = (
            host_sync_error.replace("_", " ")
            if host_sync_error not in ("", "-")
            else "HOST SYNC failed"
        )
        return "LOADING BLOCKED — %s" % detail, "#fca5a5"
    state_text = {
        "waiting_ping": "LOADING — waiting for host PING",
        "applying_snapshot": "LOADING — applying GUI LED snapshot",
        "verifying_snapshot": "LOADING — verifying LED snapshot",
        "finalizing": "LOADING — waiting for HOST SYNC acknowledgement",
        "loading": "LOADING — waiting for host synchronization",
    }
    if host_sync_state in state_text:
        return state_text[host_sync_state], "#fbbf24"
    if host_sync_state == "synced":
        return "READY — HOST SYNCED", "#86efac"
    if host_sync_state == "legacy":
        if flag("face_supported", False) and flag("face_synced", False):
            return "READY — LED SETTINGS SYNCED (legacy firmware)", "#86efac"
        if not flag("face_supported", False):
            return "UNAVAILABLE — legacy firmware has no Face LEDs", "#94a3b8"

    host_sync_required = flag("host_sync_required", False)
    host_synced = flag("host_synced", flag("host_sync", False))
    face_synced = flag("face_synced", False)
    if host_sync_required and not host_synced:
        if not flag("host_ping", False):
            return "LOADING — waiting for host PING", "#fbbf24"
        if not flag("host_snapshot", False):
            return "LOADING — waiting for GUI LED snapshot", "#fbbf24"
        if flag("host_sync_pending", False):
            return "LOADING — waiting for HOST SYNC acknowledgement", "#fbbf24"
        if not face_synced:
            return "LOADING — applying and verifying LED snapshot", "#7dd3fc"
        return "LOADING — completing HOST SYNC", "#7dd3fc"

    if flag("face_loading", False):
        return "LOADING — waiting for host synchronization", "#fbbf24"
    if face_synced and (host_synced or not host_sync_required):
        suffix = "HOST SYNCED" if host_sync_required else "LED SETTINGS SYNCED"
        return "READY — %s" % suffix, "#86efac"
    if flag("face_supported", False):
        return "SYNCING — verifying LED settings", "#7dd3fc"
    return "UNAVAILABLE — firmware does not report Face LEDs", "#94a3b8"


def arduino_connection_view(fields):
    """Return an explicit physical-link state independent of ARM readiness."""
    fields = fields or {}
    connected = fields.get("connected") == "1"
    ready = fields.get("ready") == "1"
    dry_run = fields.get("dry_run") == "1"
    hardware_enabled = fields.get("hardware_enabled") == "1"
    if connected and ready:
        return "CONNECTED — READY", "#86efac"
    if connected:
        return "CONNECTED — INITIALIZING FIRMWARE", "#fbbf24"
    if dry_run and not hardware_enabled:
        return "DISCONNECTED — hardware disabled / dry-run", "#94a3b8"
    if dry_run:
        return "DISCONNECTED — dry-run (expected)", "#94a3b8"
    if not hardware_enabled:
        return "DISCONNECTED — hardware mode disabled", "#94a3b8"
    return "DISCONNECTED — check USB / serial port", "#fca5a5"


# Normalised controller geometry, 1000 x 620. One table drives the drawing,
# the hit testing and the callout lines, so a control can never be painted in
# one place and clickable in another.
#
# Indices follow the layout pygame reports for the usual XInput-style pads,
# which is what DEFAULT_BINDINGS was written against: 0-3 face, 4/5 bumpers,
# 6/7 back+start, 8/9 stick presses, 10 guide.
PAD_CONTROLS = (
    # (input name, x, y, radius, glyph, label side, label row)
    ("button_3", 990, 232, 30, "Y", "right", 0),
    ("button_1", 1038, 280, 30, "B", "right", 1),
    ("button_0", 990, 328, 30, "A", "right", 2),
    ("button_2", 942, 280, 30, "X", "right", 3),
    ("button_5", 1000, 150, 34, "RB", "right", 4),
    ("button_7", 892, 214, 22, "\u2261", "right", 5),
    ("button_9", 900, 410, 40, "R3", "right", 6),
    ("hat_up", 600, 236, 24, "\u25b2", "left", 0),
    ("hat_left", 556, 280, 24, "\u25c0", "left", 1),
    ("hat_down", 600, 324, 24, "\u25bc", "left", 2),
    ("hat_right", 644, 280, 24, "\u25b6", "left", 3),
    ("button_4", 600, 150, 34, "LB", "left", 4),
    ("button_6", 708, 214, 22, "\u25a3", "left", 5),
    ("button_8", 700, 410, 40, "L3", "left", 6),
    ("button_10", 800, 360, 22, "\u25c9", "left", 7),
)

# The space is wider than the controller on purpose: the outer 290 units on
# each side are label gutters. Callout text drawn outside the coordinate
# space is text the widget clips, which is what the first cut did.
PAD_W, PAD_H = 1600.0, 620.0
PAD_LABEL_X = 290.0


class GamepadDiagram(QWidget):
    """A clickable controller map for the binding tab.

    Drawn rather than shipped as an image on purpose: the same coordinate
    table produces the artwork, the hit regions and the callout lines, so
    they cannot drift, and the whole thing recolours with the theme and
    stays sharp at any size. It also lets a control light up the instant it
    is physically pressed, which is how an operator identifies a button
    without knowing its number.
    """

    controlClicked = pyqtSignal(str)

    def __init__(self, parent=None):
        super().__init__(parent)
        self.setMinimumHeight(300)
        self.setMouseTracking(True)
        self.setCursor(Qt.PointingHandCursor)
        self.bindings = {}
        self.pressed = set()
        self.selected = ""
        self.hovered = ""
        self.axes = []
        self.axis_bindings = {}

    # -- state ---------------------------------------------------------
    def set_bindings(self, bindings):
        self.bindings = dict(bindings)
        self.update()

    def set_pressed(self, names):
        names = set(names)
        if names != self.pressed:
            self.pressed = names
            self.update()

    def set_selected(self, name):
        if name != self.selected:
            self.selected = name
            self.update()

    def set_axes(self, values, axis_bindings=None):
        """Live stick deflection, so the sticks read as sticks."""
        values = list(values or [])
        if axis_bindings is not None:
            self.axis_bindings = dict(axis_bindings)
        if values != self.axes:
            self.axes = values
            self.update()

    def _axis(self, index):
        if 0 <= index < len(self.axes):
            try:
                return max(-1.0, min(1.0, float(self.axes[index])))
            except (TypeError, ValueError):
                return 0.0
        return 0.0

    # -- geometry ------------------------------------------------------
    def _scale(self):
        margin = 8.0
        usable_w = max(1.0, self.width() - 2 * margin)
        usable_h = max(1.0, self.height() - 2 * margin)
        factor = min(usable_w / PAD_W, usable_h / PAD_H)
        return (
            factor,
            margin + (usable_w - PAD_W * factor) / 2.0,
            margin + (usable_h - PAD_H * factor) / 2.0,
        )

    def _point(self, x, y):
        factor, dx, dy = self._scale()
        return QPointF(x * factor + dx, y * factor + dy)

    def control_at(self, position):
        factor, _dx, _dy = self._scale()
        for name, x, y, radius, _glyph, _side, _row in PAD_CONTROLS:
            centre = self._point(x, y)
            grab = max(radius * factor, 11.0)
            if (position.x() - centre.x()) ** 2 + (
                position.y() - centre.y()
            ) ** 2 <= grab * grab:
                return name
        return ""

    # -- events --------------------------------------------------------
    def mousePressEvent(self, event):
        name = self.control_at(event.pos())
        if name:
            self.set_selected(name)
            self.controlClicked.emit(name)

    def mouseMoveEvent(self, event):
        name = self.control_at(event.pos())
        if name != self.hovered:
            self.hovered = name
            self.setToolTip(
                "%s -> %s" % (
                    input_caption(name),
                    ACTION_CAPTIONS.get(self.bindings.get(name, ""), "unbound"),
                ) if name else ""
            )
            self.update()

    def leaveEvent(self, _event):
        if self.hovered:
            self.hovered = ""
            self.update()

    # -- painting ------------------------------------------------------
    def paintEvent(self, _event):
        painter = QPainter(self)
        painter.setRenderHint(QPainter.Antialiasing, True)
        factor, _dx, _dy = self._scale()

        outline = QColor("#3d4b5c")
        body = QColor("#111821")
        painter.fillRect(self.rect(), QColor("#0d131a"))

        # Body: two grips under a slab, drawn as one path so the silhouette
        # reads as a controller rather than a pile of circles.
        path = QPainterPath()
        path.moveTo(self._point(550, 150))
        path.cubicTo(self._point(680, 118), self._point(920, 118),
                     self._point(1050, 150))
        path.cubicTo(self._point(1130, 178), self._point(1180, 250),
                     self._point(1158, 330))
        path.cubicTo(self._point(1140, 470), self._point(1060, 560),
                     self._point(972, 540))
        path.cubicTo(self._point(910, 522), self._point(896, 452),
                     self._point(856, 430))
        path.cubicTo(self._point(820, 412), self._point(780, 412),
                     self._point(744, 430))
        path.cubicTo(self._point(704, 452), self._point(690, 522),
                     self._point(628, 540))
        path.cubicTo(self._point(540, 560), self._point(460, 470),
                     self._point(442, 330))
        path.cubicTo(self._point(420, 250), self._point(470, 178),
                     self._point(550, 150))
        painter.setPen(QPen(outline, max(1.6, 2.0 * factor)))
        painter.setBrush(QBrush(body))
        painter.drawPath(path)

        # Touchpad slab, purely cosmetic: it anchors the eye the way the
        # real controller does.
        painter.setPen(QPen(QColor("#28323d"), max(1.0, 1.4 * factor)))
        painter.setBrush(Qt.NoBrush)
        painter.drawRoundedRect(
            QRectF(self._point(730, 196), self._point(870, 268)),
            6.0 * factor, 6.0 * factor,
        )

        # Stick wells. The L3/R3 circles below are drawn on top and become
        # the moving cap, so the sticks read as sticks rather than as two
        # more buttons -- and the operator can see the deflection the
        # console is actually receiving.
        for (centre_x, centre_y), (ax_x, ax_y) in zip(
            ((700, 410), (900, 410)), PAD_STICK_AXES
        ):
            well = self._point(centre_x, centre_y)
            well_r = 62.0 * factor
            painter.setPen(QPen(QColor("#39465a"), max(1.2, 1.8 * factor)))
            painter.setBrush(QBrush(QColor("#0f151d")))
            painter.drawEllipse(well, well_r, well_r)
            deflect_x = self._axis(ax_x) * 22.0
            deflect_y = self._axis(ax_y) * 22.0
            if abs(deflect_x) > 0.5 or abs(deflect_y) > 0.5:
                tip = self._point(centre_x + deflect_x, centre_y + deflect_y)
                painter.setPen(QPen(QColor("#7dd3fc"), max(1.2, 2.0 * factor)))
                painter.drawLine(well, tip)

        label_font = QFont(self.font())
        label_font.setPointSizeF(max(7.0, 8.6 * factor * 1.6))
        glyph_font = QFont(self.font())
        glyph_font.setPointSizeF(max(6.5, 8.0 * factor * 1.6))
        glyph_font.setBold(True)

        rows_left = sum(1 for c in PAD_CONTROLS if c[5] == "left")
        rows_right = sum(1 for c in PAD_CONTROLS if c[5] == "right")

        for name, x, y, radius, glyph, side, row in PAD_CONTROLS:
            if name == "button_8":
                x += self._axis(PAD_STICK_AXES[0][0]) * 22.0
                y += self._axis(PAD_STICK_AXES[0][1]) * 22.0
            elif name == "button_9":
                x += self._axis(PAD_STICK_AXES[1][0]) * 22.0
                y += self._axis(PAD_STICK_AXES[1][1]) * 22.0
            centre = self._point(x, y)
            r = max(7.0, radius * factor)
            action = self.bindings.get(name, "")
            is_pressed = name in self.pressed
            is_selected = name == self.selected
            is_stop = action == "stop"

            if is_pressed:
                fill, edge = QColor("#86efac"), QColor("#bbf7d0")
            elif is_selected:
                fill, edge = QColor("#1e3a5f"), QColor("#7dd3fc")
            elif is_stop:
                fill, edge = QColor("#3f1d1d"), QColor("#fca5a5")
            elif action:
                fill, edge = QColor("#1b2531"), QColor("#64748b")
            else:
                fill, edge = QColor("#141b24"), QColor("#33414f")
            if name == self.hovered and not is_pressed:
                edge = QColor("#e2e8f0")

            painter.setPen(QPen(edge, max(1.4, (2.4 if is_selected else 1.7) * factor)))
            painter.setBrush(QBrush(fill))
            painter.drawEllipse(centre, r, r)

            painter.setFont(glyph_font)
            painter.setPen(QPen(QColor("#0b1118") if is_pressed else QColor("#94a3b8")))
            painter.drawText(
                QRectF(centre.x() - r, centre.y() - r, r * 2, r * 2),
                Qt.AlignCenter, glyph,
            )

            # Callout: leader line out to a label column, the way a controller
            # map in a game shows its bindings.
            total = rows_left if side == "left" else rows_right
            span_top, span_bottom = 60.0, PAD_H - 40.0
            step = (span_bottom - span_top) / max(1, total - 1) if total > 1 else 0
            label_y = span_top + row * step
            edge_x = PAD_LABEL_X if side == "left" else PAD_W - PAD_LABEL_X
            elbow = self._point(edge_x + (70 if side == "left" else -70), label_y)
            anchor_point = self._point(edge_x, label_y)

            painter.setPen(QPen(
                QColor("#86efac") if is_pressed
                else QColor("#7dd3fc") if is_selected
                else QColor("#334155"),
                max(1.0, 1.3 * factor),
            ))
            painter.drawLine(centre, elbow)
            painter.drawLine(elbow, anchor_point)

            painter.setFont(label_font)
            caption = ACTION_CAPTIONS.get(action, "")
            if not action:
                caption = "unbound"
            text = "%s  %s" % (input_caption(name), caption)
            if name in ("button_8", "button_9"):
                pair = PAD_STICK_AXES[0 if name == "button_8" else 1]
                driven = [
                    PAD_AXIS_TOKENS.get(
                        (self.axis_bindings.get(axis_input(i)) or {}).get(
                            "function", ""
                        ), ""
                    )
                    for i in pair
                ]
                driven = [token for token in dict.fromkeys(driven) if token]
                text += "  \u2b0d %s" % ("+".join(driven) if driven else "-")
            painter.setPen(QPen(
                QColor("#bbf7d0") if is_pressed
                else QColor("#7dd3fc") if is_selected
                else QColor("#fca5a5") if is_stop
                else QColor("#94a3b8") if action
                else QColor("#4b5563")
            ))
            box_w = (PAD_LABEL_X - 14.0) * factor
            rect = QRectF(
                anchor_point.x() - (box_w if side == "left" else 0.0),
                anchor_point.y() - 11.0 * factor * 1.6,
                box_w,
                22.0 * factor * 1.6,
            )
            painter.drawText(
                rect,
                (Qt.AlignRight if side == "left" else Qt.AlignLeft)
                | Qt.AlignVCenter,
                text,
            )
        painter.end()


class Joystick(QWidget):
    changed = pyqtSignal(float, float)

    def __init__(self):
        super().__init__()
        self.setMinimumSize(250, 250)
        self.setFocusPolicy(Qt.StrongFocus)
        self.vector = QPointF(0.0, 0.0)
        self.dragging = False

    def set_vector(self, forward, horizontal):
        magnitude = math.hypot(forward, horizontal)
        if magnitude > 1.0:
            forward /= magnitude
            horizontal /= magnitude
        self.vector = QPointF(horizontal, -forward)
        self.changed.emit(forward, horizontal)
        self.update()

    def update_from_mouse(self, position):
        center = QPointF(self.width() / 2.0, self.height() / 2.0)
        radius = max(1.0, min(self.width(), self.height()) * 0.36)
        dx = (position.x() - center.x()) / radius
        dy = (position.y() - center.y()) / radius
        magnitude = math.hypot(dx, dy)
        if magnitude > 1.0:
            dx /= magnitude
            dy /= magnitude
        self.vector = QPointF(dx, dy)
        self.changed.emit(-dy, dx)
        self.update()

    def mousePressEvent(self, event):
        if event.button() == Qt.LeftButton:
            self.dragging = True
            self.update_from_mouse(event.localPos())

    def mouseMoveEvent(self, event):
        if self.dragging:
            self.update_from_mouse(event.localPos())

    def mouseReleaseEvent(self, event):
        if event.button() == Qt.LeftButton:
            self.dragging = False
            self.set_vector(0.0, 0.0)

    def keyPressEvent(self, event):
        keys = {
            Qt.Key_W: (1.0, 0.0),
            Qt.Key_S: (-1.0, 0.0),
            Qt.Key_A: (0.0, -1.0),
            Qt.Key_D: (0.0, 1.0),
        }
        if event.key() in keys:
            self.set_vector(*keys[event.key()])
        else:
            super().keyPressEvent(event)

    def keyReleaseEvent(self, event):
        if not event.isAutoRepeat() and event.key() in (
            Qt.Key_W,
            Qt.Key_A,
            Qt.Key_S,
            Qt.Key_D,
        ):
            self.set_vector(0.0, 0.0)

    def focusOutEvent(self, event):
        """Never retain a keyboard/mouse command after GUI focus is lost."""
        self.dragging = False
        self.set_vector(0.0, 0.0)
        super().focusOutEvent(event)

    def paintEvent(self, _event):
        painter = QPainter(self)
        painter.setRenderHint(QPainter.Antialiasing)
        center = QPointF(self.width() / 2.0, self.height() / 2.0)
        radius = min(self.width(), self.height()) * 0.36

        painter.setPen(QPen(QColor("#3a4658"), 2))
        painter.setBrush(QColor("#17202d"))
        painter.drawEllipse(center, radius, radius)

        painter.setPen(QPen(QColor("#344054"), 1))
        painter.drawLine(
            QPointF(center.x() - radius, center.y()),
            QPointF(center.x() + radius, center.y()),
        )
        painter.drawLine(
            QPointF(center.x(), center.y() - radius),
            QPointF(center.x(), center.y() + radius),
        )

        knob = QPointF(
            center.x() + self.vector.x() * radius,
            center.y() + self.vector.y() * radius,
        )
        painter.setPen(QPen(QColor("#7dd3fc"), 3))
        painter.setBrush(QColor("#0ea5e9"))
        painter.drawEllipse(knob, 23, 23)


class VoltGuiNode(Node):
    def __init__(
        self,
        status_callback,
        router_status_callback,
        serial_status_callback,
    ):
        super().__init__("volt_control_gui")
        self.velocity_publisher = self.create_publisher(Twist, "/cmd_vel", 10)
        self.yaw_trim_publisher = self.create_publisher(
            Float64, "/volt/yaw_trim", 10
        )
        self.action_publisher = self.create_publisher(String, "/volt/action", 10)
        self.gait_publisher = self.create_publisher(String, "/volt/gait", 10)
        self.owner_publisher = self.create_publisher(String, "/volt/command_owner", 10)
        self.serial_command_publisher = self.create_publisher(
            String,
            "/volt/serial_command",
            10,
        )
        self.real_tuning_publisher = self.create_publisher(
            String,
            "/volt/real_robot_tuning",
            10,
        )
        self.emote_publisher = self.create_publisher(
            String,
            "/volt/emote",
            10,
        )
        self.physical_test_publisher = self.create_publisher(
            String,
            "/volt/physical_test",
            10,
        )
        self.pose_publisher = self.create_publisher(
            Twist,
            "/volt/body_pose",
            10,
        )
        self.face_expression_publisher = self.create_publisher(
            String,
            "/volt/face/expression",
            10,
        )
        self.face_color_publisher = self.create_publisher(
            ColorRGBA,
            "/volt/face/color",
            10,
        )
        self.face_alternate_color_publisher = self.create_publisher(
            ColorRGBA,
            "/volt/face/alternate_color",
            10,
        )
        self.face_brightness_publisher = self.create_publisher(
            UInt8,
            "/volt/face/brightness",
            10,
        )
        self.face_effect_publisher = self.create_publisher(
            String,
            "/volt/face/effect",
            10,
        )
        self.face_speed_publisher = self.create_publisher(
            UInt32,
            "/volt/face/speed",
            10,
        )
        self.create_subscription(String, "/volt/status", status_callback, 10)
        self.create_subscription(
            String,
            "/volt/command_router_status",
            router_status_callback,
            10,
        )
        self.create_subscription(
            String,
            "/volt/serial_status",
            serial_status_callback,
            10,
        )

    def publish_text(self, publisher, text):
        if not rclpy.ok():
            return False
        message = String()
        message.data = text
        try:
            publisher.publish(message)
            return True
        except Exception:
            return False

    def critical_publisher_counts(self):
        return {
            topic: len(self.get_publishers_info_by_topic(topic))
            for topic in CRITICAL_STACK_TOPICS
        }

    def claim_motion_owner(self):
        return self.publish_text(self.owner_publisher, "MOTION")

    def set_command_owner(self, owner):
        owner = str(owner).strip().upper()
        if owner not in ("MOTION", "HOLD", "DISABLED"):
            return False
        return self.publish_text(self.owner_publisher, owner)

    def send_serial_command(self, command):
        allowed = ("ARM", "HOLD", "DISARM", "DISABLE", "STATUS", "PING")
        command = command.strip().upper()
        if command not in allowed:
            return False
        return self.publish_text(self.serial_command_publisher, command)

    def publish_json(self, publisher, payload):
        try:
            encoded = json.dumps(payload, sort_keys=True, allow_nan=False)
        except (TypeError, ValueError):
            return False
        return self.publish_text(publisher, encoded)

    def publish_face_expression(self, expression):
        return self.publish_text(
            self.face_expression_publisher,
            str(expression).strip().lower(),
        )

    def publish_face_color(self, color):
        if not rclpy.ok():
            return False
        try:
            red, green, blue = (
                max(0, min(255, int(component))) for component in color
            )
            message = ColorRGBA()
            message.r = red / 255.0
            message.g = green / 255.0
            message.b = blue / 255.0
            message.a = 1.0
            self.face_color_publisher.publish(message)
            return True
        except Exception:
            return False

    def publish_face_alternate_color(self, color):
        if not rclpy.ok():
            return False
        try:
            red, green, blue = (
                max(0, min(255, int(component))) for component in color
            )
            message = ColorRGBA()
            message.r = red / 255.0
            message.g = green / 255.0
            message.b = blue / 255.0
            message.a = 1.0
            self.face_alternate_color_publisher.publish(message)
            return True
        except Exception:
            return False

    def publish_face_brightness(self, brightness):
        if not rclpy.ok():
            return False
        try:
            message = UInt8()
            message.data = max(0, min(255, int(brightness)))
            self.face_brightness_publisher.publish(message)
            return True
        except Exception:
            return False

    def publish_face_speed(self, speed_ms):
        if not rclpy.ok():
            return False
        try:
            message = UInt32()
            message.data = max(10, min(60000, int(speed_ms)))
            self.face_speed_publisher.publish(message)
            return True
        except Exception:
            return False

    def publish_face_effect(self, effect):
        return self.publish_text(
            self.face_effect_publisher,
            str(effect).strip().lower(),
        )

    def publish_face_settings(self, settings):
        """Publish one bounded snapshot; the bridge deduplicates/resyncs it."""
        if not settings.enabled:
            return self.publish_face_effect("off")
        # FACE shutdown owns its smooth fade in firmware.  Following it with
        # COLOR/BRIGHTNESS/EFFECT would replace that state with immediate off.
        if str(settings.expression).strip().lower() == "shutdown":
            return self.publish_face_expression("shutdown")
        results = (
            self.publish_face_expression(settings.expression),
            self.publish_face_color(settings.color),
            self.publish_face_alternate_color(settings.alternate_color),
            self.publish_face_brightness(settings.brightness),
            self.publish_face_speed(settings.speed_ms),
            self.publish_face_effect(settings.effect),
        )
        return all(results)


class VoltControlWindow(QMainWindow):
    def __init__(self):
        super().__init__()
        self.setWindowTitle("VOLT Motion Control")
        self.resize(1280, 800)
        self.setMinimumSize(1120, 560)

        self.ros_node = VoltGuiNode(
            self.status_callback,
            self.router_status_callback,
            self.serial_status_callback,
        )
        self.shutting_down = False
        self.duplicate_stack_active = False
        self.duplicate_stack_topics = ()
        self.forward = 0.0
        self.horizontal = 0.0
        # Start on the stable crawl with zero controls. Command ownership remains
        # unclaimed until the operator explicitly presses ENABLE MOTION.
        self.current_gait = DEFAULT_GAIT
        # Operator-editable gamepad map. Loaded before any widget is built
        # because build_gamepad_tab() reads it.
        self.gamepad_bindings, self.gamepad_binding_load_error = load_bindings()
        self.gamepad_axis_bindings, axis_error = load_axis_bindings()
        self.gamepad_axis_values = []
        if axis_error and not self.gamepad_binding_load_error:
            self.gamepad_binding_load_error = axis_error
        self.gait_limits = dict(GAIT_LIMITS)
        # Hardware-effective limits (max_x * hardware_speed_scale). The GUI
        # scales the speed slider by THESE, not by the raw command limits:
        # the controller clamps at the effective value, so scaling the raw
        # one left the slider's top 20% doing nothing at all.
        self.effective_limits = dict(GAIT_LIMITS)
        self.yaw_trim_limit = 0.0
        self.speed_floor_percent = 10
        self.yaw_trim_clipped = False
        self.firmware_guard_clip = "-"
        try:
            shipped_profiles = load_profiles(include_user=False)
            self.real_profiles = load_profiles()
            self.user_real_profile_names = {
                name
                for name, values in self.real_profiles.items()
                if name not in shipped_profiles
                or values != shipped_profiles[name]
            }
        except (OSError, RealProfileError, ValueError):
            self.real_profiles = {}
            self.user_real_profile_names = set()
        self.real_tuning_dirty = False
        self.real_tuning_initialized = False
        self.body_profile_hydrated = False
        self.pending_real_tuning_request = ""
        self.active_real_profile = ""
        self.hardware_mode = False
        self.physical_tests_enabled = False
        self.active_physical_request = None
        self.physical_test_was_active = False
        self.active_emote_request = None
        self.emote_was_active = False
        self.available_emotes = set()
        self.emote_catalog_received = False
        self.emote_catalog_error = ""
        self.controller_emote_busy = False
        self.controller_emote_request_id = ""
        self.emote_notice = ""
        self.emote_notice_color = "#94a3b8"
        self.emote_notice_time = 0.0
        self.pending_emote_pose_action = None
        self.command_owner = "UNKNOWN"
        # The router refreshes MOTION ownership from the pose stream, so an
        # idle or stopped controller lets ownership lapse after stale_timeout
        # and the robot drops to HOLD on its own.  Re-assert the operator's
        # standing intent instead.  Gated on an explicit request and cleared
        # by every HOLD/DISABLE path, so a dead GUI still stops publishing and
        # the router still holds -- the liveness guarantee is unchanged.
        self.motion_ownership_requested = False
        self.last_owner_heartbeat = 0.0
        self.last_router_status_time = 0.0
        self.router_pose_valid = False
        self.last_serial_status_time = 0.0
        self.last_serial_status_fields = {}
        self.arm_workflow = GuidedArmWorkflow(
            motion_timeout=MOTION_STATUS_TIMEOUT,
            router_timeout=ROUTER_STATUS_TIMEOUT,
            serial_timeout=SERIAL_STATUS_TIMEOUT,
        )
        self.arm_workflow_notice = ""
        self.motion_neutral_latched = True
        self.motion_neutral_since = 0.0
        self.position_controller_connected = False
        self.open_loop_hardware = False
        self.motion_state = "unknown"
        self.motion_moving = True
        self.motion_step_in_place = False
        self.motion_arm_neutral_ready = False
        self.last_step_keepalive_publish_time = 0.0
        self.motion_controller_connected = False
        self.last_motion_status_time = 0.0
        self.console_host = socket.gethostname()
        self.robot_host = ""
        self.bridge_host = ""
        self.board_wifi_ssid = ""
        self.board_wifi_rssi = 0
        self.motion_status_rate = 0.0
        self.motion_status_window_start = 0.0
        self.motion_status_window_count = 0
        self.gamepad = None
        self.gamepad_name = ""
        self.gamepad_buttons = {}
        self.gamepad_axis_active = {}
        self.gamepad_available = pygame is not None
        self.gamepad_enabled = True
        self.last_gamepad_scan = 0.0
        self.arm_controls_locked = False
        self.arm_frozen_pose = None
        self.last_face_motion_status = {}
        try:
            self.face_catalog = load_face_catalog()
            self.face_settings = load_face_settings(self.face_catalog)
            self.face_config_error = ""
        except (OSError, FaceConfigError, ValueError) as exc:
            self.face_catalog = None
            self.face_settings = None
            self.face_config_error = str(exc)
        self.face_automation = (
            FaceAutomation(self.face_catalog, self.face_settings)
            if self.face_catalog is not None and self.face_settings is not None
            else None
        )
        self.face_last_requested_settings = self.face_settings
        self.face_connection_active = False
        if self.gamepad_available:
            pygame.init()
            pygame.joystick.init()

        self.build_ui()
        self.stabilize_status_labels()
        self.apply_style()

        self.spin_timer = QTimer(self)
        self.spin_timer.timeout.connect(self.spin_ros)
        self.spin_timer.start(10)

        self.command_timer = QTimer(self)
        self.command_timer.timeout.connect(self.publish_motion)
        self.command_timer.start(50)

        self.pose_timer = QTimer(self)
        self.pose_timer.timeout.connect(self.publish_pose)
        self.pose_timer.start(100)

        self.gamepad_timer = QTimer(self)
        self.gamepad_timer.timeout.connect(self.poll_gamepad)
        self.gamepad_timer.start(30)

        # Grace period before an unfocused window disarms.  Long enough to
        # survive notifications, window switches and a look at the simulator;
        # short enough that a genuinely abandoned console still ends safe.
        self.focus_hold_grace_seconds = 20.0
        self.focus_hold_timer = QTimer(self)
        self.focus_hold_timer.setSingleShot(True)
        self.focus_hold_timer.timeout.connect(self.focus_hold_timeout)
        self.arm_workflow_timer = QTimer(self)
        self.arm_workflow_timer.timeout.connect(self.advance_arm_workflow)
        self.arm_workflow_timer.setInterval(50)

        self.arm_status_timer = QTimer(self)
        self.arm_status_timer.timeout.connect(self.refresh_arm_status_freshness)
        self.arm_status_timer.start(250)

        self.diagnostic_timer = QTimer(self)
        self.diagnostic_timer.timeout.connect(self.publish_diagnostic_keepalive)
        self.diagnostic_timer.start(200)

        self.face_test_timer = QTimer(self)
        self.face_test_timer.setInterval(450)
        self.face_test_timer.timeout.connect(self.advance_face_test)
        self.face_test_steps = []

    def build_ui(self):
        root = QWidget()
        root.setObjectName("root")
        self.setCentralWidget(root)
        outer = QVBoxLayout(root)
        outer.setContentsMargins(16, 10, 16, 12)
        outer.setSpacing(9)

        header = QHBoxLayout()
        header.setSpacing(14)

        title = QLabel("VOLT")
        title.setObjectName("title")
        subtitle = QLabel("Quadruped motion console")
        subtitle.setObjectName("subtitle")
        header.addWidget(title)
        header.addWidget(subtitle)
        header.addStretch(1)
        # Where the robot half is running. In the split Jetson stack the
        # nodes driving the servos are on another machine, and a console
        # that looks identical either way is a console that can mislead.
        # Lives in the header so it is visible from every tab.
        self.robot_link_label = QLabel("Robot link: waiting")
        self.robot_link_label.setObjectName("robotLink")
        self.robot_link_label.setToolTip(
            "Which machine is running the motion controller and serial "
            "bridge, and how fresh its status is."
        )
        header.addWidget(self.robot_link_label)
        outer.addLayout(header)

        self.main_tabs = QTabWidget()
        self.main_tabs.setObjectName("mainTabs")
        self.main_tabs.setDocumentMode(True)
        outer.addWidget(self.main_tabs, 1)

        def add_scroll_tab(title, object_name):
            scroll = QScrollArea()
            scroll.setObjectName(object_name)
            scroll.setWidgetResizable(True)
            scroll.setFrameShape(QFrame.NoFrame)
            page = QWidget()
            scroll.setWidget(page)
            self.main_tabs.addTab(scroll, title)
            return page

        control_page = add_scroll_tab("CONTROL", "controlScroll")
        self.control_page = control_page
        emotes_face_page = add_scroll_tab("EMOTES + FACE", "expressionsScroll")
        tuning_page = add_scroll_tab("TUNING", "tuningScroll")
        diagnostics_page = add_scroll_tab("DIAGNOSTICS", "diagnosticsScroll")
        gamepad_page = add_scroll_tab("GAMEPAD", "gamepadScroll")
        self.gamepad_tab_index = self.main_tabs.count() - 1

        workspace = QHBoxLayout(control_page)
        workspace.setContentsMargins(0, 8, 0, 0)
        workspace.setSpacing(14)

        emotes_face_layout = QGridLayout(emotes_face_page)
        emotes_face_layout.setContentsMargins(0, 8, 0, 0)
        emotes_face_layout.setHorizontalSpacing(14)
        emotes_face_layout.setVerticalSpacing(10)
        emotes_face_layout.setColumnStretch(0, 5)
        emotes_face_layout.setColumnStretch(1, 6)

        tuning_workspace = QHBoxLayout(tuning_page)
        tuning_workspace.setContentsMargins(0, 8, 0, 0)
        tuning_workspace.setSpacing(14)
        tuning_left = QVBoxLayout()
        tuning_left.setSpacing(10)
        tuning_right = QVBoxLayout()
        tuning_right.setSpacing(10)
        tuning_workspace.addLayout(tuning_left, 4)
        tuning_workspace.addLayout(tuning_right, 7)

        diagnostics_layout = QGridLayout(diagnostics_page)
        diagnostics_layout.setContentsMargins(0, 8, 0, 0)
        diagnostics_layout.setHorizontalSpacing(14)
        diagnostics_layout.setVerticalSpacing(10)
        diagnostics_layout.setColumnStretch(0, 3)
        diagnostics_layout.setColumnStretch(1, 2)

        left = QVBoxLayout()
        left.setSpacing(10)

        state_group = QGroupBox("Robot State")
        state_layout = QGridLayout(state_group)
        self.state_label = QLabel("WAITING")
        self.state_label.setObjectName("state")
        self.status_detail = QLabel("Waiting for controller status")
        self.status_detail.setWordWrap(True)
        state_layout.addWidget(self.state_label, 0, 0, 1, 3)
        state_layout.addWidget(self.status_detail, 1, 0, 1, 3)

        self.stand_button = QPushButton("STAND")
        self.stand_button.clicked.connect(lambda: self.send_action("stand"))
        self.sit_button = QPushButton("SIT")
        self.sit_button.clicked.connect(lambda: self.send_action("sit"))
        stop_button = QPushButton("STOP")
        stop_button.setObjectName("stop")
        stop_button.clicked.connect(lambda: self.send_action("stop"))
        state_layout.addWidget(self.stand_button, 2, 0)
        state_layout.addWidget(self.sit_button, 2, 1)
        state_layout.addWidget(stop_button, 2, 2)
        left.addWidget(state_group)

        owner_group = QGroupBox("ROS Command Ownership")
        owner_layout = QGridLayout(owner_group)
        self.owner_state = QLabel("ACTIVE OWNER: UNKNOWN")
        self.owner_state.setObjectName("ownerState")
        self.owner_state.setWordWrap(True)
        self.enable_motion_button = QPushButton("ENABLE MOTION")
        self.enable_motion_button.setObjectName("motionEnable")
        self.enable_motion_button.clicked.connect(self.enable_motion)
        hold_motion = QPushButton("HOLD")
        hold_motion.clicked.connect(self.hold_motion)
        disable_motion = QPushButton("DISABLE OUTPUT COMMANDS")
        disable_motion.setObjectName("motionDisable")
        disable_motion.clicked.connect(self.disable_motion)
        owner_layout.addWidget(self.owner_state, 0, 0, 1, 2)
        owner_layout.addWidget(self.enable_motion_button, 1, 0)
        owner_layout.addWidget(hold_motion, 1, 1)
        owner_layout.addWidget(disable_motion, 2, 0, 1, 2)
        left.addWidget(owner_group)

        gait_group = QGroupBox("Gait")
        gait_layout = QGridLayout(gait_group)
        self.gait_buttons = QButtonGroup(self)
        self.gait_buttons.setExclusive(True)
        self.gait_button_by_name = {}
        gait_choices = tuple(
            (gait, GAIT_DISPLAY_NAMES[gait])
            for gait in GAIT_SEQUENCE
        )
        for index, (gait, label) in enumerate(gait_choices):
            button = QPushButton(label)
            button.setCheckable(True)
            button.clicked.connect(
                lambda checked, name=gait: self.select_gait(name)
            )
            self.gait_buttons.addButton(button)
            self.gait_button_by_name[gait] = button
            gait_layout.addWidget(button, index // 3, index % 3)
            if gait == DEFAULT_GAIT:
                button.setChecked(True)

        gait_rows = (len(gait_choices) + 2) // 3
        self.step_button = QPushButton("STEP IN PLACE")
        self.step_button.setCheckable(True)
        self.step_button.clicked.connect(lambda: self.send_action("step"))
        gait_layout.addWidget(self.step_button, gait_rows, 0, 1, 3)
        self.gait_detail = QLabel(
            "Requested: VOLT WALK | Active: waiting | Phase: waiting"
        )
        self.gait_detail.setObjectName("gaitDetail")
        self.gait_detail.setWordWrap(True)
        gait_layout.addWidget(self.gait_detail, gait_rows + 1, 0, 1, 3)
        left.addWidget(gait_group)

        speed_group = QGroupBox("Motion")
        speed_layout = QFormLayout(speed_group)
        self.drive_mode = QComboBox()
        self.drive_mode.addItems(["Normal steering", "Crab / omnidirectional"])
        speed_layout.addRow("Drive mode", self.drive_mode)

        self.speed_slider = QSlider(Qt.Horizontal)
        self.speed_slider.setRange(10, 100)
        self.speed_slider.setValue(DEFAULT_SPEED_PERCENT)
        self.speed_slider.setTickPosition(QSlider.TicksBelow)
        self.speed_slider.setTickInterval(25)
        speed_layout.addRow("Speed limit", self.speed_slider)

        self.yaw_slider = QSlider(Qt.Horizontal)
        self.yaw_slider.setRange(-100, 100)
        self.yaw_slider.setValue(0)
        self.yaw_slider.setTickPosition(QSlider.TicksBelow)
        self.yaw_slider.setTickInterval(50)
        speed_layout.addRow("Yaw trim", self.yaw_slider)
        left.addWidget(speed_group)

        tuning_left.addStretch(1)

        controller_group = QGroupBox("Controller")
        controller_layout = QGridLayout(controller_group)
        self.controller_state = QLabel("NOT CONNECTED")
        self.controller_state.setObjectName("controllerState")
        self.controller_detail = QLabel(
            "Left stick: move/turn | Right stick X: yaw trim\n"
            "A stand | B sit | X stop | Y step | LB/RB gait"
        )
        self.controller_detail.setWordWrap(True)
        self.controller_enable = QPushButton("GAMEPAD ENABLED")
        self.controller_enable.setCheckable(True)
        self.controller_enable.setChecked(True)
        self.controller_enable.clicked.connect(self.toggle_gamepad)
        controller_layout.addWidget(self.controller_state, 0, 0, 1, 2)
        controller_layout.addWidget(self.controller_detail, 1, 0, 1, 2)
        controller_layout.addWidget(self.controller_enable, 2, 0, 1, 2)
        left.addStretch(1)
        workspace.addLayout(left, 4)

        center = QVBoxLayout()
        center.setSpacing(10)
        joystick_group = QGroupBox("Direction")
        joystick_layout = QVBoxLayout(joystick_group)
        self.joystick = Joystick()
        self.joystick.setSizePolicy(QSizePolicy.Expanding, QSizePolicy.Expanding)
        self.joystick.setMaximumSize(380, 380)
        self.joystick.changed.connect(self.joystick_changed)
        joystick_layout.addWidget(self.joystick, alignment=Qt.AlignCenter)
        hint = QLabel(
            "Drag the pad or use W A S D. Release to stop.\n"
            "Normal: left/right turns. Crab: left/right translates."
        )
        hint.setAlignment(Qt.AlignCenter)
        hint.setObjectName("hint")
        joystick_layout.addWidget(hint)
        joystick_group.setMaximumHeight(460)
        center.addWidget(joystick_group)

        safety = QFrame()
        safety.setObjectName("safety")
        safety_layout = QVBoxLayout(safety)
        safety_title = QLabel("Command safety")
        safety_title.setObjectName("safetyTitle")
        safety_text = QLabel(
            "Velocity stops automatically if GUI messages are lost.\n"
            "Use STOP before switching between tests."
        )
        safety_text.setWordWrap(True)
        safety_layout.addWidget(safety_title)
        safety_layout.addWidget(safety_text)
        center.addWidget(safety)
        center.addWidget(controller_group)
        center.addStretch(1)
        workspace.addLayout(center, 5)

        right = QVBoxLayout()
        right.setSpacing(10)

        hardware_group = QGroupBox("Arduino / Physical Robot")
        hardware_layout = QVBoxLayout(hardware_group)
        hardware_layout.setSpacing(8)

        self.hardware_state = QLabel("WAITING FOR SERIAL BRIDGE")
        self.hardware_state.setObjectName("hardwareState")
        self.hardware_state.setWordWrap(True)
        hardware_layout.addWidget(self.hardware_state)

        hardware_status = QGridLayout()
        hardware_status.setHorizontalSpacing(12)
        hardware_status.setVerticalSpacing(3)
        bridge_caption = QLabel("Serial bridge")
        bridge_caption.setObjectName("statusCaption")
        device_caption = QLabel("Arduino connection")
        device_caption.setObjectName("statusCaption")
        output_caption = QLabel("Servo output")
        output_caption.setObjectName("statusCaption")
        face_sync_caption = QLabel("Face LEDs / host sync")
        face_sync_caption.setObjectName("statusCaption")
        self.hardware_bridge = QLabel("WAITING FOR STATUS")
        self.hardware_device = QLabel("UNKNOWN — waiting for status")
        self.hardware_output = QLabel("Disabled")
        self.hardware_face_sync = QLabel("UNKNOWN — waiting for Arduino")
        self.hardware_face_sync.setWordWrap(True)
        hardware_status.addWidget(bridge_caption, 0, 0)
        hardware_status.addWidget(self.hardware_bridge, 0, 1)
        hardware_status.addWidget(device_caption, 1, 0)
        hardware_status.addWidget(self.hardware_device, 1, 1)
        hardware_status.addWidget(output_caption, 2, 0)
        hardware_status.addWidget(self.hardware_output, 2, 1)
        hardware_status.addWidget(face_sync_caption, 3, 0)
        hardware_status.addWidget(self.hardware_face_sync, 3, 1)
        hardware_status.setColumnStretch(1, 1)
        hardware_layout.addLayout(hardware_status)

        arm_gate = QFrame()
        arm_gate.setObjectName("armGate")
        arm_gate_layout = QVBoxLayout(arm_gate)
        arm_gate_layout.setContentsMargins(9, 7, 9, 7)
        arm_gate_layout.setSpacing(4)
        self.arm_readiness_state = QLabel("ARM LOCKED — WAITING FOR STATUS")
        self.arm_readiness_state.setObjectName("armReadinessState")
        self.arm_readiness_state.setWordWrap(True)
        self.arm_blockers_label = QLabel(
            "• serial status is missing or stale\n"
            "• Arduino connection state is unknown"
        )
        self.arm_blockers_label.setObjectName("armBlockers")
        self.arm_blockers_label.setWordWrap(True)
        self.arm_blockers_label.setSizePolicy(
            QSizePolicy.Preferred,
            QSizePolicy.Minimum,
        )
        self.arm_blockers_label.setTextInteractionFlags(Qt.TextSelectableByMouse)
        arm_gate_layout.addWidget(self.arm_readiness_state)
        arm_gate_layout.addWidget(self.arm_blockers_label)
        hardware_layout.addWidget(arm_gate)

        self.hardware_detail = QLabel(
            "Launch the serial bridge with hardware enabled. It reconnects "
            "automatically; arming unlocks only after the Arduino reports ready."
        )
        self.hardware_detail.setObjectName("hardwareDetail")
        self.hardware_detail.setWordWrap(True)
        hardware_layout.addWidget(self.hardware_detail)

        status_button = QPushButton("REQUEST STATUS")
        status_button.setObjectName("hardwareRefresh")
        status_button.setToolTip(
            "Request current firmware status. The bridge handles connection automatically."
        )
        status_button.clicked.connect(lambda: self.send_serial_command("STATUS"))
        hardware_layout.addWidget(status_button)

        safe_actions_caption = QLabel("Safe actions")
        safe_actions_caption.setObjectName("statusCaption")
        hardware_layout.addWidget(safe_actions_caption)

        hardware_actions = QGridLayout()
        hardware_actions.setHorizontalSpacing(8)
        hardware_actions.setVerticalSpacing(8)

        self.hardware_arm_button = QPushButton("ARM SYSTEM SAFELY")
        self.hardware_arm_button.setObjectName("hardwareArm")
        self.hardware_arm_button.setEnabled(False)
        self.hardware_arm_button.setToolTip(
            "Guided STOP, MOTION-ownership, fresh-frame, and Arduino ARM sequence."
        )
        self.hardware_arm_button.clicked.connect(
            self.arm_system_safely
        )

        hold_button = QPushButton("HOLD SERVOS")
        hold_button.setToolTip("Stop streaming motion and hold the current targets.")
        hold_button.clicked.connect(
            lambda: self.send_hardware_safe_command("HOLD")
        )

        disarm_button = QPushButton("DISARM ARDUINO")
        disarm_button.setObjectName("hardwareSafe")
        disarm_button.setToolTip("Stop accepting servo motion commands.")
        disarm_button.clicked.connect(
            lambda: self.send_hardware_safe_command("DISARM")
        )

        disable_button = QPushButton("DISABLE SERVO OUTPUTS")
        disable_button.setObjectName("hardwareDisable")
        disable_button.setToolTip("Disarm and switch off PCA9685 servo pulses.")
        disable_button.clicked.connect(
            lambda: self.send_hardware_safe_command("DISABLE")
        )

        hardware_actions.addWidget(hold_button, 0, 0)
        hardware_actions.addWidget(disarm_button, 0, 1)
        hardware_actions.addWidget(disable_button, 1, 0, 1, 2)
        hardware_actions.setColumnStretch(0, 1)
        hardware_actions.setColumnStretch(1, 1)
        hardware_layout.addLayout(hardware_actions)

        hardware_warning = QLabel(
            "ARM SYSTEM SAFELY sequences both safety layers but never bypasses "
            "their checks. Support the robot, clear the legs, and keep the "
            "power disconnect accessible."
        )
        hardware_warning.setObjectName("hardwareWarning")
        hardware_warning.setWordWrap(True)
        hardware_layout.addWidget(hardware_warning)
        hardware_layout.addWidget(self.hardware_arm_button)
        right.addWidget(hardware_group)

        pose_group = QGroupBox("Body Pose")
        pose_layout = QGridLayout(pose_group)
        pose_layout.setHorizontalSpacing(8)
        pose_layout.setVerticalSpacing(5)
        self.body_height = self.make_spinbox(0.175, 0.220, 0.200, 0.001, 3)
        self.body_x = self.make_spinbox(-0.025, 0.025, 0.0, 0.002, 3)
        self.body_y = self.make_spinbox(-0.020, 0.020, 0.0, 0.002, 3)
        self.roll = self.make_spinbox(-9.0, 9.0, 0.0, 1.0, 1)
        self.pitch = self.make_spinbox(-9.0, 9.0, 0.0, 1.0, 1)
        self.yaw = self.make_spinbox(-10.0, 10.0, 0.0, 1.0, 1)
        pose_fields = (
            ("Height (m)", self.body_height),
            ("Body X (m)", self.body_x),
            ("Body Y (m)", self.body_y),
            ("Roll (deg)", self.roll),
            ("Pitch (deg)", self.pitch),
            ("Yaw (deg)", self.yaw),
        )
        for index, (label_text, control) in enumerate(pose_fields):
            row = (index // 3) * 2
            column = index % 3
            label = QLabel(label_text)
            label.setObjectName("poseCaption")
            control.setSizePolicy(QSizePolicy.Expanding, QSizePolicy.Fixed)
            pose_layout.addWidget(label, row, column)
            pose_layout.addWidget(control, row + 1, column)
            pose_layout.setColumnStretch(column, 1)

        self.reset_pose_button = QPushButton("RESET BODY POSE")
        self.reset_pose_button.clicked.connect(self.reset_body_pose)
        pose_layout.addWidget(self.reset_pose_button, 4, 0, 1, 3)
        right.addWidget(pose_group)

        tuning_group = QGroupBox("Real Robot Tuning")
        tuning_layout = QGridLayout(tuning_group)
        tuning_layout.setHorizontalSpacing(8)
        tuning_layout.setVerticalSpacing(5)
        self.real_profile_combo = QComboBox()
        ordered_profiles = [
            name
            for name in (
                "REAL_DIAGNOSTIC",
                "REAL_SAFE",
                "REAL_NORMAL",
                "SIMULATION",
            )
            if name in self.real_profiles
        ]
        ordered_profiles.extend(
            sorted(set(self.real_profiles) - set(ordered_profiles))
        )
        self.real_profile_combo.addItems(ordered_profiles)
        self.real_gait_combo = QComboBox()
        self.real_gait_combo.addItem("Amble / Diagnostic", "amble")
        self.real_gait_combo.addItem("Trot / Load-Safe", "trot")
        tuning_layout.addWidget(QLabel("Profile"), 0, 0)
        tuning_layout.addWidget(self.real_profile_combo, 0, 1)
        tuning_layout.addWidget(QLabel("Profile gait"), 0, 2)
        tuning_layout.addWidget(self.real_gait_combo, 0, 3)

        self.real_cycle = self.make_tuning_spinbox(0.60, 6.00, 2.00, 0.05, 2, " s")
        self.real_stride_mm = self.make_tuning_spinbox(5.0, 75.0, 35.0, 1.0, 1, " mm")
        self.real_lateral_mm = self.make_tuning_spinbox(0.0, 30.0, 10.0, 1.0, 1, " mm")
        self.real_step_height_mm = self.make_tuning_spinbox(0.0, 45.0, 40.0, 1.0, 1, " mm")
        self.real_duty = self.make_tuning_spinbox(0.55, 0.90, 0.80, 0.01, 2, "")
        self.real_joint_velocity = self.make_tuning_spinbox(60.0, 120.0, 100.0, 5.0, 0, " deg/s")
        self.real_joint_acceleration = self.make_tuning_spinbox(60.0, 1200.0, 240.0, 20.0, 0, " deg/s²")
        self.real_smoothing = self.make_tuning_spinbox(0.0, 0.80, 0.15, 0.02, 2, "")
        self.real_touchdown_percent = self.make_tuning_spinbox(8.0, 35.0, 30.0, 1.0, 0, " %")
        self.real_stance_width_mm = self.make_tuning_spinbox(80.0, 130.0, 104.0, 1.0, 1, " mm")
        self.real_command_acceleration = self.make_tuning_spinbox(
            0.02, 0.40, 0.08, 0.01, 2, " m/s²"
        )
        self.real_velocity_filter_alpha = self.make_tuning_spinbox(
            0.05, 1.00, 0.30, 0.01, 2, ""
        )
        self.real_body_height_mm = self.make_tuning_spinbox(175.0, 220.0, 200.0, 1.0, 1, " mm")
        self.real_body_x_mm = self.make_tuning_spinbox(-25.0, 25.0, 0.0, 1.0, 1, " mm")
        self.real_body_y_mm = self.make_tuning_spinbox(-20.0, 20.0, 0.0, 1.0, 1, " mm")
        roll_bounds = NUMERIC_BOUNDS["body_roll_deg"]
        pitch_bounds = NUMERIC_BOUNDS["body_pitch_deg"]
        self.real_body_roll = self.make_tuning_spinbox(
            roll_bounds[0], roll_bounds[1], 0.0, 0.5, 1, " deg"
        )
        self.real_body_pitch = self.make_tuning_spinbox(
            pitch_bounds[0], pitch_bounds[1], 0.0, 0.5, 1, " deg"
        )
        self.real_body_yaw = self.make_tuning_spinbox(-10.0, 10.0, 0.0, 0.5, 1, " deg")
        tuning_fields = (
            ("Cycle duration", self.real_cycle),
            ("Forward stride", self.real_stride_mm),
            ("Lateral stride", self.real_lateral_mm),
            ("Swing clearance", self.real_step_height_mm),
            ("Duty factor", self.real_duty),
            ("Max joint velocity", self.real_joint_velocity),
            ("Max joint acceleration", self.real_joint_acceleration),
            ("Smoothing amount", self.real_smoothing),
            ("Touchdown softness", self.real_touchdown_percent),
            ("Stance half-width", self.real_stance_width_mm),
            ("Command slew rate", self.real_command_acceleration),
            ("Command low-pass", self.real_velocity_filter_alpha),
            ("Profile body height", self.real_body_height_mm),
            ("Profile body X", self.real_body_x_mm),
            ("Profile body Y", self.real_body_y_mm),
            ("Profile body roll", self.real_body_roll),
            ("Profile body pitch", self.real_body_pitch),
            ("Profile body yaw", self.real_body_yaw),
        )
        for index, (label_text, control) in enumerate(tuning_fields):
            row = 1 + index // 2
            column = (index % 2) * 2
            tuning_layout.addWidget(QLabel(label_text), row, column)
            tuning_layout.addWidget(control, row, column + 1)
        for column in (1, 3):
            tuning_layout.setColumnStretch(column, 1)

        tuning_buttons = QHBoxLayout()
        self.load_real_profile_button = QPushButton("LOAD PROFILE")
        self.load_real_profile_button.clicked.connect(self.load_selected_real_profile)
        self.reset_real_profile_button = QPushButton("RESET VALUES")
        self.reset_real_profile_button.clicked.connect(self.load_selected_real_profile)
        self.apply_real_profile_button = QPushButton("APPLY")
        self.apply_real_profile_button.clicked.connect(self.apply_real_tuning)
        self.save_real_profile_button = QPushButton("SAVE PROFILE")
        self.save_real_profile_button.clicked.connect(self.save_real_tuning_profile)
        for button in (
            self.load_real_profile_button,
            self.reset_real_profile_button,
            self.apply_real_profile_button,
            self.save_real_profile_button,
        ):
            tuning_buttons.addWidget(button)
        tuning_layout.addLayout(tuning_buttons, 9, 0, 1, 4)
        self.real_tuning_status = QLabel(
            "Load a profile, STOP and settle, then APPLY. Body pose controls above are part of the transaction."
        )
        self.real_tuning_status.setWordWrap(True)
        self.real_tuning_status.setObjectName("gaitDetail")
        tuning_layout.addWidget(self.real_tuning_status, 10, 0, 1, 4)
        tuning_right.addWidget(tuning_group)
        tuning_right.addStretch(1)

        self.build_gamepad_tab(gamepad_page)

        self.real_tuning_value_controls = [
            self.real_gait_combo,
            self.real_cycle,
            self.real_stride_mm,
            self.real_lateral_mm,
            self.real_step_height_mm,
            self.real_duty,
            self.real_joint_velocity,
            self.real_joint_acceleration,
            self.real_smoothing,
            self.real_touchdown_percent,
            self.real_stance_width_mm,
            self.real_command_acceleration,
            self.real_velocity_filter_alpha,
            self.real_body_height_mm,
            self.real_body_x_mm,
            self.real_body_y_mm,
            self.real_body_roll,
            self.real_body_pitch,
            self.real_body_yaw,
        ]
        for control in self.real_tuning_value_controls:
            if isinstance(control, QComboBox):
                control.currentIndexChanged.connect(self.mark_real_tuning_dirty)
            else:
                control.valueChanged.connect(self.mark_real_tuning_dirty)
        self.real_profile_combo.currentTextChanged.connect(
            self.refresh_real_profile_editability
        )
        self.refresh_real_profile_editability()

        emote_group = QGroupBox("Robot Emotes & Poses")
        emote_layout = QGridLayout(emote_group)
        emote_layout.setHorizontalSpacing(8)
        emote_layout.setVerticalSpacing(5)
        self.emote_repetitions = self.make_tuning_spinbox(
            1.0, 5.0, 1.0, 1.0, 0, " ×"
        )
        self.emote_speed = self.make_tuning_spinbox(
            0.5, 2.0, 1.0, 0.1, 1, " ×"
        )
        self.emote_amplitude = self.make_tuning_spinbox(
            0.5, 2.0, 2.0, 0.1, 1, " ×"
        )
        self.emote_depth = self.make_tuning_spinbox(
            0.5, 3.0, 3.0, 0.1, 1, " ×"
        )
        self.pushup_travel_mm = self.make_tuning_spinbox(
            PUSHUP_TRAVEL_MIN_MM,
            PUSHUP_TRAVEL_MAX_MM,
            PUSHUP_TRAVEL_DEFAULT_MM,
            1.0,
            0,
            " mm",
        )
        self.pushup_travel_mm.setToolTip(
            "Vertical body travel used only by PUSH-UPS. The controller "
            "still applies IK and joint safety limits."
        )
        for column, (caption, control) in enumerate(
            (
                ("Repetitions", self.emote_repetitions),
                ("Speed", self.emote_speed),
                ("Amplitude", self.emote_amplitude),
                ("Depth", self.emote_depth),
            )
        ):
            emote_layout.addWidget(QLabel(caption), 0, column)
            emote_layout.addWidget(control, 1, column)

        pushup_travel_label = QLabel("Push-up travel")
        pushup_travel_label.setToolTip(self.pushup_travel_mm.toolTip())
        emote_layout.addWidget(pushup_travel_label, 2, 0)
        emote_layout.addWidget(self.pushup_travel_mm, 2, 1)
        pushup_travel_hint = QLabel(
            "PUSH-UPS only (%.0f–%.0f mm); Depth remains for other emotes."
            % (PUSHUP_TRAVEL_MIN_MM, PUSHUP_TRAVEL_MAX_MM)
        )
        pushup_travel_hint.setObjectName("gaitDetail")
        pushup_travel_hint.setWordWrap(True)
        emote_layout.addWidget(pushup_travel_hint, 2, 2, 1, 2)

        emote_actions = (
            DISPLAYED_CARTESIAN_EMOTES[0],
            (EMOTE_POSE_ACTIONS[0][0], "action:%s" % EMOTE_POSE_ACTIONS[0][1]),
            (EMOTE_POSE_ACTIONS[1][0], "action:%s" % EMOTE_POSE_ACTIONS[1][1]),
        ) + DISPLAYED_CARTESIAN_EMOTES[1:]
        self.emote_start_buttons = []
        self.emote_buttons_by_name = {}
        self.emote_action_buttons_by_name = {}
        for index, (caption, command) in enumerate(emote_actions):
            button = QPushButton(caption)
            if command.startswith("action:"):
                action = command.partition(":")[2]
                button.clicked.connect(
                    lambda _checked=False, name=action: self.request_emote_pose_action(
                        name
                    )
                )
                button.setEnabled(False)
                self.emote_action_buttons_by_name[action] = button
            else:
                button.clicked.connect(
                    lambda _checked=False, name=command: self.start_emote(name)
                )
                button.setEnabled(False)
                self.emote_buttons_by_name[command] = button
            emote_layout.addWidget(button, 3 + index // 4, index % 4)
            self.emote_start_buttons.append(button)

        self.stop_emote_button = QPushButton("STOP EMOTE")
        self.stop_emote_button.setObjectName("stop")
        self.stop_emote_button.clicked.connect(self.stop_emote)
        self.stop_emote_button.setEnabled(False)
        emote_layout.addWidget(self.stop_emote_button, 6, 0, 1, 4)
        self.emote_status = QLabel(
            "Emotes run through Cartesian targets, IK, and the active joint safety limiter."
        )
        self.emote_status.setWordWrap(True)
        self.emote_status.setObjectName("gaitDetail")
        emote_layout.addWidget(self.emote_status, 7, 0, 1, 4)
        emotes_face_layout.addWidget(emote_group, 0, 0, alignment=Qt.AlignTop)

        face_group = QGroupBox("Face LEDs")
        face_layout = QGridLayout(face_group)
        face_layout.setHorizontalSpacing(8)
        face_layout.setVerticalSpacing(6)

        self.face_enable = QCheckBox("Enabled")
        self.face_auto = QCheckBox("Automatic during emotes")
        self.face_auto.setToolTip(
            "Select configured expressions automatically during emotes."
        )
        self.face_lock = QCheckBox("Lock current face")
        self.face_lock.setToolTip(
            "Keep the manual face during ordinary motion and emotes; safety "
            "alerts can still override it."
        )
        face_mode_row = QHBoxLayout()
        face_mode_row.setSpacing(16)
        face_mode_row.addWidget(self.face_enable)
        face_mode_row.addWidget(self.face_auto)
        face_mode_row.addWidget(self.face_lock)
        face_mode_row.addStretch(1)
        face_layout.addLayout(face_mode_row, 0, 0, 1, 4)

        self.face_expression_combo = QComboBox()
        if self.face_catalog is not None:
            self.face_expression_combo.addItems(list(self.face_catalog.presets))
        self.face_effect_combo = QComboBox()
        self.face_effect_combo.addItems(SUPPORTED_EFFECTS)
        face_layout.addWidget(QLabel("Expression"), 1, 0)
        face_layout.addWidget(self.face_expression_combo, 1, 1)
        face_layout.addWidget(QLabel("Effect"), 1, 2)
        face_layout.addWidget(self.face_effect_combo, 1, 3)

        self.face_color_button = QPushButton("CHOOSE COLOR")
        self.face_color_button.clicked.connect(self.choose_face_color)
        self.face_red = QSpinBox()
        self.face_green = QSpinBox()
        self.face_blue = QSpinBox()
        for channel in (self.face_red, self.face_green, self.face_blue):
            channel.setRange(0, 255)
            channel.valueChanged.connect(self.update_face_preview)
        face_layout.addWidget(self.face_color_button, 2, 0)
        for column, (caption, channel) in enumerate(
            (("R", self.face_red), ("G", self.face_green), ("B", self.face_blue)),
            start=1,
        ):
            channel_row = QHBoxLayout()
            channel_row.setSpacing(3)
            channel_row.addWidget(QLabel(caption))
            channel_row.addWidget(channel)
            face_layout.addLayout(channel_row, 2, column)

        self.face_preview = QLabel("LIVE PREVIEW")
        self.face_preview.setAlignment(Qt.AlignCenter)
        self.face_preview.setMinimumHeight(34)
        self.face_preview.setObjectName("facePreview")
        face_layout.addWidget(self.face_preview, 3, 0, 1, 4)

        self.face_brightness = QSlider(Qt.Horizontal)
        self.face_brightness.setRange(0, 255)
        self.face_brightness.setSingleStep(1)
        self.face_brightness_value = QLabel("80")
        self.face_brightness.valueChanged.connect(
            lambda value: self.face_brightness_value.setText(str(value))
        )
        face_layout.addWidget(QLabel("Brightness"), 4, 0)
        face_layout.addWidget(self.face_brightness, 4, 1, 1, 2)
        face_layout.addWidget(self.face_brightness_value, 4, 3)

        self.face_speed = QSlider(Qt.Horizontal)
        self.face_speed.setRange(10, 60000)
        self.face_speed.setSingleStep(10)
        self.face_speed.setPageStep(100)
        self.face_speed_value = QLabel("1200 ms")
        self.face_speed.valueChanged.connect(
            lambda value: self.face_speed_value.setText("%d ms" % value)
        )
        face_layout.addWidget(QLabel("Animation speed"), 5, 0)
        face_layout.addWidget(self.face_speed, 5, 1, 1, 2)
        face_layout.addWidget(self.face_speed_value, 5, 3)

        face_buttons = QHBoxLayout()
        self.face_apply_button = QPushButton("APPLY")
        self.face_apply_button.clicked.connect(self.apply_face_settings)
        self.face_off_button = QPushButton("OFF")
        self.face_off_button.setObjectName("stop")
        self.face_off_button.clicked.connect(self.stop_face_leds)
        self.face_restore_button = QPushButton("RESTORE DEFAULT")
        self.face_restore_button.clicked.connect(self.restore_default_face)
        self.face_test_button = QPushButton("TEST LEDS")
        self.face_test_button.clicked.connect(self.start_face_test)
        for button in (
            self.face_apply_button,
            self.face_off_button,
            self.face_restore_button,
            self.face_test_button,
        ):
            face_buttons.addWidget(button)
        face_layout.addLayout(face_buttons, 6, 0, 1, 4)

        preset_caption = QLabel("Expression presets")
        preset_caption.setObjectName("statusCaption")
        face_layout.addWidget(preset_caption, 7, 0, 1, 4)
        self.face_preset_buttons = []
        if self.face_catalog is not None:
            for index, expression in enumerate(self.face_catalog.presets):
                button = QPushButton(expression.replace("_", " ").upper())
                button.clicked.connect(
                    lambda _checked=False, name=expression: (
                        self.select_face_preset(name, publish=True)
                    )
                )
                face_layout.addWidget(button, 8 + index // 4, index % 4)
                self.face_preset_buttons.append(button)

        preset_rows = (
            (len(self.face_preset_buttons) + 3) // 4
            if self.face_preset_buttons
            else 1
        )
        self.face_status = QLabel("Waiting for face LED status.")
        self.face_status.setWordWrap(True)
        self.face_status.setObjectName("gaitDetail")
        face_layout.addWidget(self.face_status, 8 + preset_rows, 0, 1, 4)
        emotes_face_layout.addWidget(face_group, 0, 1, alignment=Qt.AlignTop)

        self.face_expression_combo.currentTextChanged.connect(
            self.face_expression_selected
        )
        self.face_enable.toggled.connect(self.face_enabled_changed)
        self.face_auto.toggled.connect(self.face_mode_changed)
        self.face_lock.toggled.connect(self.face_mode_changed)
        if self.face_settings is not None:
            self.set_face_controls(self.face_settings)
        else:
            face_group.setEnabled(False)
            self.face_status.setText(
                "Face configuration unavailable: %s" % self.face_config_error
            )
            self.face_status.setStyleSheet("color: #fca5a5;")

        diagnostic_group = QGroupBox("Hardware Gait Diagnostic")
        diagnostic_layout = QGridLayout(diagnostic_group)
        self.diagnostic_leg = QComboBox()
        for leg in LEG_ORDER:
            self.diagnostic_leg.addItem(leg.replace("_", " ").title(), leg)
        self.diagnostic_duration = self.make_tuning_spinbox(
            6.0, 20.0, 8.0, 1.0, 1, " s"
        )
        diagnostic_layout.addWidget(QLabel("Selected leg"), 0, 0)
        diagnostic_layout.addWidget(self.diagnostic_leg, 0, 1)
        diagnostic_layout.addWidget(QLabel("Duration"), 0, 2)
        diagnostic_layout.addWidget(self.diagnostic_duration, 0, 3)
        diagnostic_buttons = (
            ("A — STAND", lambda: self.send_action("stand")),
            ("B — SLOW SQUAT", lambda: self.start_physical_diagnostic("slow-squat")),
            ("C — SINGLE LEG LIFT", lambda: self.start_physical_diagnostic("single-leg-lift")),
            ("D — STEP ONE LEG", lambda: self.start_physical_diagnostic("single-leg-step")),
            ("E — SELECT AMBLE", lambda: self.select_diagnostic_gait("amble")),
            ("F — SELECT TROT", lambda: self.select_diagnostic_gait("trot")),
        )
        self.diagnostic_buttons = []
        for index, (label, callback) in enumerate(diagnostic_buttons):
            button = QPushButton(label)
            button.clicked.connect(callback)
            diagnostic_layout.addWidget(button, 1 + index // 2, (index % 2) * 2, 1, 2)
            self.diagnostic_buttons.append(button)
        self.run_gait_button = QPushButton("G — SELECT RUN")
        self.run_gait_button.clicked.connect(
            lambda: self.select_diagnostic_gait("run")
        )
        self.run_gait_button.setToolTip(
            "RUN is a fast trot: 1.30 Hz at duty 0.50, the fastest the servo "
            "budget accepts. Entry gates before driving it: zero CRC failures "
            "and sequence gaps over 60 s, clearance >= 8% of module span on "
            "all four feet, roll 1x below 2x. STOP decelerates through TROT "
            "rather than halting mid-cycle."
        )
        diagnostic_layout.addWidget(self.run_gait_button, 4, 0, 1, 4)
        self.stop_diagnostic_button = QPushButton("STOP DIAGNOSTIC")
        self.stop_diagnostic_button.setObjectName("stop")
        self.stop_diagnostic_button.clicked.connect(self.stop_physical_diagnostic)
        diagnostic_layout.addWidget(self.stop_diagnostic_button, 5, 0, 1, 4)
        self.diagnostic_status = QLabel(
            "A-D are finite leased Cartesian tests. E-F select a gait; use the joystick only after the selection is confirmed."
        )
        self.diagnostic_status.setWordWrap(True)
        self.diagnostic_status.setObjectName("gaitDetail")
        diagnostic_layout.addWidget(self.diagnostic_status, 6, 0, 1, 4)
        self.gait_diagnostics = QLabel("Gait diagnostics will appear here.")
        self.gait_diagnostics.setWordWrap(True)
        self.gait_diagnostics.setObjectName("gaitDetail")
        diagnostic_layout.addWidget(self.gait_diagnostics, 7, 0, 1, 4)
        # Live command path: commanded -> post-clamp -> resolved, so it is
        # visible which stage zeroed or shrank a command.
        self.command_path_diagnostics = QLabel(
            "Command path will appear here."
        )
        self.command_path_diagnostics.setWordWrap(True)
        self.command_path_diagnostics.setObjectName("gaitDetail")
        self.command_path_diagnostics.setStyleSheet(
            "font-family: monospace; color: #cbd5e1;"
        )
        diagnostic_layout.addWidget(
            self.command_path_diagnostics, 8, 0, 1, 4
        )
        # Loud gate banner: a clamp that silently discards commanded motion
        # is exactly what hid the front-right knee guard for so long.
        self.gate_banner = QLabel("")
        self.gate_banner.setWordWrap(True)
        self.gate_banner.setVisible(False)
        self.gate_banner.setStyleSheet(
            "background: #7f1d1d; color: #fee2e2; font-weight: bold;"
            " padding: 6px; border-radius: 4px;"
        )
        diagnostic_layout.addWidget(self.gate_banner, 9, 0, 1, 4)
        diagnostics_layout.addWidget(
            diagnostic_group,
            0,
            0,
            alignment=Qt.AlignTop,
        )

        telemetry_group = QGroupBox("Commanded Telemetry — No Servo Feedback")
        telemetry_layout = QVBoxLayout(telemetry_group)
        self.resolved_gait_label = QLabel("Gait parameters appear on selection.")
        self.resolved_gait_label.setWordWrap(True)
        self.resolved_gait_label.setObjectName("gaitDetail")
        self.resolved_gait_label.setTextInteractionFlags(Qt.TextSelectableByMouse)
        telemetry_layout.addWidget(self.resolved_gait_label)
        self.commanded_telemetry = QLabel("Waiting for /volt/status.")
        self.commanded_telemetry.setWordWrap(True)
        self.commanded_telemetry.setTextInteractionFlags(Qt.TextSelectableByMouse)
        self.commanded_telemetry.setObjectName("gaitDetail")
        telemetry_layout.addWidget(self.commanded_telemetry)
        diagnostics_layout.addWidget(
            telemetry_group,
            0,
            1,
            alignment=Qt.AlignTop,
        )

        link_group = QGroupBox("Firmware Link Health")
        link_layout = QVBoxLayout(link_group)
        self.firmware_link_label = QLabel(
            "Waiting for firmware STATUS (polled every 5 s while connected)."
        )
        self.firmware_link_label.setWordWrap(True)
        self.firmware_link_label.setTextInteractionFlags(
            Qt.TextSelectableByMouse
        )
        self.firmware_link_label.setObjectName("gaitDetail")
        link_layout.addWidget(self.firmware_link_label)
        diagnostics_layout.addWidget(
            link_group,
            1,
            1,
            alignment=Qt.AlignTop,
        )
        emotes_face_layout.setRowStretch(1, 1)
        diagnostics_layout.setRowStretch(2, 1)
        right.addStretch(1)
        workspace.addLayout(right, 4)

        self.arm_mutation_controls = [
            self.stand_button,
            self.sit_button,
            self.enable_motion_button,
            self.step_button,
            self.drive_mode,
            self.speed_slider,
            self.yaw_slider,
            self.body_height,
            self.body_x,
            self.body_y,
            self.roll,
            self.pitch,
            self.yaw,
            self.reset_pose_button,
            self.real_profile_combo,
            self.load_real_profile_button,
            self.reset_real_profile_button,
            self.apply_real_profile_button,
            self.save_real_profile_button,
            self.diagnostic_leg,
            self.diagnostic_duration,
            self.joystick,
            self.emote_repetitions,
            self.emote_speed,
            self.emote_amplitude,
            self.emote_depth,
            self.pushup_travel_mm,
        ]
        self.arm_mutation_controls.extend(self.real_tuning_value_controls)
        self.arm_mutation_controls.extend(self.diagnostic_buttons)
        self.arm_mutation_controls.extend(self.emote_start_buttons)
        self.arm_mutation_controls.extend(self.gait_button_by_name.values())

    # ----------------------------------------------------------------- #
    # GAMEPAD tab: map any button or D-pad direction to any action        #
    # ----------------------------------------------------------------- #

    class _NoWheelComboBox(QComboBox):
        """A combo that ignores the wheel unless it has focus.

        Inside a QScrollArea a plain QComboBox swallows wheel events, so
        scrolling the binding grid with the pointer over a row silently
        rebinds that control -- possibly away from STOP, on an armed robot.
        """

        def __init__(self, parent=None):
            super().__init__(parent)
            self.setFocusPolicy(Qt.StrongFocus)

        def wheelEvent(self, event):
            if self.hasFocus():
                super().wheelEvent(event)
            else:
                event.ignore()

    def build_gamepad_tab(self, page):
        layout = QVBoxLayout(page)
        layout.setContentsMargins(0, 8, 0, 0)
        layout.setSpacing(10)

        intro = QLabel(
            "Click a control on the pad to bind it. Press it physically and "
            "it lights up green, so you can identify a button without "
            "knowing its number. STOP bindings are outlined in red. Changes "
            "apply immediately; SAVE keeps them for next launch."
        )
        intro.setWordWrap(True)
        intro.setObjectName("gaitDetail")
        layout.addWidget(intro)

        self.gamepad_diagram = GamepadDiagram()
        self.gamepad_diagram.controlClicked.connect(self.select_gamepad_control)
        layout.addWidget(self.gamepad_diagram, 1)

        # Editor for whatever is selected on the diagram. The full grid below
        # still lists every input, including the ones an exotic pad reports
        # that the drawing has no place for.
        picker = QHBoxLayout()
        self.gamepad_selected_label = QLabel("Select a control above")
        self.gamepad_selected_label.setStyleSheet(
            "font-weight: bold; color: #e2e8f0;"
        )
        self.gamepad_selected_combo = self._NoWheelComboBox()
        for action, action_caption, group_name in BINDABLE_ACTIONS:
            self.gamepad_selected_combo.addItem(
                action_caption if group_name in ("None", "Motion")
                else "%s - %s" % (group_name, action_caption),
                action,
            )
        self.gamepad_selected_combo.setEnabled(False)
        self.gamepad_selected_combo.currentIndexChanged.connect(
            self.selected_gamepad_binding_changed
        )
        picker.addWidget(self.gamepad_selected_label)
        picker.addWidget(self.gamepad_selected_combo, 1)
        layout.addLayout(picker)

        self.gamepad_binding_warning = QLabel("")
        self.gamepad_binding_warning.setWordWrap(True)
        self.gamepad_binding_warning.setVisible(False)
        self.gamepad_binding_warning.setStyleSheet(
            "background: #7f1d1d; color: #fee2e2; font-weight: bold;"
            " padding: 6px; border-radius: 4px;"
        )
        layout.addWidget(self.gamepad_binding_warning)

        group = QGroupBox("All inputs (including any the diagram cannot show)")
        grid = QGridLayout(group)
        grid.setHorizontalSpacing(10)
        grid.setVerticalSpacing(4)
        for column, title in enumerate(("Control", "Action", "", "Control", "Action", "")):
            label = QLabel(title)
            label.setObjectName("poseCaption")
            grid.addWidget(label, 0, column)

        self.gamepad_binding_combos = {}
        self.gamepad_binding_labels = {}
        names = all_input_names()
        half = (len(names) + 1) // 2
        for index, name in enumerate(names):
            row = 1 + (index % half)
            base = 0 if index < half else 3
            caption = QLabel(input_caption(name))
            caption.setObjectName("gaitDetail")
            combo = self._NoWheelComboBox()
            for action, action_caption, group_name in BINDABLE_ACTIONS:
                combo.addItem(
                    action_caption if group_name in ("None", "Motion")
                    else "%s — %s" % (group_name, action_caption),
                    action,
                )
            combo.currentIndexChanged.connect(
                lambda _index, key=name: self.gamepad_binding_changed(key)
            )
            live = QLabel("")
            live.setFixedWidth(16)
            grid.addWidget(caption, row, base)
            grid.addWidget(combo, row, base + 1)
            grid.addWidget(live, row, base + 2)
            self.gamepad_binding_combos[name] = combo
            self.gamepad_binding_labels[name] = live
        layout.addWidget(group)

        axis_group = QGroupBox("Sticks and triggers (axes)")
        axis_grid = QGridLayout(axis_group)
        axis_grid.setHorizontalSpacing(10)
        axis_grid.setVerticalSpacing(4)
        axis_hint = QLabel(
            "A stick drives a signal rather than firing an action. Invert "
            "flips the sign: most pads report stick-up as negative, which is "
            "what the old fixed mapping was quietly compensating for. Each "
            "signal takes exactly one axis."
        )
        axis_hint.setWordWrap(True)
        axis_hint.setObjectName("gaitDetail")
        axis_grid.addWidget(axis_hint, 0, 0, 1, 4)
        for column, title in enumerate(("Axis", "Drives", "", "Live")):
            caption = QLabel(title)
            caption.setObjectName("poseCaption")
            axis_grid.addWidget(caption, 1, column)

        self.gamepad_axis_combos = {}
        self.gamepad_axis_inverts = {}
        self.gamepad_axis_meters = {}
        for index, name in enumerate(all_axis_names()):
            row = 2 + index
            caption = QLabel(axis_caption(name))
            caption.setObjectName("gaitDetail")
            combo = self._NoWheelComboBox()
            for function, function_caption in AXIS_FUNCTIONS:
                combo.addItem(function_caption, function)
            combo.currentIndexChanged.connect(
                lambda _i, key=name: self.gamepad_axis_changed(key)
            )
            invert = QCheckBox("invert")
            invert.stateChanged.connect(
                lambda _s, key=name: self.gamepad_axis_changed(key)
            )
            meter = QLabel("0.00")
            meter.setObjectName("gaitDetail")
            meter.setFixedWidth(52)
            axis_grid.addWidget(caption, row, 0)
            axis_grid.addWidget(combo, row, 1)
            axis_grid.addWidget(invert, row, 2)
            axis_grid.addWidget(meter, row, 3)
            self.gamepad_axis_combos[name] = combo
            self.gamepad_axis_inverts[name] = invert
            self.gamepad_axis_meters[name] = meter
        axis_grid.setColumnStretch(1, 1)
        layout.addWidget(axis_group)

        buttons = QHBoxLayout()
        self.gamepad_save_button = QPushButton("SAVE BINDINGS")
        self.gamepad_save_button.clicked.connect(self.save_gamepad_bindings)
        self.gamepad_reload_button = QPushButton("RELOAD SAVED")
        self.gamepad_reload_button.clicked.connect(self.reload_gamepad_bindings)
        self.gamepad_defaults_button = QPushButton("RESTORE DEFAULTS")
        self.gamepad_defaults_button.clicked.connect(
            self.restore_default_gamepad_bindings
        )
        for button in (
            self.gamepad_save_button,
            self.gamepad_reload_button,
            self.gamepad_defaults_button,
        ):
            buttons.addWidget(button)
        buttons.addStretch(1)
        layout.addLayout(buttons)

        self.gamepad_binding_status = QLabel("")
        self.gamepad_binding_status.setWordWrap(True)
        self.gamepad_binding_status.setObjectName("gaitDetail")
        layout.addWidget(self.gamepad_binding_status)
        layout.addStretch(1)

        self.gamepad_selected_input = ""
        self.refresh_gamepad_axis_controls()
        self.refresh_gamepad_binding_controls()
        if self.gamepad_binding_load_error:
            self.set_gamepad_binding_status(
                self.gamepad_binding_load_error, "#fca5a5"
            )
        else:
            self.set_gamepad_binding_status(
                "Loaded from %s" % bindings_path(), "#94a3b8"
            )

    def select_gamepad_control(self, name):
        """Point the single big editor at whatever was clicked on the pad."""
        self.gamepad_selected_input = name
        self.gamepad_diagram.set_selected(name)
        combo = self.gamepad_selected_combo
        position = combo.findData(resolve(self.gamepad_bindings, name))
        blocked = combo.blockSignals(True)
        combo.setCurrentIndex(max(0, position))
        combo.blockSignals(blocked)
        combo.setEnabled(True)
        self.gamepad_selected_label.setText("%s  =" % input_caption(name))

    def selected_gamepad_binding_changed(self, _index):
        name = getattr(self, "gamepad_selected_input", "")
        if not name:
            return
        action = self.gamepad_selected_combo.currentData() or ""
        self.gamepad_bindings[name] = action
        row = self.gamepad_binding_combos.get(name)
        if row is not None:
            position = row.findData(action)
            blocked = row.blockSignals(True)
            row.setCurrentIndex(max(0, position))
            row.blockSignals(blocked)
        self.gamepad_diagram.set_bindings(self.gamepad_bindings)
        self.refresh_gamepad_binding_warning()
        self.set_gamepad_binding_status(
            "%s -> %s (unsaved)"
            % (input_caption(name), ACTION_CAPTIONS.get(action, "unbound")),
            "#7dd3fc",
        )

    def gamepad_axis_changed(self, name):
        """Apply an axis edit, refusing a set where two axes fight."""
        combos = getattr(self, "gamepad_axis_combos", None)
        if not combos or name not in combos:
            return
        candidate = {
            key: {
                "function": combos[key].currentData() or "",
                "invert": self.gamepad_axis_inverts[key].isChecked(),
            }
            for key in combos
        }
        try:
            self.gamepad_axis_bindings = validate_axis_bindings(candidate)
        except BindingError as exc:
            # Put the controls back to the last good set rather than leaving
            # the console holding a mapping it will not act on.
            self.refresh_gamepad_axis_controls()
            self.set_gamepad_binding_status("Not applied: %s" % exc, "#fca5a5")
            return
        # A stick that just changed meaning must not inherit a held
        # deflection: require a fresh neutral before it can drive again.
        self.latch_motion_until_neutral()
        self.gamepad_diagram.set_axes(
            self.gamepad_axis_values, self.gamepad_axis_bindings
        )
        function = self.gamepad_axis_bindings[name]["function"]
        self.set_gamepad_binding_status(
            "%s -> %s%s (unsaved; centre the sticks to resume)"
            % (
                axis_caption(name),
                AXIS_FUNCTION_CAPTIONS.get(function, "unused"),
                " inverted" if self.gamepad_axis_bindings[name]["invert"] else "",
            ),
            "#7dd3fc",
        )

    def refresh_gamepad_axis_controls(self):
        combos = getattr(self, "gamepad_axis_combos", None)
        if not combos:
            return
        for name, combo in combos.items():
            entry = self.gamepad_axis_bindings.get(name) or {}
            position = combo.findData(entry.get("function", ""))
            blocked = combo.blockSignals(True)
            combo.setCurrentIndex(max(0, position))
            combo.blockSignals(blocked)
            invert = self.gamepad_axis_inverts[name]
            blocked = invert.blockSignals(True)
            invert.setChecked(bool(entry.get("invert", False)))
            invert.blockSignals(blocked)
        diagram = getattr(self, "gamepad_diagram", None)
        if diagram is not None:
            diagram.set_axes(
                self.gamepad_axis_values, self.gamepad_axis_bindings
            )

    def set_gamepad_binding_status(self, text, color="#94a3b8"):
        self.gamepad_binding_status.setText(str(text))
        self.gamepad_binding_status.setStyleSheet("color: %s;" % color)

    def refresh_gamepad_binding_controls(self):
        """Push the active bindings into the combo boxes without recursing."""
        for name, combo in self.gamepad_binding_combos.items():
            action = resolve(self.gamepad_bindings, name)
            position = combo.findData(action)
            if position < 0:
                position = combo.findData("")
            blocked = combo.blockSignals(True)
            combo.setCurrentIndex(max(0, position))
            combo.blockSignals(blocked)
        diagram = getattr(self, "gamepad_diagram", None)
        if diagram is not None:
            diagram.set_bindings(self.gamepad_bindings)
        selected = getattr(self, "gamepad_selected_input", "")
        if selected:
            self.select_gamepad_control(selected)
        self.refresh_gamepad_binding_warning()

    def refresh_gamepad_binding_warning(self):
        """STOP must stay reachable from the pad; say so loudly if it is not."""
        # "Bound to STOP" is not enough: the grid offers Button 0..19 whatever
        # is plugged in, so STOP on Button 14 of an 11-button pad is a STOP no
        # physical control can send.
        count = None
        if self.gamepad is not None:
            try:
                count = self.gamepad.get_numbuttons()
            except Exception:
                count = None
        has_stop = bool(reachable_stop_inputs(self.gamepad_bindings, count))
        self.gamepad_binding_warning.setVisible(not has_stop)
        if not has_stop:
            self.gamepad_binding_warning.setText(
                "NO CONTROL ON THIS PAD CAN SEND STOP. The guided ARM "
                "sequence accepts only STOP from the gamepad, so right now "
                "the pad has no emergency action. Bind STOP to a control the "
                "connected controller actually has, then arm."
            )
        # The banner sits on one tab, and the operator will not be looking at
        # it. Bindings apply the moment they are changed, so the loss of STOP
        # has to be visible from wherever they are: mark the tab label, which
        # is always on screen.
        index = getattr(self, "gamepad_tab_index", None)
        if index is not None:
            self.main_tabs.setTabText(
                index, "GAMEPAD" if has_stop else "GAMEPAD  ⚠ NO STOP"
            )

    def gamepad_binding_changed(self, name):
        combo = self.gamepad_binding_combos.get(name)
        if combo is None:
            return
        self.gamepad_bindings[name] = combo.currentData() or ""
        diagram = getattr(self, "gamepad_diagram", None)
        if diagram is not None:
            diagram.set_bindings(self.gamepad_bindings)
        self.refresh_gamepad_binding_warning()
        action = self.gamepad_bindings[name]
        self.set_gamepad_binding_status(
            "%s → %s (unsaved)"
            % (input_caption(name), ACTION_CAPTIONS.get(action, "unbound")),
            "#7dd3fc",
        )

    def save_gamepad_bindings(self):
        try:
            target = save_bindings(
                self.gamepad_bindings, axis_bindings=self.gamepad_axis_bindings
            )
        except BindingError as exc:
            self.set_gamepad_binding_status("Not saved: %s" % exc, "#fca5a5")
            return
        except OSError as exc:
            # An unwritable config directory used to let PermissionError
            # escape the slot: a traceback on stderr the operator never sees,
            # and a console that quietly did not save. Same handling as the
            # face and tuning-profile saves.
            self.set_gamepad_binding_status(
                "Not saved: %s" % exc, "#fca5a5"
            )
            return
        self.set_gamepad_binding_status("Saved to %s" % target, "#86efac")

    def reload_gamepad_bindings(self):
        self.gamepad_bindings, error = load_bindings()
        self.gamepad_axis_bindings, axis_error = load_axis_bindings()
        error = error or axis_error
        self.gamepad_binding_load_error = error
        self.refresh_gamepad_axis_controls()
        self.refresh_gamepad_binding_controls()
        self.set_gamepad_binding_status(
            error or "Reloaded from %s" % bindings_path(),
            "#fca5a5" if error else "#86efac",
        )

    def restore_default_gamepad_bindings(self):
        self.gamepad_bindings = dict(DEFAULT_BINDINGS)
        self.gamepad_axis_bindings = {
            key: dict(value) for key, value in DEFAULT_AXIS_BINDINGS.items()
        }
        self.refresh_gamepad_axis_controls()
        self.refresh_gamepad_binding_controls()
        self.set_gamepad_binding_status(
            "Defaults restored (unsaved).", "#7dd3fc"
        )

    def refresh_gamepad_binding_indicators(self):
        """Light the row for whatever is physically held right now."""
        labels = getattr(self, "gamepad_binding_labels", None)
        if not labels:
            return
        pressed = set()
        for name, label in labels.items():
            # poll_gamepad keys buttons by their integer index and the D-pad
            # directions by name, so the lookup differs per input kind.
            if name.startswith("button_"):
                try:
                    key = int(name.split("_")[1])
                except (ValueError, IndexError):
                    continue
            else:
                key = name
            held = bool(self.gamepad_buttons.get(key, False))
            label.setText("●" if held else "")
            label.setStyleSheet("color: #86efac;" if held else "")
            if held:
                pressed.add(name)
        # The diagram is the primary view; the row dots are the
        # fallback list. Both follow the same physical state.
        diagram = getattr(self, "gamepad_diagram", None)
        if diagram is not None:
            diagram.set_pressed(pressed)
            diagram.set_axes(
                self.gamepad_axis_values, self.gamepad_axis_bindings
            )
        meters = getattr(self, "gamepad_axis_meters", None)
        if meters:
            for index, name in enumerate(all_axis_names()):
                meter = meters.get(name)
                if meter is None:
                    continue
                value = (
                    self.gamepad_axis_values[index]
                    if index < len(self.gamepad_axis_values) else 0.0
                )
                meter.setText("%+.2f" % value)
                meter.setStyleSheet(
                    "color: #86efac;" if abs(value) > 0.05 else "color: #64748b;"
                )

    def make_spinbox(self, minimum, maximum, value, step, decimals):
        box = QDoubleSpinBox()
        box.setRange(minimum, maximum)
        box.setValue(value)
        box.setSingleStep(step)
        box.setDecimals(decimals)
        return box

    def make_tuning_spinbox(
        self,
        minimum,
        maximum,
        value,
        step,
        decimals,
        suffix,
    ):
        box = self.make_spinbox(minimum, maximum, value, step, decimals)
        box.setSuffix(suffix)
        box.setSizePolicy(QSizePolicy.Expanding, QSizePolicy.Fixed)
        return box

    def set_face_controls(self, settings):
        if self.face_catalog is None:
            return
        settings = validate_face_settings(settings, self.face_catalog)
        controls = (
            self.face_enable,
            self.face_auto,
            self.face_lock,
            self.face_expression_combo,
            self.face_effect_combo,
            self.face_red,
            self.face_green,
            self.face_blue,
            self.face_brightness,
            self.face_speed,
        )
        previous = [control.blockSignals(True) for control in controls]
        try:
            self.face_enable.setChecked(settings.enabled)
            self.face_auto.setChecked(settings.automatic)
            self.face_lock.setChecked(settings.locked)
            self.face_expression_combo.setCurrentText(settings.expression)
            self.face_effect_combo.setCurrentText(settings.effect)
            self.face_red.setValue(settings.color[0])
            self.face_green.setValue(settings.color[1])
            self.face_blue.setValue(settings.color[2])
            self.face_brightness.setValue(settings.brightness)
            self.face_speed.setValue(settings.speed_ms)
        finally:
            for control, blocked in zip(controls, previous):
                control.blockSignals(blocked)
        self.face_brightness_value.setText(str(settings.brightness))
        self.face_speed_value.setText("%d ms" % settings.speed_ms)
        self.update_face_preview()

    def current_face_settings(self):
        if self.face_catalog is None:
            raise FaceConfigError("face catalog is unavailable")
        expression = self.face_expression_combo.currentText()
        color = (
            self.face_red.value(),
            self.face_green.value(),
            self.face_blue.value(),
        )
        preset = self.face_catalog.presets.get(expression)
        alternate_color = (
            preset.alternate_color
            if preset is not None and preset.alternate_color is not None
            else color
        )
        return validate_face_settings(
            {
                "enabled": self.face_enable.isChecked(),
                "automatic": self.face_auto.isChecked(),
                "locked": self.face_lock.isChecked(),
                "expression": expression,
                "color": color,
                "alternate_color": alternate_color,
                "brightness": self.face_brightness.value(),
                "effect": self.face_effect_combo.currentText(),
                "speed_ms": self.face_speed.value(),
            },
            self.face_catalog,
        )

    def persist_face_settings(self):
        if self.face_catalog is None or self.face_settings is None:
            return False
        try:
            save_face_settings(self.face_settings, self.face_catalog)
            return True
        except (OSError, FaceConfigError, ValueError) as exc:
            self.face_status.setText("Face settings were not saved: %s" % exc)
            self.face_status.setStyleSheet("color: #fca5a5;")
            return False

    def publish_face_request(self, settings):
        """Remember the effective snapshot so reconnect restores it exactly."""
        if self.face_catalog is None:
            return False
        settings = validate_face_settings(settings, self.face_catalog)
        self.face_last_requested_settings = settings
        return self.ros_node.publish_face_settings(settings)

    def update_face_preview(self, *_args):
        if not hasattr(self, "face_preview"):
            return
        red = self.face_red.value()
        green = self.face_green.value()
        blue = self.face_blue.value()
        luminance = (299 * red + 587 * green + 114 * blue) // 1000
        foreground = "#07111e" if luminance >= 135 else "#f8fafc"
        self.face_preview.setText("RGB %d, %d, %d" % (red, green, blue))
        self.face_preview.setStyleSheet(
            "background: rgb(%d, %d, %d); color: %s; border: 1px solid "
            "#64748b; border-radius: 6px; font-weight: 700;"
            % (red, green, blue, foreground)
        )

    def choose_face_color(self):
        selected = QColorDialog.getColor(
            QColor(
                self.face_red.value(),
                self.face_green.value(),
                self.face_blue.value(),
            ),
            self,
            "Choose face LED color",
        )
        if selected.isValid():
            self.face_red.setValue(selected.red())
            self.face_green.setValue(selected.green())
            self.face_blue.setValue(selected.blue())

    def face_expression_selected(self, expression):
        if self.face_catalog is None or expression not in self.face_catalog.presets:
            return
        try:
            current = self.current_face_settings()
            selected = settings_for_preset(
                self.face_catalog,
                expression,
                current,
            )
        except FaceConfigError:
            return
        self.set_face_controls(selected)

    def select_face_preset(self, expression, publish=False):
        if self.face_catalog is None or expression not in self.face_catalog.presets:
            return False
        self.face_expression_combo.setCurrentText(expression)
        if publish:
            self.apply_face_settings()
        return True

    def apply_face_settings(self):
        if self.face_catalog is None:
            return False
        try:
            settings = self.current_face_settings()
        except FaceConfigError as exc:
            self.face_status.setText("Invalid face settings: %s" % exc)
            self.face_status.setStyleSheet("color: #fca5a5;")
            return False
        self.face_settings = settings
        self.face_automation.set_settings(settings)
        self.persist_face_settings()
        published = self.publish_face_request(settings)
        self.face_status.setText(
            "%s requested; waiting for bridge synchronization."
            % settings.expression.replace("_", " ").title()
            if published
            else "Could not publish face LED settings."
        )
        self.face_status.setStyleSheet(
            "color: #7dd3fc;" if published else "color: #fca5a5;"
        )
        if (
            published
            and settings.enabled
            and self.last_face_motion_status
        ):
            self.apply_automatic_face(self.last_face_motion_status)
        return published

    def face_enabled_changed(self, enabled):
        if self.face_catalog is None:
            return
        try:
            self.face_settings = self.current_face_settings()
        except FaceConfigError:
            return
        self.face_automation.set_settings(self.face_settings)
        self.persist_face_settings()
        if enabled:
            self.publish_face_request(self.face_settings)
            self.face_status.setText("Face LEDs enabled; settings requested.")
            self.face_status.setStyleSheet("color: #7dd3fc;")
            if self.last_face_motion_status:
                self.apply_automatic_face(self.last_face_motion_status)
        else:
            self.face_test_timer.stop()
            self.face_test_steps = []
            self.publish_face_request(self.face_settings)
            self.face_status.setText("Face LEDs disabled (effect off requested).")
            self.face_status.setStyleSheet("color: #94a3b8;")

    def face_mode_changed(self, *_args):
        if self.face_catalog is None:
            return
        try:
            self.face_settings = self.current_face_settings()
        except FaceConfigError:
            return
        self.face_automation.set_settings(self.face_settings)
        self.persist_face_settings()
        if self.face_settings.enabled and (
            self.face_settings.locked or not self.face_settings.automatic
        ):
            self.publish_face_request(self.face_settings)
            self.face_status.setText(
                "Manual expression selected; safety overrides remain enabled."
            )
            self.face_status.setStyleSheet("color: #fbbf24;")
        if self.face_settings.enabled and self.last_face_motion_status:
            self.apply_automatic_face(self.last_face_motion_status)

    def stop_face_leds(self):
        if self.face_enable.isChecked():
            self.face_enable.setChecked(False)
        else:
            self.ros_node.publish_face_effect("off")

    def restore_default_face(self):
        if self.face_catalog is None:
            return
        self.face_settings = default_face_settings(self.face_catalog)
        self.face_automation.set_settings(self.face_settings)
        self.set_face_controls(self.face_settings)
        self.persist_face_settings()
        self.publish_face_request(self.face_settings)
        self.face_status.setText("Default idle face restored and requested.")
        self.face_status.setStyleSheet("color: #7dd3fc;")
        if self.last_face_motion_status:
            self.apply_automatic_face(self.last_face_motion_status)

    def start_face_test(self):
        if self.face_catalog is None or self.face_settings is None:
            return
        self.face_test_steps = [
            ((255, 0, 0), "red"),
            ((0, 255, 0), "green"),
            ((0, 0, 255), "blue"),
            ((255, 255, 255), "white"),
        ]
        self.face_test_button.setEnabled(False)
        self.face_status.setText("Testing solid red, green, blue, and white.")
        self.face_status.setStyleSheet("color: #7dd3fc;")
        self.advance_face_test()
        self.face_test_timer.start()

    def advance_face_test(self):
        if not self.face_test_steps:
            self.face_test_timer.stop()
            self.face_test_button.setEnabled(True)
            if self.face_settings.enabled:
                self.publish_face_request(self.face_settings)
                self.face_status.setText("LED test complete; prior face restored.")
            else:
                self.ros_node.publish_face_effect("off")
                self.face_status.setText("LED test complete; face restored off.")
            self.face_status.setStyleSheet("color: #86efac;")
            return
        color, name = self.face_test_steps.pop(0)
        self.ros_node.publish_face_color(color)
        self.ros_node.publish_face_brightness(
            max(40, self.face_settings.brightness)
        )
        self.ros_node.publish_face_effect("solid")
        self.face_status.setText("Testing solid %s." % name)

    def apply_automatic_face(self, status):
        if (
            self.face_automation is None
            or self.face_settings is None
            or not self.face_settings.enabled
            or self.face_test_timer.isActive()
        ):
            return
        decision = self.face_automation.update(status)
        if decision is None:
            return
        if decision.reason == "manual":
            requested = self.face_settings
        else:
            requested = settings_for_preset(
                self.face_catalog,
                decision.expression,
                self.face_settings,
            )
        self.publish_face_request(requested)
        if decision.safety_override:
            text = "SAFETY OVERRIDE: %s" % decision.expression.upper()
            color = "#fca5a5"
        elif decision.restored:
            text = "Automatic face complete; restored %s." % self.face_settings.expression
            color = "#86efac"
        elif decision.reason != "manual":
            text = "Automatic %s (%s)." % (
                decision.expression,
                decision.reason.replace(":", " "),
            )
            color = "#7dd3fc"
        else:
            return
        self.face_status.setText(text)
        self.face_status.setStyleSheet("color: %s;" % color)

    def refresh_firmware_link_health(self, fields):
        """Render the firmware's link counters on the DIAGNOSTICS tab.
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
