benurapriyanidirisinghe/VOLT/src/volt_description/test/test_serial_bridge.py

#!/usr/bin/env python3

"""Unit tests for the ROS-to-Arduino serial bridge without a ROS graph."""

import importlib.util
import math
import sys
import types
import unittest
from pathlib import Path
from unittest.mock import Mock, patch


ROOT = Path(__file__).resolve().parents[1]
SCRIPTS = ROOT / "scripts"
sys.path.insert(0, str(SCRIPTS))


class _Logger:
    def __init__(self):
        self.infos = []
        self.warnings = []
        self.errors = []

    def info(self, message, *args, **kwargs):
        self.infos.append(str(message))

    def warning(self, message, *args, **kwargs):
        self.warnings.append(str(message))

    def error(self, message, *args, **kwargs):
        self.errors.append(str(message))


class _Publisher:
    def __init__(self):
        self.messages = []

    def publish(self, message):
        self.messages.append(message)


class _Time:
    def __init__(self, nanoseconds):
        self.nanoseconds = nanoseconds


class _Clock:
    def __init__(self, node):
        self.node = node

    def now(self):
        return _Time(self.node._test_now_nanoseconds)


class _Parameter:
    def __init__(self, value):
        self.value = value


class _Node:
    """Small rclpy Node stand-in sufficient for bridge construction."""

    def __init__(self, name):
        self.name = name
        self._parameters = {}
        self._logger = _Logger()
        self._test_now_nanoseconds = 1_000_000_000
        self._publishers = []
        self._subscriptions = []
        self._timers = []
        self._publisher_info_counts = {}

    def declare_parameter(self, name, default_value):
        self._parameters[name] = default_value
        return _Parameter(default_value)

    def get_parameter(self, name):
        return _Parameter(self._parameters[name])

    def get_logger(self):
        return self._logger

    def get_clock(self):
        return _Clock(self)

    def create_publisher(self, *args, **kwargs):
        publisher = _Publisher()
        self._publishers.append(publisher)
        return publisher

    def create_subscription(self, *args, **kwargs):
        subscription = types.SimpleNamespace(args=args, kwargs=kwargs)
        self._subscriptions.append(subscription)
        return subscription

    def create_timer(self, *args, **kwargs):
        timer = types.SimpleNamespace(args=args, kwargs=kwargs)
        self._timers.append(timer)
        return timer

    def get_publishers_info_by_topic(self, topic):
        return [
            object()
            for _index in range(self._publisher_info_counts.get(topic, 1))
        ]


class _Float64MultiArray:
    def __init__(self, data=None):
        self.data = list(data or [])


class _String:
    def __init__(self, data=""):
        self.data = data
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
