benurapriyanidirisinghe/VOLT/(commit log)

2026-07-06 Initial VOLT simulation workspace
    [backpart.stl, controllers.yaml, empty_ign.sdf, foot.stl, frontpart.stl, gait_controller.yaml, gazebo.xacro, larm.stl]
2026-07-07 Add hardware control integration
    [gait_controller.yaml]
2026-07-18 Add servo calibration and emote controls
    [controllers.yaml, gait_controller.yaml, ros2_control.xacro, servo_calibration.yaml, volt.urdf.xacro]
2026-08-18 Restore control GUI and fix serial, ARM and emote reliability
    The 204 KB control GUI had been overwritten by a 24 KB stub that also
    dropped the MOTION-ownership and ARM controls, so the robot could not be
    driven at all. It was never committed, so it was rebuilt by replaying the
    233 apply_patch operations from the editor transcripts and reconciling the
    result against the surviving bytecode until all 174 code objects compiled
    identically.
    Serial path: the link ran at 57600 with servo updates gated on an idle
    wire, so a 28% duty cycle starved the 20 ms interpolation tick, and a
    corrupted frame failed to feed the 750 ms watchdog while its own error
    reply lengthened the next loop block and corru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
    [controllers.yaml, empty_ign.sdf, gait_controller.yaml, real_robot_profiles.yaml, ros2_control.xacro, servo_calibration.yaml, volt.urdf.xacro]
2026-08-18 Rebuild walking ground-up: two servo-budgeted gaits verified in Ignition
    The nine previous gaits across four code paths are removed and replaced by
    one engine with exactly two gaits: a two-beat diagonal trot (duty 0.58,
    1.1 s cycle, 0.12 m/s) and a four-beat lateral-sequence amble (duty 0.76,
    2.0 s cycle, three feet always planted, body sway away from the swinging
    side). Every historical gait name aliases onto one of the two, so saved
    profiles and old commands keep working.
    The core design change is that the TD-8130MG's behavior under load is now a
    configuration contract instead of an afterthought. The swing leg is
    unloaded and can run near the servo's ~375 deg/s free speed; the stance
    legs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
    [controllers.yaml, gait_controller.yaml, real_robot_profiles.yaml, ros2_control.xacro, volt.urdf.xacro]
2026-08-21 Tune walking in the loaded-servo Ignition model
    Iterated against the td8130mg actuator profile until both gaits walk
    consistently rather than occasionally. The dynamic trot proved bistable on
    marginal servo torque: identical code produced either a clean 1.1 m / 4 deg
    run or a 0.1 m / 10 deg rocking run depending on how it entered the limit
    cycle. Three changes close that:
    - trot cycle 1.1 -> 0.9 s and duty 0.58 -> 0.62: less time falling onto
    each diagonal and twice the four-foot load-transfer window, with step
    height 24 -> 20 mm and max_x 0.12 -> 0.10 m/s to stay inside the servo
    budgets (revalidated by the load-time sweep).
    - command ramp 0.25 -> 0.08 m/s^2 (amble 0.15 -> 0.06): rea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
    [gait_controller.yaml]
2026-08-23 Assert gait phase structure; fix amble to a true lateral sequence
    Investigating a report that the hardware paces while commanding a trot.
    Simulation was measured first, from data rather than inspection: 22 s of
    Gazebo /joint_states run through forward kinematics, stance derived from
    foot height, phases by cross-correlation. The sim trots correctly --
    diagonal pairs 0.0 deg apart, ipsilateral 179.2 deg, 91% of the cycle with
    exactly two feet down -- so the generator and the whole ROS command path
    are sound and the fault is downstream of them.
    A permuted phase table is not malformed. It is four valid numbers in the
    wrong places, so every length and finiteness check on the command path
    still p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
    [volt_arduino_pca9685.ino, volt_gait_controller.py, volt_kinematics.py]
2026-08-25 Stand taller to get the trot inside the servo torque budget
    The robot shook in place instead of walking. Measured cause: in a two-foot
    diagonal trot the whole 52 N rides on two feet, which at the 0.200 m stance
    put the front knee at 1.855 N.m -- 105% of the ~1.76 N.m a TD-8130MG really
    delivers on a shared BEC. A servo at stall makes torque and no motion, so no
    foot ever cleared the ground (commanded 20 mm lift, ~1.4 mm measured), all
    four feet stayed correlated, and the gait energy went into heaving the chassis.
    Standing taller is the fix, not commanding more lift. A straighter leg has a
    shorter knee moment arm, so at 0.210 m the same load needs 1.317 N.m (75% of
    usable stall). Lowering th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
    [gait_controller.yaml, real_robot_profiles.yaml, servo_calibration.yaml]
2026-08-26 Fix the cross-wired front foot servos that made the robot pace
    ch2 and ch5 were swapped on the hardware. A live per-channel test with raw
    SERVO commands -- which bypass the joint->channel table entirely, so what moves
    is decided by the wiring -- showed ch2 physically drives the FRONT-RIGHT foot
    and ch5 the FRONT-LEFT. The table said the opposite.
    That single fault explains the whole investigation. With the two front feet
    crossed, the physical legs received these trot phases:
    before: front_right + rear_right @ 0.00, front_left + rear_left @ 0.50
    after: front_left + rear_right @ 0.00, front_right + rear_left @ 0.50
    Before is SIDE PAIRS, which is a pace. That is the symptom this al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
    [real_robot_profiles.yaml, servo_calibration.yaml]
2026-08-26 Record that the PCA channel map is measured on all twelve channels
    Every channel was wiggled individually on the robot with the channel tester,
    whose raw SERVO commands bypass the joint->channel table, and the leg that
    moved was recorded by eye. Full sweep: match on all twelve, including ch11,
    which until now rested on elimination alone.
    That matters because elimination is exactly the reasoning that hid the ch2/ch5
    cross-wiring. The note in the mapping test now says so, and says to re-run the
    sweep rather than infer a channel if these values are ever edited again.
2026-08-26 Add the body_x balance test for the rear feet not clearing
    During a trot the front feet clear the ground and the rear feet do not.
    Commanded lift is identical on all four legs (20.00 mm) and knee sweep is
    identical too, so it is not the trajectory. The compliance says the opposite
    of the symptom:
    front sum(arm^2) = 0.009718 (knee moment arm 71.4 mm)
    rear sum(arm^2) = 0.007009 (knee moment arm 48.8 mm)
    At EQUAL load the front sinks about 39% MORE than the rear, so for the rear to
    be the pair that fails it must be carrying materially more weight -- the centre
    of mass has to sit at least 15 mm behind centre. That offset cannot be read
    from the model: none of the URDF's <inertial> b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
    [volt_body_balance_test.py]
2026-08-27 Stage 1: binary FRAME with CRC, decoupled LEDs, I2C burst, link counters
    Measured on the robot: 60 s of trot walking with the face animating now
    reports 4728 binary frames, 0 CRC failures, 0 sequence gaps. Before this the
    link produced roughly 0.9 ERR/s (UNKNOWN_COMMAND / BAD_COUNT).
    Mechanism confirmed by A/B on hardware before any fix was trusted. A build of
    the PREVIOUS firmware with only the two NeoPixel show() calls compiled out --
    five lines, one variable -- walked 60 s with zero errors. Adafruit_NeoPixel
    masks interrupts ~30 us/pixel; eight pixels blank the UART receive ISR for
    ~240 us against roughly 80 us of tolerance at 250000 baud, so every face
    refresh was a gamble that no frame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
    [test_serial_protocol.py, volt_arduino_pca9685.ino, volt_control_gui.py, volt_serial_bridge.py, volt_serial_protocol.py]
2026-08-27 Add the measurement and reporting console
    One window for the three quantities that turned out to be one question on
    this robot: link health, commanded gait geometry, and the knee torque budget.
    LINK shows the firmware's own counters and states the stage-1 verdict
    outright (CRC failures and sequence gaps both zero = PASS).
    GAIT computes what the engine actually commands for any gait, body height,
    speed scale and yaw trim, through the repo's own gait engine, IK and
    calibration -- so it is the real command path, not a model of it. It reports
    per-leg stride and lift, hip and knee sweep, peak commanded rate against the
    firmware ceiling, IK-projected legs, clamped or guarded joints, and the two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
    [volt_measure_gui.py]
2026-08-27 Add stand-pose calibration, and fix two instrumentation defects
    The operator's report from the measurement console exposed both defects, and
    one of them had been silently wrong since the counters were added.
    I2C_MAX_US was never parseable. _STATUS_FIELD is r"\b([A-Z_]+)=..." and does
    not accept a digit, so a field name beginning "I2C" can never be captured --
    the GUI showed "?" for it and would have forever. Renamed to BUS_MAX_US, with
    a test that asserts every FIRMWARE_COUNTER_FIELDS name is capturable by that
    regex so the next digit-bearing name fails in CI instead of in a report.
    LOOP_MAX_US was measuring its own reporting. A STATUS reply is a few hundred
    bytes and beyond the 64-byte TX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
    [test_serial_protocol.py, volt_arduino_pca9685.ino, volt_control_gui.py, volt_measure_gui.py, volt_serial_protocol.py, volt_stand_calibration_gui.py]
2026-08-27 Add RUN as a third gait, at the wall the servo budget actually allows
    RUN is a fast trot, not a new coordination: the same diagonal phase pairs,
    run faster with a shorter stance. A true run needs duty < 0.5 and a flight
    phase, which is not something to declare on open-loop hobby servos with a
    documented saturation history -- it is something to approach in steps.
    It ships at 1.30 Hz, duty 0.50, step_height 0.026, stride +20%. That is the
    FASTEST configuration validate_servo_budget will accept: above 1.30 Hz the
    shorter swing pushes the unloaded leg past its 190 deg/s budget. So the
    shipped point is a hardware wall, not a preference, and it is exactly the
    "duty 0.5 at high cadence" outcome th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
    [gait_controller.yaml, servo_calibration.yaml]
2026-08-27 Fix RUN's stride collapse, and log the resolved gait set on every switch
    A2 answered by direct computation, and the bug was mine. RUN's commanded
    x-sweep was 29.6 mm against the trot's 83.3 -- steps nearly THREE TIMES
    SMALLER at nearly three times the cadence. Steps that size lose entirely to
    stance slip, which is precisely "correct cadence, zero effective stride":
    the robot ran on the spot.
    Cause: stride = max_x * hardware_speed_scale * duty * cycle_period. RUN's
    "+20% stride" was applied to max_x, the velocity LIMIT, while cadence rose
    2.7x and duty fell 0.62 -> 0.50. Both of those divide the stride, so the
    stride shrank despite the larger limit.
    max_x cannot simply be raised to compensa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
    [gait_controller.yaml]
2026-08-27 Correct the servo stall figure: it was a guess, and the robot disproved it
    The operator reports the robot performs push-ups carrying 2 kg of added
    payload without difficulty. That is a direct measurement and it contradicts
    the usable-stall figure every torque conclusion here rested on.
    A 60 mm push-up at 7.30 kg on four feet demands 2.141 N.m at the front knee.
    A 5.30 kg trot on two diagonal feet demands 1.855 N.m. The push-up is the
    HARDER case, and it is easy. So usable stall is at least 2.14 N.m -- 73% of
    the 2.94 N.m datasheet figure, not the 60% (1.76 N.m) previously assumed.
    That assumption came from a plausible-sounding argument about twelve servos
    sharing one BEC, with no measureme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
    [gait_controller.yaml]
2026-08-28 Make the command path visible, and fix what that revealed
    The operator reported the robot only walking with both sliders at max, a
    frozen phase clock, and feet dragging. Tracing the full path from slider to
    servo found several real faults, most of them silent.
    Servo budget guard was validating the wrong trajectory. validate_servo_budget
    swept a body-frame helper using plain smoothstep, while the engine flies a
    world-frame interpolation whose body-relative shape has non-zero end
    velocities. It understated RUN's peak swing as 173 deg/s where the engine
    commands 190 -- the entire budget reported as headroom. swing_transfer() now
    derives the shape the engine actually flies, and a test drives bo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
    [gait_controller.yaml, real_robot_profiles.yaml, servo_calibration.yaml]
2026-08-28 Add a split Jetson/workstation stack, and fix the clean-clone build
    The Arduino moves to a Jetson on the same network. The nodes with a real
    deadline -- motion controller, router, serial bridge -- go with it; the
    console, the gamepad and the Ignition shadow stay on the workstation. The
    firmware disarms after 750 ms without a frame, so the loop feeding it should
    not be sharing a machine with a renderer.
    Two new launch files, deliberately non-overlapping:
    volt_jetson.launch.py robot half. No Gazebo, no GUI. Reuses
    control.launch.py with gui:=false so the two
    paths cannot drift apart.
    volt_operator.launch.py console half. No hardwar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
    [test_launch_configuration.py]
2026-08-28 Arm the split-stack teardown before the checks that can abort it
    Found by running the runner against a Jetson with no Arduino attached: it
    died at the port check and left a stack from an earlier launch still
    streaming. The trap was installed after the preflight checks, so the one
    failure most likely to happen in practice was the one that skipped cleanup.
    The teardown is now defined and trapped immediately after the reachability
    check, and the leftover sweep runs there too. Verified: a second run with no
    Arduino kills the previous pgid, exits 1, and leaves nothing on the Jetson.
    Also provision the UDP-only DDS profile on the Jetson from the runner
    instead of assuming it exists. Shared memor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
    [test_launch_configuration.py]
2026-08-28 Make the gamepad tab a controller map instead of a list of dropdowns
    Twenty-four rows of combo boxes made the operator translate "Button 5" into
    a physical thumb position before they could bind anything. The tab now opens
    on a drawn controller: click a control to bind it, and the binding is
    written next to it on a leader line, the way an in-game control map reads.
    Drawn with QPainter rather than shipped as an image on purpose. One
    coordinate table produces the artwork, the hit regions and the callout
    lines, so a control cannot be painted in one place and be clickable in
    another -- and the whole thing recolours with the theme, stays sharp at any
    size, and can light a control up the instant i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
    [test_gamepad_bindings.py, volt_control_gui.py]
2026-08-28 Make the sticks bindable too, and show them moving
    The controller map covered every button and the D-pad but stopped at L3/R3,
    which are only the stick PRESSES. The sticks themselves were three
    hard-coded axis indices with hard-coded signs:
    left_x -> horizontal, -left_y -> forward, -right_x -> yaw trim
    A stick cannot be bound to an action the way a button is, because it is
    continuous -- it drives a signal. So axes bind to signals instead:
    drive_forward, drive_horizontal (steer in Normal mode, strafe in Crab,
    exactly as the on-screen joystick already behaves) and yaw_trim. Each axis
    also carries an invert flag, because the sign convention belongs to the pad
    rather than the robot: most r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
    [test_gamepad_bindings.py, volt_control_gui.py, volt_gamepad_bindings.py]
2026-08-28 Show which machine the robot half is running on
    With the split Jetson stack the console looks identical whether the nodes
    driving the servos are on this PC or across the network, which is a console
    that can mislead. The header now carries a robot-link indicator, visible
    from every tab:
    Robot link: ros2-pc -> jetson-ros [REMOTE] 10 Hz
    The motion controller and the serial bridge each announce their own
    gethostname(), so the indicator reports where the nodes ACTUALLY are rather
    than what mode somebody thought they launched. Both are resolved once at
    import: gethostname() can touch the resolver and the controller's publisher
    runs inside a 100 Hz loop.
    Freshness is measured as age-since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
    [test_launch_configuration.py, volt_control_gui.py, volt_motion_controller.py, volt_serial_bridge.py]
2026-08-28 Do not report 0 Hz on a link that is plainly alive
    The rate needs a full one-second window before it means anything, so a
    freshly connected robot link showed a green indicator reading "0 Hz" --
    which looks like a fault. It now reports the status age until the first
    window closes, then switches to the measured rate.
    Caught by running the console against the real Jetson stack rather than a
    fake: linked at "live 0.00 s", settled to "10 Hz" after three seconds, and
    on killing the Jetson half degraded through "slow 1.6 s" to "STALE 4.1 s".
2026-08-28 Add an ESP32-S3 servo board on WiFi, replacing the Arduino and its cable
    The Arduino Nano and its USB link are replaced by an ESP32-S3 DevKitC-1
    (N16R8) reached over WiFi. Everything else runs on the workstation exactly
    as the PHYSICAL mode does -- console, gamepad, motion controller, router,
    bridge, Ignition shadow. Only the last hop changes.
    FIRMWARE (firmware/volt_esp32_pca9685). Derived from the Nano sketch rather
    than rewritten, because the protocol, the channel guards, the slew limit,
    the ARM handshake, the command timeout and the STATUS counters are what the
    host was built and tested against. All 193 print sites work unchanged
    against a Stream-shaped HostLink that reads and writes th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
    [esp32_stub.py, test_gamepad_bindings.py, test_net_link.py, test_serial_protocol.py, volt_esp32_pca9685.ino, volt_net_link.py, volt_serial_bridge.py]
2026-08-28 Scan for networks before joining, and report the link quality
    The board had one hard-coded SSID and, if it could not join, said only that
    it had failed. That is the least useful thing to say: the reason is almost
    always visible in a scan.
    It now scans and prints what it can see -- RSSI, channel, encryption, and
    whether each network is one of the configured ones -- then joins the
    STRONGEST configured network that is actually on the air rather than the
    first in the list. A robot carried between a bench and a floor should not
    need reflashing, and joining a weak AP while a strong one is present is how
    a 60 Hz servo stream starts stuttering.
    WIFI_NETWORKS is a table now, so several networks can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
    [test_net_link.py, test_serial_protocol.py, volt_control_gui.py, volt_esp32_pca9685.ino, volt_serial_protocol.py]
2026-08-28 Keep the WiFi password out of a public repository
    The board needs real credentials; this repository is public, and a password
    committed to it is a password published. History rewriting does not undo
    that either, because clones and caches already have it.
    So the sketch now includes wifi_credentials.h when it exists, and that file
    is gitignored. wifi_credentials_example.h is the tracked template, and a
    CHANGE_ME fallback plus a #warning keeps a fresh clone compiling and tells
    whoever cloned it what to do.
    Tests assert the template exists, that the ignore rule is present, that the
    real header is not tracked if it is present locally, and that the in-sketch
    fallback stays a placeholder rather t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
2026-08-28 Fix five ESP32 link faults that only appear on a network transport
    Found by running the real board rather than the stub. Every one of these is
    invisible over a UART, which is why the stub passed and the hardware did not.
    1. Print::print(F("...")) hands bytes over one at a time. With TCP_NODELAY
    each became its own packet, so a ~300 byte STATUS line turned into ~300
    tiny segments, overran the LwIP send buffers, and the reply vanished.
    PING still worked because it is short -- which made it look like a STATUS
    bug rather than a transport one. HostLink now buffers to end-of-line, the
    way a UART coalesces naturally.
    2. A real STATUS carrying the WiFi fields measured 523 bytes agai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
    [test_net_link.py, volt_esp32_pca9685.ino, volt_serial_protocol.py]
2026-08-28 Cut WiFi control latency: 48 ms board loop down to 1.7 ms
    An audit of the whole path plus per-section timing on the board itself. The
    board now profiles its own loop (NET/READ/SERVO/FACE_MAX_US in STATUS)
    rather than leaving a 48 ms figure unattributed, which is what made this
    findable at all.
    THE BIG ONE, and it was not where it looked. readSerialLines() is written
    for a UART: it calls available() once per byte and reads one byte at a time.
    On a socket every one of those entered the lwIP stack, so asking whether a
    byte was ready cost more than the byte -- 38 ms with NO data pending, 47 ms
    under load. It also corrupted the parser: between available() saying yes and
    read() being called the s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
2026-08-28 Count servo frames on arrival, not on application
    FRAMES_BIN sat after the "not armed, move nothing" early return, so it
    counted frames APPLIED rather than frames RECEIVED. A disarmed board on a
    perfectly healthy link therefore reported
    FRAMES_BIN=0 CRC_FAIL=0 SEQ_GAP=0
    which reads as "nothing is arriving" when the truth is "nothing is being
    applied, exactly as intended". The host's link-health panel uses this
    counter as its evidence that the transport works, and being disarmed is
    precisely when an operator wants that evidence -- before arming, not after.
    Cost me a full diagnostic cycle on real hardware: bytes arrived, magic bytes
    were seen, frame starts were accepted, and the count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
2026-08-28 Detect a dead ESP32 host with TCP keepalive, not with silence
    The board dropped the console every few seconds and the handshake never
    finished: connected=1, ready=0, protocol_version=0, on a loop.
    The cause was my own idle timeout. It assumed a live host is continuously
    chatty, and this one is not: the bridge streams frames only while ARMED, and
    its STATUS poll is gated behind protocol.armed as well, so a perfectly
    healthy pre-arm console legitimately sends NOTHING, indefinitely. Silence
    was never evidence of a dead peer. Raising the timeout would only have moved
    the loop further out.
    Keepalive asks the question properly. An idle-but-alive host answers the
    probes in the kernel with no appl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
2026-08-28 Actually call the keepalive helper, and fix the test that missed it
    The previous commit defined enableClientKeepalive() and never called it. An
    earlier edit had inserted setTimeout(0) between the two lines the patch was
    matching, so the call site silently did not apply -- the board was flashed
    with no dead-peer detection at all. It looked fine because the same commit
    removed the silence-based drop, so nothing was dropping the console either.
    Caught by the test I wrote for the new mechanism, which asserted the call
    site rather than only the definition. That is the assertion that earned its
    place: a helper that exists but is never invoked passes any test that checks
    for the helper.
    Two test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
    [test_net_link.py, volt_esp32_pca9685.ino]
2026-08-28 Try every visible network, strongest first, instead of only the best one
    Both SSIDs were already saved and the board already scanned and joined the
    strongest, but the selection returned a single candidate. If that one
    refused the join -- wrong password, AP full, a hotspot that advertises but
    will not accept -- the next retry rescanned, chose the same loser again, and
    the other configured network was never tried at all. Two saved networks, one
    of which could actually be used.
    visibleNetworksByStrength() now returns every configured network the scan can
    see, ordered by RSSI, and the join walks down that list until one accepts.
    Duplicate SSIDs (a repeater, or the same name on two channels) are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
    [test_net_link.py, volt_esp32_pca9685.ino]
2026-08-28 Drop Gazebo from the ESP32 WiFi mode
    volt_wifi.launch.py went through volt_start.launch.py, which always brings
    Ignition up -- its gui argument only decides whether the window is shown, so
    even headless the simulator, gz_ros2_control, robot_state_publisher and the
    clock bridge were all running.
    None of that earns its place here. Under hardware the motion controller is
    open-loop and ignores /joint_states entirely, so Ignition was only ever
    rendering the COMMANDED pose: useful for a demo, and pure cost when the real
    robot is in front of you and the stack has a 750 ms disarm deadline to meet.
    The mode now composes control.launch.py plus the serial bridge directly, the
    same shape volt_jetson.l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
2026-08-28 Show the servo link's health before ARM, not only after
    The firmware counters -- frames arriving, CRC clean, sequence gaps, RSSI --
    were polled only once protocol.armed was true. That is backwards for a
    pre-flight check: the operator deciding whether it is safe to arm had no
    evidence at all, and the console filled that gap only after the servos were
    already live. On the WiFi board it is worse still, because those counters
    are the only evidence the radio link works.
    STATUS is now polled while disarmed too, at 5 s rather than 10. The window
    that actually needed protecting is the ARM handshake, not the disarmed
    state: a STATUS query sets serial_query_inflight and the post-ARM cached
    frame refu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
2026-08-29 Give a WPA2 join enough time; 8 s declared good networks dead
    Shortening the per-candidate join deadline from 15 s to 8 s was meant to
    make failover snappier. On the real board it did the opposite: at -65 dBm on
    a busy 2.4 GHz band the join needed longer, and the console printed exactly
    forty dots -- 8 s of 200 ms waits -- and then
    NextGen Starlink 2.4GHz refused the join (wrong password?)
    every visible configured network refused.
    on a network whose password is correct and which the same board had joined
    earlier in the day. Declaring a working network dead is a far worse failure
    than a slow join, and the message actively misleads: it points at the
    credentials when the problem is th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
    [test_net_link.py, volt_esp32_pca9685.ino]
